andrewlau2080/IO_BOARD/.vendor/AT32F45x_Firmware_Library_V2.0.1/utilities/at32f457_emac_iap_demo/source_code/app_led3_toggle/readme.txt

/**
  **************************************************************************
  * @file     readme.txt
  * @brief    readme
  **************************************************************************
  */

  this demo is based on the at-start board, in this demo, shows the app code
  operating flow for at32f4xx series. led3 on the at-start board is twinkling
  when app code is running. for more detailed information, please refer to 
  the application note document AN0086.
