andrewlau2080/IO_BOARD/.vendor/AT32F45x_Firmware_Library_V2.0.1/utilities/at32f457_emac_iap_demo/source_code/bootloader/readme.txt

/**
  **************************************************************************
  * @file     readme.txt
  * @brief    readme
  **************************************************************************
  */

  this demo is based on the at-start board, in this demo, shows the bootloader
  operating flow for at32f4xx series. led2 on the at-start board is twinkling
  when iap bootloader is running. for more detailed information, please refer to
  the application note document AN0086.
