andrewlau2080/IO_BOARD/.vendor/AT32F45x_Firmware_Library_V2.0.1/project/at_start_f455/examples/adc/combine_ordinary_shift_tmr1trgout_dma2/readme.txt

/**
  **************************************************************************
  * @file     readme.txt
  * @brief    readme
  **************************************************************************
  */

  this demo is based on the at-start board, in this demo, shows how to use
  combine_mode(ordinary shift mode only).
  the trigger source is: tmr1trgout,,and use dma mode 2 transfer conversion data
  the convert data as follow:
  - adccom_ordinary_valuetab[n] ---> (adc2_channel_5<<16) | adc1_channel_2

  for more detailed information. please refer to the application note document AN0242.
