andrewlau2080/IO_BOARD/.vendor/AT32F45x_Firmware_Library_V2.0.1/project/at_start_f455/examples/adc/voltage_monitoring/readme.txt

/**
  **************************************************************************
  * @file     readme.txt
  * @brief    readme
  **************************************************************************
  */

  this demo is based on the at-start board, in this demo, shows how to
  monitoring adc channel's voltage.
  the trigger source is software
  the convert data as follow:
  - adc1_ordinary_valuetab[0] ---> adc1_channel_2
  - adc1_ordinary_valuetab[1] ---> adc1_channel_3
  - adc1_ordinary_valuetab[2] ---> adc1_channel_4
  the voltage monitoring channel is: adc1_channel_3

  for more detailed information. please refer to the application note document AN0242.
