andrewlau2080/IO_BOARD/.vendor/AT32F45x_Firmware_Library_V2.0.1/project/at_start_f455/examples/aes/cbc/readme.txt

/**
  **************************************************************************
  * @file     readme.txt 
  * @brief    readme
  **************************************************************************
  */

  this demo is based on the at-start board, in this demo, shows how to use 
  aes with cbc chaining mode. please refer to the application note document
  an0249.
