andrewlau2080/IO_BOARD/.vendor/AT32F45x_Firmware_Library_V2.0.1/project/at_start_f455/examples/can/loopback_mode/readme.txt

/**
  **************************************************************************
  * @file     readme.txt
  * @brief    readme
  **************************************************************************
  */

  this demo is based on the at-start board  and at32-comm-ev, in this demo, 
  shows how to use the can loopback mode. every 1s transmit one message 
  and the led4 blink, if the message can be received, led2 blink.
  set-up
  - can_tx(pd1)
  - can_rx(pd0)
  - can_stb(pb7)

  for more detailed information. please refer to the application note document AN0232.
