andrewlau2080/IO_BOARD/.vendor/AT32F45x_Firmware_Library_V2.0.1/project/at_start_f455/examples/can/transceiver_standby_mode/readme.txt

/**
  **************************************************************************
  * @file     readme.txt
  * @brief    readme
  **************************************************************************
  */

  this demo is based on the at-start board and at32-comm-ev, in this demo, 
  shows how to use the canfd transceiver standby mode. 
  the led4 on when mcu is in run mode and the canfd transceiver isn't in standby mode.
  the led4 off when mcu enter sleep mode and the canfd transceiver enter standby mode.
  it is wake up the canfd transceiver and mcu when received message, and ehco.
  set-up
  - can_tx(pd1)
  - can_rx(pd0)
  - can_stb(pb7)

  for more detailed information. please refer to the application note document AN0232.
