andrewlau2080/IO_BOARD/.vendor/AT32F45x_Firmware_Library_V2.0.1/project/at_start_f455/examples/dma/dmamux_genertor_exint/readme.txt

/**
  **************************************************************************
  * @file     readme.txt
  * @brief    readme
  **************************************************************************
  */

  this demo is based on the at-start board,  in this demo,  provides a  description
  of how to use a dmamux genertor channel send dma request to transfer a halfword 
  data buffer memory to another halfword data buffer in embedded sram.  dma1 channel4
  is configured to transfer the contents of a 16-halfword data buffer stored in 
  embedded sram memory.pa0 is input trigger signal for dmamux genertor channel1,
  genertor channel1 will send four dma request when the rising edge of pa0.when
  all data transfered, the three leds will turn on.
