andrewlau2080/IO_BOARD/.vendor/AT32F45x_Firmware_Library_V2.0.1/project/at_start_f455/examples/dma/dmamux_synchronization_exint/readme.txt

/**
  **************************************************************************
  * @file     readme.txt
  * @brief    readme
  **************************************************************************
  */

  this demo is based on the at-start board,in this demo, uses the tmr1 in dma synchronized 
  mode to send the contents of a 16-halfword data buffer stored in embedded sram memory.
  the dmamux synchronization block is configured to synchronize the dma transfer with the 
  tmr1 overflow dma request.each rising edge of pa0 the synchronization signal will authorize
  4 tmr1 requests to be transmitted src_buffer to dst_buffer using the dma.when all data 
  transfered, the three leds will turn on.
