andrewlau2080/IO_BOARD/.vendor/AT32F45x_Firmware_Library_V2.0.1/project/at_start_f455/examples/ertc/tamper/readme.txt

/**
  **************************************************************************
  * @file     readme.txt
  * @brief    readme
  **************************************************************************
  */

  this demo is based on the at-start board, in this demo, shows how to use the 
  tamper detection, the rising edge of the pc13 pin triggers an tamper event.
  for more detailed information. please refer to the application note document AN0047.
  
  attention: system need to pre configrue when pc13 need to be used!  the 
  pre-configuration code is in SystemInit() function.
