andrewlau2080/IO_BOARD/.vendor/AT32F45x_Firmware_Library_V2.0.1/project/at_start_f455/examples/exint/exint_software_trigger/readme.txt

/**
  **************************************************************************
  * @file     readme.txt
  * @brief    readme
  **************************************************************************
  */

  this demo is based on the at-start board, in this demo, shows how to use
  software trigger exint.
  software trigger will be generate in tmr1 overflow interrupt.
  led2 toggle means tmr1 overflow interrupt respond.
  led3 and led4 toggle means exint line 4  interrupt respond.
  for more detailed information. please refer to the application note document AN0104.
