andrewlau2080/IO_BOARD/.vendor/AT32F45x_Firmware_Library_V2.0.1/project/at_start_f455/examples/flash/otp_write_and_lock/readme.txt

/**
  **************************************************************************
  * @file     readme.txt
  * @brief    readme
  **************************************************************************
  */

  this demo is based on the at-start board, in this demo, test buffer will
  be wiriten to otp area and lock, then read from same address, then
  compare them. if the test is passed, the three leds will turn on.
  note: this demo can only be run once!
