andrewlau2080/IO_BOARD/.vendor/AT32F45x_Firmware_Library_V2.0.1/project/at_start_f455/examples/gpio/io_toggle/readme.txt

/**
  **************************************************************************
  * @file     readme.txt 
  * @brief    readme
  **************************************************************************
  */

  this demo is based on the at-start board, this demo toggle pa.01 forever,
  to describes how to use scr and clr register for max io toggling.
