andrewlau2080/IO_BOARD/.vendor/AT32F45x_Firmware_Library_V2.0.1/project/at_start_f455/examples/i2c/eeprom/readme.txt

/**
  **************************************************************************
  * @file     eeprom/readme.txt 
  * @brief    readme
  **************************************************************************
  */

  this demo is based on the at-start board and AT32-Comm-EV, in this demo, use hardware i2c2 
  write or read data based on the eeprom device. if the communication is
  successful, led3 will turn on, if the communication fails, led2 will keep flashing.
  
  attention:
    1. i2c bus must pull-up
    2. press the slave button first, then press the master button to start communication.

  pin used:
    1. scl --- pb10
    2. sda --- pb11

  for more detailed information. please refer to the application note document AN0091.
