andrewlau2080/IO_BOARD/.vendor/AT32F45x_Firmware_Library_V2.0.1/project/at_start_f455/examples/i2sf/halfduplex_dma_msb_justified/readme.txt

/**
  **************************************************************************
  * @file     readme.txt
  * @brief    readme
  **************************************************************************
  */

  this demo is based on the at-start board, in this demo, shows how to constitute
  a halfduplex i2s module by i2sf module.
  the pins distribution as follow:
  - halfduplex i2s
  - i2sf5 master          spi i2s slaver
  - pb6(ws)      <--->     pb12(ws)
  - pb7(ck)      <--->     pb13(ck) 
  - pb9(sd)      <--->     pb15(sd)
  - pc8(mck) 

  for more detailed information. please refer to the application note document AN0102.
