andrewlau2080/IO_BOARD/.vendor/AT32F45x_Firmware_Library_V2.0.1/project/at_start_f455/examples/pwc/power_optimization_level_set/readme.txt

/**
  **************************************************************************
  * @file     readme.txt
  * @brief    readme
  **************************************************************************
  */

  this demo is based on the at-start board, in this demo, shows how to set the ldo
  output voltage when deepsleep mode.
  
  the rising edge on pa0 will wake up deepsleep mode

  for more detailed information. please refer to the application note document AN0244.
