andrewlau2080/IO_BOARD/.vendor/AT32F45x_Firmware_Library_V2.0.1/project/at_start_f455/examples/pwc/sleep_usart1/readme.txt

/**
  **************************************************************************
  * @file     readme.txt
  * @brief    readme
  **************************************************************************
  */

  this demo is based on the at-start board, in this demo, shows how to exit
  sleep mode by interrupt of usart1 receive data buffer full.

  for more detailed information. please refer to the application note document AN0244.
