andrewlau2080/IO_BOARD/.vendor/AT32F45x_Firmware_Library_V2.0.1/project/at_start_f455/examples/qspi/xip_port_read_write_sram/readme.txt

/**
  **************************************************************************
  * @file     readme.txt 
  * @brief    readme
  **************************************************************************
  */

  this demo is based on the at-start board, in this demo, systick used for 
  delay function. qspi xip port operate write/read sram, if qspi test pass,
  led3 fresh, else led2 fresh.
  the qspi sram is ly68l6400. 
  - qspi io0   --->   pf8
  - qspi io1   --->   pf9
  - qspi io2   --->   pf7
  - qspi io3   --->   pf6
  - qspi sck   --->   pf10
  - qspi cs    --->   pg6

  for more detailed information. please refer to the application note document AN0088.
