andrewlau2080/IO_BOARD/.vendor/AT32F45x_Firmware_Library_V2.0.1/project/at_start_f455/examples/spi/halfduplex_dma/readme.txt

/**
  **************************************************************************
  * @file     readme.txt
  * @brief    readme
  **************************************************************************
  */

  this demo is based on the at-start board, in this demo, shows how to use
  dma transfer data in halfduplex mode. 
  the pins connection as follow:
  - spi2                      spi1
    pb12(cs)        <--->     pa4(cs)
    pb13(sck)       <--->     pa5(sck)
    pb14(miso)      <--->     pa7(mosi)

  for more detailed information. please refer to the application note document AN0102.
