andrewlau2080/IO_BOARD/IO_BOARD/docs/io_scan_mapping.md

# IO Scan Mapping And Position Codes

This document defines the shared firmware point model for both IO board hardware
variants. Firmware remains common; connector differences are selected by scan
profile and board wiring.

## Logical Points

| Item | Range | Position code | Notes |
|---|---:|---|---|
| Output source points | `OUT001` ... `OUT128` | `0x0001` ... `0x0080` | Driven one point at a time during scan |
| Input sense points | `IN001` ... `IN128` | `0x0101` ... `0x0180` | Read one point at a time during scan |

Position code format:

| Bits | Meaning |
|---|---|
| `bit 8` | `0` = OUT, `1` = IN |
| `bits 7:0` | 1-based point number, `1` ... `128`; `0` is invalid |

Examples:

| Logical point | Position code |
|---|---:|
| `OUT001` | `0x0001` |
| `OUT064` | `0x0040` |
| `OUT065` | `0x0041` |
| `OUT096` | `0x0060` |
| `OUT128` | `0x0080` |
| `IN001` | `0x0101` |
| `IN064` | `0x0140` |
| `IN065` | `0x0141` |
| `IN096` | `0x0160` |
| `IN128` | `0x0180` |

## Firmware Scan Profiles

| Profile ID | Firmware name | Valid OUT points | Valid IN points | Hardware variant |
|---:|---|---:|---:|---|
| `0` | `old_db50_96x96` | `OUT001` ... `OUT096` | `IN001` ... `IN096` | Legacy-compatible DB50 |
| `1` | `db78_64x4_128x128` | `OUT001` ... `OUT128` | `IN001` ... `IN128` | DB78 separated IN/OUT |
| `2` | `first_gen_1th_96x96` | `OUT001` ... `OUT096` | `IN001` ... `IN096` | `1thsch.pdf` first-gen local CD4051 board |

For `old_db50_96x96`, points `OUT097` ... `OUT128` and `IN097` ... `IN128`
are reserved and must be treated as invalid by the firmware protocol.

## Mux Bank Mapping

| Logical range | Firmware mux bank | Mux index |
|---|---|---:|
| `OUT001` ... `OUT064` | `IO_MUX_OUT_A` | `0` ... `63` |
| `OUT065` ... `OUT128` | `IO_MUX_OUT_B` | `0` ... `63` |
| `IN001` ... `IN064` | `IO_MUX_IN_A` | `0` ... `63` |
| `IN065` ... `IN128` | `IO_MUX_IN_B` | `0` ... `63` |

During a pair read, firmware selects one OUT mux channel and one IN mux channel,
waits for the settle delay, then calls `io_scan_measure_selected_pair()`.
That function is a weak stub in common builds. Product-specific measurement
code can replace it with a strong implementation.

## First-Gen `1thsch.pdf` Mapping

The first-gen local board is not Raspberry Pi based and does not use 74LS164 in
this schematic. It uses direct AT32 GPIO control of CD4051 address and enable
signals:

| Circuit half | Logical range | OUT excitation | IN sense | Firmware mux bank |
|---|---|---|---|---|
| A half | `OUT/IN001` ... `OUT/IN048` | `DAC_OUT1` / `PA4` | `ADC1_IN0` / `PA0` | `IO_MUX_OUT_A`, `IO_MUX_IN_A` |
| B half | `OUT/IN049` ... `OUT/IN096` | `DAC_OUT2` / `PA5` | `ADC2_IN2` / `PA2` | `IO_MUX_OUT_B`, `IO_MUX_IN_B` |

The first-gen schematic is specified so each CD4051 uses the natural channel
order:

```text
CD4051 channel 0 -> DACA/DACB IN0 or OUT0
CD4051 channel 1 -> DACA/DACB IN1 or OUT1
...
CD4051 channel 7 -> DACA/DACB IN7 or OUT7
```

The firmware therefore uses natural zero-based mux indexes for
`first_gen_1th_96x96`. The A/B split is still 48+48 points, but there is no
per-8-channel remap table.

The MCU2 GPIO control nets in `1thsch.pdf` page 4 are:

| Net group | MCU pins |
|---|---|
| `IN_AMUX_A0/B1/C2` | `PC0` / `PC1` / `PC2` |
| `IN_AMUX_EN0..EN7` | `PE0`, `PE1`, `PE2`, `PE3`, `PE4`, `PE5`, `PE6`, `PE7` |
| `IN_BMUX_A0/B1/C2` | `PB0` / `PB1` / `PB2` |
| `IN_BMUX_EN0..EN7` | `PE8`, `PE9`, `PE10`, `PE11`, `PE12`, `PE13`, `PE14`, `PE15` |
| `OUT_AMUX_A0/B1/C2` | `PC10` / `PC11` / `PC12` |
| `OUT_AMUX_EN0..EN7` | `PD0`, `PD1`, `PD2`, `PD3`, `PD4`, `PD5`, `PD6`, `PD7` |
| `OUT_BMUX_A0/B1/C2` | `PB10` / `PB11` / `PB12` |
| `OUT_BMUX_EN0..EN7` | `PD8`, `PD9`, `PD10`, `PD11`, `PD12`, `PD13`, `PD14`, `PD15` |

Use the latest `SCH_FIXTURE_2026-07-07.pdf`
mapping for `OUT_BMUX_EN0..EN7`: `PD8..PD15`. Do not use the older
`PD9..PD15, PC6` record for this board revision.

## Legacy DB50 Connector Mapping

Each physical DB50 connector has two corresponding 25-pin rows:

| Connector | Upper row pins 1-24 | Lower row pins 1-24 | Row pin 25 |
|---|---|---|---|
| `JOLD1` | `OUT001` ... `OUT024` | `IN001` ... `IN024` | NC |
| `JOLD2` | `OUT025` ... `OUT048` | `IN025` ... `IN048` | NC |
| `JOLD3` | `OUT049` ... `OUT072` | `IN049` ... `IN072` | NC |
| `JOLD4` | `OUT073` ... `OUT096` | `IN073` ... `IN096` | NC |

Pin formula for DB50 row pins 1-24:

| Formula | Meaning |
|---|---|
| `point = (connector_index - 1) * 24 + row_pin` | `connector_index` is `1` ... `4`; `row_pin` is `1` ... `24` |
| upper row position | `OUT%03u`, code `0x0000 | point` |
| lower row position | `IN%03u`, code `0x0100 | point` |

## DB78 64x4 Connector Mapping

| Connector | Used pins | Logical points |
|---|---:|---|
| `JOUT1` | 1-64 | `OUT001` ... `OUT064` |
| `JOUT2` | 1-64 | `OUT065` ... `OUT128` |
| `JIN1` | 1-64 | `IN001` ... `IN064` |
| `JIN2` | 1-64 | `IN065` ... `IN128` |

Pin formula for DB78 used pins 1-64:

| Connector | Formula |
|---|---|
| `JOUT1` | `OUT point = pin` |
| `JOUT2` | `OUT point = 64 + pin` |
| `JIN1` | `IN point = pin` |
| `JIN2` | `IN point = 64 + pin` |
