andrewlau2080/IO_BOARD/IO_BOARD/docs/production_line_terminal_model.md

# Production Line Terminal And Print Model

This document models the next two development blocks before the old first-gen
tester communication protocol is fully decoded.

## Current First-Gen Scan Dependency

| Item | Current status |
|---|---|
| Local scan mode | `FIRST_GEN_4051_LOCAL` implemented |
| Standard definition | AT32 self-learns a known-good 96 x 96 matrix and saves it in Flash |
| Display behavior | Left three digits show current OUT; right three digits show the current problem IN |
| Print gating rule | Print response must only be enabled after the learned-matrix scan reaches PASS |
| Block condition | If the display is stopped on a problem OUT/IN point, the tester must not send a print-ready response |

## 1. Production Line Communication Placeholder

The production line has up to 10 tester stations. Each tester normally runs its
own local IO scan. The line is a rotating loop. After an operator finishes a
board, the fixture moves to a terminal/print position. When the current tester
is detected at that position, it sends a print request to the terminal unit.

Current implementation rule:

- The printer-side polling/trigger packet has been decoded from
  `TestV1.0/analysis_outputs/useful_printer_trigger_tx_envelope.csv`.
- `src/line_comm_bridge.c` now contains this 71-segment packet as
  `LINE_COMM_CODE_PRINT_REQUEST`.
- Verified on 2026-06-03: oscilloscope testing confirmed the printer-side
  polling transmitter outputs the intended packet envelope. The previous
  continuous-carrier symptom was fixed by using DWT-based microsecond timing
  for MARK/SPACE generation and by forcing the inter-packet SPACE low.
- The tester-side response packet is generated at build time from
  `TestV1.0/analysis_outputs/useful_tester_response_tx_envelope.csv` and is
  exposed as `LINE_COMM_CODE_TESTER_RESPONSE`.
- Current firmware model waits for the printer polling packet prefix on `PB7`.
  When the first 12 segments match `LINE_COMM_CODE_PRINT_REQUEST`, it starts
  the tester response at about 24.786 ms from the detected polling packet start.
  It then transmits `LINE_COMM_CODE_TESTER_RESPONSE` once from `PB6` and
  returns to waiting for the next printer polling packet.
- Other old-link response/ack code slots remain empty until they are learned.
- Keep local tester logic independent from the terminal protocol so scanning
  and UI work can continue before the old protocol is decoded.

Firmware placeholder files:

| File | Role |
|---|---|
| `inc/line_comm_bridge.h` | Production-line communication data types and API |
| `src/line_comm_bridge.c` | Empty learned-code slots for print request/ack/busy/done |

Current reserved old-link code slots:

| Code ID | Purpose | Current status |
|---|---|---|
| `LINE_COMM_CODE_PRINT_REQUEST` | Printer polling/trigger packet for tester side | Filled, 71 MARK/SPACE segments |
| `LINE_COMM_CODE_TESTER_RESPONSE` | Tester response packet after printer trigger | Filled, 3321 MARK/SPACE segments generated from CSV |
| `LINE_COMM_CODE_PRINT_ACK` | Terminal accepts request | Empty timing table |
| `LINE_COMM_CODE_PRINT_BUSY` | Terminal is busy | Empty timing table |
| `LINE_COMM_CODE_PRINT_DONE` | Print job completed | Empty timing table |

Current printer polling transmitter settings:

| Item | Value |
|---|---:|
| Source analysis file | `TestV1.0/analysis_outputs/useful_printer_trigger_tx_envelope.csv` |
| Segment count | 71 |
| Packet duration | about 36.695 ms |
| Repeat period | about 203.147 ms |
| Inter-packet space | about 166.452 ms |
| Carrier half period | 12 us |
| Estimated carrier | about 41.7 kHz |
| Firmware output pin | `PB6` / `IR_TX` |
| Envelope debug pin | 07-07 schematic has no final PH3 debug pin assignment; use only if a new test point is explicitly added |
| Bench verification | Confirmed normal on 2026-06-03 with the old `PA7=IR_TX` bench wiring; current 2026-07-07 schematic uses `PB6=IR_TX` |

Current closed-loop tester response settings:

| Item | Value |
|---|---:|
| Source analysis file | `TestV1.0/analysis_outputs/useful_tester_response_tx_envelope.csv` |
| Printer polling prefix required | First 12 segments of `LINE_COMM_CODE_PRINT_REQUEST` |
| Response trigger delay | about 24.786 ms from polling packet start |
| Segment count | 3321 |
| Packet duration | about 2.151 s |
| Carrier half period | 13 us |
| Estimated carrier | about 38.5 kHz |
| Firmware output pin | `PB6` / `IR_TX` |
| Envelope debug pin | 07-07 schematic has no final PH3 debug pin assignment; use only if a new test point is explicitly added |
| Loop behavior | Receive prefix, transmit once, guard 100 ms, wait again |

When the learned IR frame is available, fill the placeholder like this:

```c
static const uint16_t print_request_code_us[] = {
  9000, 4500, 560, 560, /* ... learned timings ... */
};

const line_comm_ir_code_t g_line_comm_ir_codes[LINE_COMM_CODE_COUNT] = {
  {0U, sizeof(print_request_code_us) / sizeof(print_request_code_us[0]), print_request_code_us},
  /* ... */
};
```

## 2. Terminal Printer Architecture

The terminal should not try to drive every printer directly from AT32 firmware.
Use a Raspberry Pi or Linux terminal as the print server:

```text
Tester AT32 boards
  -> old learned line protocol / future UART-RS485-CAN
  -> Terminal controller
  -> CUPS / IPP / printer driver layer
  -> USB / Ethernet / Wi-Fi printer
```

Recommended approach:

| Layer | Responsibility |
|---|---|
| Tester AT32 | Scan result, station ID, product ID, print request trigger |
| Terminal app | Dialog/input UI, label template, job queue, print history |
| CUPS/Linux print system | Printer discovery, driverless IPP, vendor driver support |
| Printer | Actual output device |

This is the only practical way to support a wide printer range. Direct MCU
printer support should be limited to known label-printer languages such as
ESC/POS, TSPL, ZPL, or CPCL after the exact printer family is selected.

## 3. Print Job Data Model

Firmware placeholder files:

| File | Role |
|---|---|
| `inc/print_job_model.h` | Common label fields and sizes |
| `src/print_job_model.c` | ASCII label formatting helper |

Initial fields:

| Field | Example | Notes |
|---|---|---|
| `title` | `HARNESS TEST` | Label header |
| `item` | `MODEL-A` | Product/model name |
| `content` | `LINE 01 STATION 03` | Body/content |
| `code` | `A1B1-000001` | Human-readable code or barcode text |
| `quantity` | `1` | Quantity/count |
| `pass` | `PASS` | Test result |

For the MCU-side model, keep the first stage ASCII-only because it is simple,
stable, and compact. The terminal UI can use UTF-8 and real fonts when printing
PDF or raster output through CUPS.

## 4. UI Model

The first visual model is:

| File | Role |
|---|---|
| `terminal/print_terminal_mockup.html` | Browser-based terminal dialog and label preview |

The mockup has:

- Station selection for 10 tester stations.
- Title, item/model, content, code, quantity, result, and copies fields.
- Label preview similar to a product label.
- Print queue preview.

This is not the final terminal program. It fixes the field layout and workflow
before choosing the final UI technology.

## 5. Future Runtime Flow

```text
1. Tester learns a known-good harness matrix and stores it in Flash.
2. Operator runs normal test; tester scans row by row.
3. If a problem is found, tester display stays on current OUT/problem IN and print is blocked.
4. After all rows pass, tester enters print-ready state.
5. Fixture reaches print terminal sensor position.
6. Tester receives the learned printer polling prefix.
7. Tester sends the learned tester response code.
8. Terminal receives request and loads the current label template.
9. Operator can edit title/item/content/code through terminal key input.
10. Terminal prints through CUPS.
11. Terminal sends PRINT_DONE or PRINT_BUSY/ERROR to tester when that return code is decoded.
```

## 6. Firmware Integration Status

| Step | Firmware block | Status |
|---:|---|---|
| 1 | First-gen scanner | Full learned-matrix PASS sets `g_first_gen_print_ready` |
| 2 | IR receiver | Printer polling prefix is captured on `PB7` while print-ready is armed |
| 3 | IR transmitter | `LINE_COMM_CODE_TESTER_RESPONSE` is transmitted on `PB6` after the learned delay |
| 4 | State control | NG/unlearned states block response; current implementation clears print-ready after one response |
| 5 | Debug counters | Poll match, reject, response sent, blocked, ready, and waiting states are exposed as watch variables |
| 6 | Bench test | Next required step: verify timing with oscilloscope and confirm terminal/printer receives the response |

## 6A. Line Communication Transport Layer

Current firmware now separates line communication from the scan and print
business logic through `line_comm_transport`.

| Role | Current backend | Firmware behavior |
|---|---|---|
| Scanner / tester | IR transmit | After PASS, sends `LINE_COMM_CODE_PRINT_REQUEST` once as a print trigger |
| Print terminal | IR receive | Polls for the `LINE_COMM_CODE_PRINT_REQUEST` prefix and prints the current LCDM job when it matches |
| Future wireless | Placeholder | Add a wireless UART/Sub-GHz/LoRa backend behind the same transport API |
| Future wired | Placeholder | Add RS485 backend behind the same transport API |

The present IR trigger is a fixed learned waveform. It only means "print now";
it does not carry variable fields such as station, product, result, or serial
number. Those fields are still edited on LCDM or held in the terminal state.
When the wireless UART/RS485 backend is added, `line_comm_print_request_t` can
be serialized to carry station/result/test count without changing the scan or
print modules.

Detailed transport planning is tracked in `docs/line_comm_transport_plan.md`.

## 7. Open Decisions

| Decision | Current placeholder |
|---|---|
| Old first-gen protocol waveform | Polling and tester response are available; ACK/BUSY/DONE still require learned timing data |
| Print terminal hardware | Raspberry Pi/Linux terminal recommended |
| Exact printer class | CUPS first; direct ESC/POS/TSPL/ZPL only after printer is fixed |
| Label size | Mockup default; final size to be updated after printer/label media selection |
| Key input method | Independent module later |
