andrewlau2080/IO_BOARD/IO_BOARD/docs/wifi_mas_network_architecture.pptx

WiFi / MAS 组网架构说明

用于设计评审、演示和后续跟踪

每条拉本地闭环生产，MAS 负责上级管理和统计

先固定组网与互联框架
每条拉配置微型/工业 AP
WiFi 模块型号后续再选

车间十几条拉

每条拉约 10 台测试机

每条拉 1 台 AP + 打印主机

MAS 断线仍可本线打印

IO BOARD WiFi / MAS

## Slide 2

MAS 在系统中的角色

MAS 负责上级管理和统计，不是本线打印的前置条件

为什么需要 MAS

• 统一监控所有测试机和打印机
• 集中保存测试、打印、报警记录
• 支持电脑、手机、手持机查看
• 为后续数据分析提供完整资料

不能直接互连

• 多台测试机抢同一台打印机
• 跨线统计和追溯困难
• 换机、换打印机管理复杂
• APP 无法稳定同时监控多条线

MAS 的定位

• 监控中心
• 统计中心
• 资料版本中心
• 历史追溯中心

IO BOARD WiFi / MAS

## Slide 3

车间网络拓扑

每条拉有本地 AP 和打印主机，MAS 断线不影响本线打印

MAS / Monitor / Statistics Server

Factory Ethernet / VLAN / Uplink

Line 01 微型/工业 AP

ST01 ... ST10 WiFi Station
AT32 Print Host
Printer

Line 02 微型/工业 AP

ST01 ... ST10 WiFi Station
AT32 Print Host
Printer

Line NN 微型/工业 AP

ST01 ... ST10 WiFi Station
AT32 Print Host
Printer

正式方案：每条拉 1 个独立微型/工业 AP；AP 只提供网络，生产逻辑由本线 AT32 打印主机完成。

IO BOARD WiFi / MAS

## Slide 4

系统分层

上层业务协议不绑定 WiFi 模块，模块以后可替换

设备层
测试机 + WiFi

线体层
AP + 打印主机

车间层
VLAN / Uplink

MAS 层
监控/统计/DB

客户端
APP/电脑

测试机

• 本地扫描
• PASS/NG
• 故障点
• 上传事件

AT32 打印主机

• 本线主控
• 打印队列
• 本地缓存
• 继续打印

网络

• VLAN 隔离
• MAS 同步
• NTP
• 远程维护

MAS

• 全车间监控
• 历史记录
• 统计报表
• 资料管理

客户端

• 查看
• 报警
• 统计
• 追溯

IO BOARD WiFi / MAS

## Slide 5

正常测试与打印流程

打印关键路径在本线闭环内完成，MAS 只接收同步和做统计

测试机 -> 本线主机
heartbeat

本地扫描
PASS/NG

结果到打印主机
缓存/可同步 MAS

PB8 触发
打印请求

打印主机
排队打印

打印状态
DONE/ERROR

测试机

• 不直接控制打印机
• 发给本线打印主机

打印主机

• 本线队列
• 驱动打印机
• 缓存结果

MAS

• 接收同步
• 统计报表
• 刷新电脑/APP

IO BOARD WiFi / MAS

## Slide 6

MAS 断线时仍可生产打印

MAS 不是打印前置条件；本线打印主机是 AT32 打印主机

测试机 ST01-ST10

本线 AP

打印主机
本地队列/缓存

打印机

MAS 离线
不影响打印

MAS 断线

• 本线 AP 仍工作
• 打印主机继续接收请求

缓存位置

• 主要存在 AT32 打印主机
• 测试机只做短缓存

恢复后

• 打印主机按 event_id 补传
• MAS 去重并生成统计

IO BOARD WiFi / MAS

## Slide 7

对码与换机流程

打印主机本地完成换机；MAS 在线即同步，离线后补传

K1+K4
进入对码

PAIR_REQ
UID/短码

LCDM 选择
绑定/替换

PAIR_ASSIGN
Line/Station/Profile

PAIR_ACK
保存成功

换机原则

• 工位不变
• 新 UID 替换旧 UID
• 旧设备 inactive

资料恢复

• 产品资料
• 学习线序
• 打印规则
• 无需重新学习

记录连续

• 本线先保存
• binding_event 后同步

IO BOARD WiFi / MAS

## Slide 8

CSV / Profile 下发

测试规划先到本线 AT32 打印主机，再由打印主机分发给各测试机

AT32 打印主机
校验/保存/生成 CRC

PC 上位机
CSV 编辑/导入

本线 AP
只提供网络

ST01-ST10
profile_push

MAS 在线
接收 profile_sync

CSV 内容

• OUT/IN 对应关系
• 开路/短路/GND/NC
• 必测标志和版本

主机校验

• 范围检查
• 重复/冲突检查
• profile_rev + crc32

断网处理

• 使用已保存 profile
• 继续生产打印
• 恢复后补传 MAS

IO BOARD WiFi / MAS

## Slide 9

MQTT / API 数据通道

本线消息先到打印主机；打印主机再同步 MAS

telemetry

event

state

cmd

ack

Topic: factory/{factory}/workshop/{workshop}/line/{line}/device/{uid}/{suffix}

设备 -> 打印主机

• heartbeat
• test_result
• print_request
• alarm

打印主机 <-> MAS

• 缓存同步
• profile_sync
• summary
• history

API / Dashboard

• 历史查询
• 统计报表
• 手机 APP
• 电脑监控

IO BOARD WiFi / MAS

## Slide 10

测试机状态机

网络只是上传、同步和打印请求通道，本地测试必须独立运行

BOOT

WIFI_CONNECT

REGISTER

SYNC_CONFIG

READY

TESTING

LEARNING

PASS_READY

PRINT_REQUESTED

PRINT_DONE

PAIRING

OFFLINE_CACHE

ERROR_LOCK

原则：本地测试不依赖 MAS；测试机连不上打印主机时短缓存，恢复后先补给打印主机。

IO BOARD WiFi / MAS

## Slide 11

打印主机状态机

每条线保留一台打印主机，负责本线绑定、队列、打印和缓存

BOOT

REGISTERING

LOAD_CONFIG

LINE_READY

PRINTING

本线主机

• 保存 ST01-ST10 绑定
• 保存当前产品资料
• 保存标签模板

打印队列

• 接收 print_request
• 生成标签
• 回传 DONE/ERROR

离线能力

• MAS 离线仍可打印
• 本地缓存后补传

IO BOARD WiFi / MAS

## Slide 12

数据记录与统计

测试记录、打印记录、报警记录统一入库，后续数据分析从数据库生成

主表

• devices
• line_bindings
• products
• profiles
• test_results
• print_jobs
• device_events
• alarms

统计输出

• 每条线产量
• 工位 PASS/NG 率
• 常见故障点 OUT/IN
• 打印失败率
• 设备在线率
• 单件 serial 追溯

客户端显示

• 车间总览
• 线体状态
• 单机状态
• 报警确认
• 趋势报表
• 换机辅助

IO BOARD WiFi / MAS

## Slide 13

断网缓存与可靠性

MAS 异常不影响本线打印；缓存主要放在 AT32 打印主机

断网场景

• 测试机到打印主机断开
• 打印主机到 MAS 断开
• MAS 服务器离线
• 重复上报
• 时间未同步

处理策略

• 本地继续测试
• 本线继续打印
• 打印主机为主缓存
• event_id 去重
• 恢复后补传

建议容量

• 测试机 200-1000 条短缓存
• 打印主机 5000-50000 条
• 打印机本体不做业务缓存
• 优先用 eMMC/SD/外部 Flash/FRAM

IO BOARD WiFi / MAS

## Slide 14

WiFi 模块边界

第一版按 ESP32-C3-WROOM-02U/02 设计，AT32 保持业务主控

业务层
scan/print/pair

mas_protocol
JSON/ACK

net_service
UART 通道

ESP32-C3-WROOM
WiFi 协处理器

第一版优先

• 打印主机: WROOM-02U
• 测试机: 02U 或 02
• AT32 仍做业务主控

PCB 风险

• 19-25 内部 GND
• 必须按规格书回流焊
• 天线区域严格禁布

维修友好

• 可做 WiFi 子板
• 主板只留 J_WIFI
• 后续换型不大改板

IO BOARD WiFi / MAS

## Slide 15

WiFi PCB 连接

参考 docs/esp32-c3-wroom-02_datasheet_cn.pdf 和 wifi_module_pcb_connection_plan.md

AT32 PC3候选
WIFI_TX

ESP32 Pin11
RXD

EN不占AT32
上拉+RESET_TP

BOOT不占AT32
上拉+BOOT_TP

AT32 PB9候选
WIFI_RX

ESP32 Pin12
TXD

3V3_WIFI
>=500mA 峰值

GND 焊盘
含内部 19-25

原理图

• PC3->RXD, PB9<-TXD
• PA1/PA3/PD8 禁用
• EN/BOOT 只留测试点

电源

• 模块旁 10uF + 0.1uF
• 可加 22uF/47uF
• WiFi 分支预留磁珠/0R

布局

• 02U 外接天线
• 02 板载天线禁布
• 优先参考刘氏PDF规格书

IO BOARD WiFi / MAS

## Slide 16

下一步实施计划

先做本线 AP + 打印主机闭环，再接 MAS 同步和模块验证

阶段 1: 架构与原型

• 设备身份和绑定表
• MQTT topic / JSON 消息
• CSV/Profile 上传流程
• WiFi PCB 连接规格

阶段 2: 固件接入

• net_service 抽象
• event_queue 断网缓存
• print_request WiFi 后端
• pair_req / pair_assign

阶段 3: 模块验证

• WROOM-02U 直贴
• WiFi 子板
• 天线和距离测试
• 可靠性和干扰测试

IO BOARD WiFi / MAS
