andrewlau2080/IO_BOARD/IO_BOARD/docs/hardware_redesign_change_list_2026-07-02.docx

# IO BOARD 硬件更改清单 2026-07-02

用途：给重新设计原理图和 PCB layout 使用。依据为当前调试后的固件状态、SCH_FIXTURE_2026-06-30.pdf、红外打印 LOGIC 测试结果，以及当前产品规划。

说明：扫描/LEDM 测试机与打印接收/LCDM 主机可以共用固件源码，但硬件产品角色应独立，避免共享引脚冲突。

# 总体原则

序号 | 项目 | 结论 | 原因/说明 | 优先级
1 | 模块独立 | 扫描/LEDM 测试机与打印接收/LCDM 主机不要在同一硬件上同时使用共享接口 | 固件可统一，但硬件 BOM/连接必须按产品角色选择，否则 PB6/PB7、PA9/PA10 等资源会冲突 | 必须
2 | 电平 | 所有 MCU IO 外部信号必须限制在 0-3.3V | AT32F455 GPIO 不允许直接承受 5V 输入；4051 建议 3.3V 供电 | 必须
3 | 测试点 | IR_TX、IR_RX、LEDM_CLK/TX、LEDM_DIO/RX、SWDIO、SWCLK、NRST 必须加测试点 | 本轮调试证明没有测试点会严重拖慢定位 | 必须

# 公共硬件必须修改

序号 | 模块 | 当前/风险 | 建议修改 | PCB Layout 注意事项 | 优先级
1 | SWD 调试口 | 必须确认没有把 PA13 占作 DEBUG_TTL_TX 或其它功能 | J_SWD 固定为：VREF/3.3V、GND、PA13/SWDIO、PA14/SWCLK、NRST | SWD 走线短、旁边放 GND；NRST 上拉 10k，可加 100nF 到 GND | 必须
2 | NRST | 调试和量产下载需要稳定复位 | 新增或确认 NRST 到 SWD 口和复位按键 | NRST 远离强干扰，保留测试点 | 必须
3 | BOOT0 | 防止上电进错模式 | BOOT0 默认 10k 下拉到 GND，可加跳帽到 3.3V | 靠近 MCU，避免悬空 | 建议
4 | 3.3V 电源 | TM1637、4051、IR 接收头均依赖 3.3V | 每个模块接口附近加 100nF；IR 接收头旁加 100nF + 4.7uF | 电源线宽足够，IR LED 驱动电流不要从 MCU IO 直接供 | 必须

# 扫描 IO 与 4051

序号 | 信号/模块 | MCU 引脚 | 建议修改 | 原因/说明 | 优先级
1 | OUT_A 地址 | PC10/PC11/PC12 | 保留 | 当前固件 io_board.c 使用这 3 根控制 OUT_A 4051 地址 | 必须
2 | OUT_A EN | PD0-PD7 | 保留，低有效 | 4051 inhibit/enable 默认禁用，高电平禁用，选中时拉低 | 必须
3 | OUT_B 地址 | PB10/PB11/PB12 | 若 B 区暂时不用，可保留但允许 DNP | 当前程序可屏蔽 B 区，硬件建议预留方便后续扩展 | 建议
4 | OUT_B EN | PD9-PD15、PC6 | 按新版图纸/固件保留，不要接成 PD8-PD15 | 之前已核对过 OUT_B 第 8 路是 PC6 | 必须
5 | IN_A 地址 | PC0/PC1/PC2 | 保留 | 当前固件使用 | 必须
6 | IN_A EN | PE0-PE7 | 保留，低有效 | 当前固件使用 | 必须
7 | IN_B 地址 | PB0/PB1/PB2 | 若 B 区暂时不用，可保留但允许 DNP | 后续扩展用 | 建议
8 | IN_B EN | PE8-PE15 | 若 B 区暂时不用，可保留但允许 DNP | 后续扩展用 | 建议
9 | 扫描输出激励 | PA4/PA5 | 保留测试点；确认通过前端进入 4051/线束 | 当前程序使用 PA4/PA5 作输出激励，前端需匹配 3.3V IO | 必须
10 | 扫描输入检测 | PA0/PA2 | 保留测试点；当前暂按普通数字输入验证 | ADC 方案此前不稳定，硬件需预留可选 RC/保护/分压，避免直接 5V | 必须
11 | 4051 供电 | 74HC4051 VCC | 统一 3.3V 供电 | MCU 3.3V 控制 HC4051 在 3.3V 供电下电平匹配 | 必须
12 | 外部输入保护 | IN/OUT 到 4051/MCU | 加限流/钳位/分压或明确只允许 3.3V | 任何外部 5V 都不能直接进入 3.3V 4051/MCU | 必须

# LEDM / TM1637 显示与按键

序号 | 信号 | MCU 引脚 | 建议连接 | 原因/说明 | 优先级
1 | LEDM_CLK 或 LEDM_TX | PA9 | 接 TM1637 CLK；若使用串口 LEDM，则接模块 RX | 当前 PCB 没引出 PA6/PA7，最终采用 PA9/PA10；注意名称按模块类型定义 | 必须
2 | LEDM_DIO 或 LEDM_RX | PA10 | 接 TM1637 DIO；若使用串口 LEDM，则接模块 TX | 当前固件 TM1637 使用 PA9/PA10 作为 GPIO，不是 USART | 必须
3 | LEDM 电源 | 3.3V/GND | J_LEDM 至少 4 pin：3.3V、GND、PA9、PA10 | 选 3.3V 可用的 TM1637/LEDM 模块 | 必须
4 | 上拉 | PA9/PA10 | 若 TM1637，建议 4.7k-10k 上拉到 3.3V，或确认模块自带 | TM1637 CLK/DIO 开漏方式更稳 | 建议
5 | 按键 | TM1637 键盘 | K1-K4 使用 TM1637 键值，不建议另接 PC4-PC9 作为主按键 | 当前程序主要按 TM1637 键值定义：K1/K2/K3/K4 | 必须
6 | USART1 冲突 | PA9/PA10 | 使用 LEDM 时，不要同时接 RS485/RPI USART1 | PA9/PA10 已被 LEDM 占用 | 必须

# 红外打印通讯

序号 | 信号/模块 | 当前临时脚 | 建议最终硬件 | 原因/说明 | 优先级
1 | IR_TX | PB7 | 保留 PB7 作为 IR_TX，但必须用三极管/MOSFET 驱动 IR LED，不要 MCU 直接带 LED | PB7 已验证可输出；正式建议用硬件 PWM 载波 + 包络开关 | 必须
2 | IR_RX | PB6 | 接 38kHz 解调红外接收头 OUT，优先 3.3V 接收头 | PB6 当前用于接收返回/轮询信号；输入需上拉到 3.3V | 必须
3 | IR 接口 | J_IR | 建议 4-6 pin：3.3V、GND、IR_TX_LED+、IR_TX_DRV、IR_RX_OUT、可选 5V_LED | 方便独立调试和更换发射/接收组件 | 必须
4 | IR_TX 驱动极性 | PB7 高电平 = 发光 | 硬件按高电平打开驱动设计；若硬件反相，固件必须同步改极性 | 避免 MARK/SPACE 反相导致接收端不能解码 | 必须
5 | IR LED 电流 | 外接驱动 | 低边 N-MOS 或 NPN，串联限流电阻；按距离选择 20-100mA 脉冲电流 | MCU IO 不能直接输出大电流 | 必须
6 | IR 接收头供电 | 3.3V | 接收头旁 100nF + 4.7uF；OUT 到 PB6 可加 100R 串联 | 降低误码和供电噪声 | 建议
7 | 载波生成 | PB7/TMR4_CH2 或其它确认可 PWM 的脚 | 最终 PCB 要确认 IR_TX 引脚支持定时器 PWM；PB7 已实测能出约 38k | 正式代码应避免软件翻转载波的时序误差 | 必须
8 | 与 LCDM 冲突 | PB6/PB7 | 扫描/LEDM 测试机可用 PB6/PB7 做 IR；打印/LCDM 主机若用 PB6/PB7 做 LCDM 控制，则不能同时接 IR | 两种产品独立，BOM 或连接器要分开 | 必须

# 打印接收 / LCDM 主机硬件

序号 | 模块 | MCU 引脚/接口 | 建议修改 | 原因/说明 | 优先级
1 | LCDM SPI/控制 | PB3/SCK、PB5/MOSI、PB4/RESET、PB6/CMD、PB7/CS、PB8/BL | 打印主机保留 LCDM 接口；不要和测试机 IR PB6/PB7 同时使用 | LCDM 主机是另一类产品，可编译同固件但硬件角色不同 | 必须
2 | 打印机 RS485 | UART + RS485 收发器 | 增加 A/B、GND、屏蔽/机壳地可选；120R 终端电阻用拨码/跳帽 | 兼容 Zebra/其它打印机串口调试 | 必须
3 | RS485 方向控制 | 预留 DE/RE GPIO | 即使当前未定，也建议预留 0R/跳线或 MCU 控制脚 | 后续不同收发器/协议可能需要方向控制 | 建议
4 | 打印机参数调试 | LCDM | 硬件保留 LCDM 触摸串口/屏接口，软件可设置波特率、协议、标签内容 | 后续兼容不同机型 | 建议
5 | 无线模块 | ESP8266/ESP32 或 Sub-GHz UART | 预留 4-6 pin UART 模块口：3.3V、GND、TX、RX、EN/RST | 后续 10 台以上测试机联网/MES 兼容 | 建议

# PCB Layout 注意事项

序号 | 项目 | 要求 | 优先级
1 | IR_TX/PB7 | 从 MCU 到驱动管栅极/基极走线短；驱动管靠近 IR LED 接口；电流回路不要穿过 MCU 模拟输入区域 | 必须
2 | IR_RX/PB6 | 接收头远离 IR 发射大电流回路；OUT 线短，旁边走 GND；供电去耦贴近接收头 | 必须
3 | PA0/PA2 输入 | 远离 IR LED、RS485、LCD 背光大电流；保留滤波/保护位置 | 必须
4 | 4051 模拟路径 | IN/OUT 线束路径保持清晰，避免和高速/大电流线平行长距离耦合 | 必须
5 | SWD | 接口靠边，线短；PA13/PA14 不要串太大电阻，建议 22R-100R 以内或 0R | 必须
6 | 接口丝印 | 所有外接连接器标清方向和电平：3.3V、GND、TX/RX 或 CLK/DIO | 必须

# 当前固件对应关系

功能 | 当前固件引脚 | 备注
LEDM/TM1637 | PA9=CLK、PA10=DIO | 使用 GPIO 时序和 TM1637 键值
IR 打印测试 | PB7=IR_TX、PB6=IR_RX | 当前调试脚；正式建议硬件 PWM 载波
扫描输出 | PA4/PA5 | 数字输出激励
扫描输入 | PA0/PA2 | 当前按数字输入验证，ADC 暂不作为唯一依据
DEBUG_OUT | PH3 | 调试测试点
SWD | PA13/PA14/NRST | 必须保留，不得挪用
