andrewlau2080/IO_BOARD/IO_BOARD/docs/project_tracking_report_2026-05-28.docx

# IO BOARD 项目模型与变更状态跟踪表

项目 | 内容 | 项目 | 内容
整理日期 | 2026-05-28 | 项目目录 | /Users/andrewlau/qtprj/ARTERY
主工程 | IO_BOARD | 目标 MCU | AT32F455VET7 / LQFP100
当前主程序 | TM1637 六位七段数码管应用模拟版 | 当前重点 | 先建模型，加速扫描、显示、旧机通讯、打印终端后续整合

# 1. 模型总览对比表

序号 | 模块/模型 | 状态 | 已完成内容 | 关键文件 | 风险/未定项 | 下一步
1 | 开发环境与调试链路 | 可用 | Mac/Ubuntu CMake 构建；Ubuntu pyOCD 烧录；VS Code/OpenOCD 调试路径已记录。 | AGENTS.md IO_BOARD/README.md | 烧录前需确认 ICE USB 已接入 Ubuntu VM。 | 继续保持 Mac 与 Ubuntu 同步。
2 | 硬件分型 | 已建档 | 旧 DB50 与 DB78 64x4 两个硬件分型已拆目录；程序仍共用根工程。 | IO_BOARD/hardware/old_db50/ IO_BOARD/hardware/db78_64x4/ | PCB 和 BOM 仍需按最终方案细化。 | 继续补原理图、BOM、布局规则。
3 | IO 扫描模型 | 框架完成 | OUT/IN 位置码；profile；mux bank；扫描矩阵；单点/全点扫描 API。 | inc/io_scan.h src/io_scan.c docs/io_scan_mapping.md | 真实检测读取函数尚未实现。 | 实现 io_scan_measure_selected_pair() 并接入硬件检测。
4 | 树莓派/终端通讯协议 | 框架完成 | 二进制帧、CRC16、扫描命令、LED 七段命令、打印终端命令预留。 | inc/rpi_protocol.h src/rpi_protocol.c docs/rpi_protocol.md | 物理层 UART/RS485/CAN 尚未定稿。 | 实现命令分发器和真实串口收发。
5 | TM1637 显示与按键 | 已烧录测试 | J8 上 PA9=CLK、PA10=DIO；六位显示；四键读取。 | inc/tm1637_display.h src/tm1637_display.c docs/led7seg_module_selection.md | 最终面板按键顺序、亮度、电源电压还需实物确认。 | 按最终面板丝印调整键值映射和显示内容。
6 | 单 MCU 应用显示模拟 | 可运行 | 自检：A01b01 到 A92b92 后 StPASS；自动测试：A01b01 到 A92b92 后 AUPASS；重启/复位键有效。 | src/main.c | 当前只是显示模拟，没有真实 IO 判断。 | 接入扫描结果，错误时停留并显示 NG/SC/OP。
7 | 红外学习/回放工具 | 工具性质 | PA6 接收、PA7 发射；记录 timing 表；生成 HTML/SVG 波形。 | inc/ir_remote.h src/ir_remote.c debug/ir_render.py | 不是最终主程序；后续主要用于学习旧机码。 | 抓旧一代机与打印终端通讯码。
8 | 旧一代机/终端通讯占位 | 空槽已建 | 预留 PRINT_REQUEST、ACK、BUSY、DONE 四组 learned timing 码位。 | inc/line_comm_bridge.h src/line_comm_bridge.c | 旧机协议还未解码，码表为空。 | IR 学习后把 timing 数组直接填入空槽。
9 | 打印任务数据模型 | 模型完成 | 定义 title、item、content、code、quantity、copies、pass 等字段；支持 ASCII 标签格式化。 | inc/print_job_model.h src/print_job_model.c | 中文/字体/条码最终由终端侧处理。 | 对接终端 UI 和打印队列。
10 | 打印终端 UI 模型 | HTML 原型完成 | 10 台测试机选择；抬头、款项、内容、代码、数量、PASS/NG、份数；标签预览和队列。 | terminal/print_terminal_mockup.html docs/production_line_terminal_model.md | 打印机型号、标签纸尺寸、输入键盘方式未定。 | 按实际打印机和标签尺寸修改原型。

# 2. 当前固件运行行为表

项目 | 当前定义 | 显示例子 | 说明
显示硬件 | 六位 TM1637，地址 0xC0 到 0xC5 | A01b01 | 左三位为 A 端，右三位为 B 端。
接线 | J8 USART1 引脚当 GPIO 使用 | PA9=CLK，PA10=DIO | TM1637 不是 UART，只借用 J8 两根线。
按键 1 | 自检 | A01b01 ... A92b92 ... StPASS | 当前不检测 IO，只模拟显示流程。
按键 2 | 自动测试 | A01b01 ... A92b92 ... AUPASS | 当前不检测 IO，只模拟显示流程。
按键 3 | 重新开始 | 重跑上一次模式 | 上一次是自检就重跑自检，上一次是自动测试就重跑自动测试。
按键 4 | 复位重来 | 000000 | 停止当前流程并清屏到零。

# 3. 硬件方案对比表

方案 | 连接器 | 有效点数 | 显示/上位机 | 当前文档 | 当前状态
旧 DB50 单 MCU 版 | 4 个 DB50；每个上/下对应 24 组；第 25 组 NC | 96 OUT + 96 IN | 本地 TM1637/LED 七段显示；后续可加蜂鸣器/按键 | hardware/old_db50/README.md hardware/old_db50/BOM.md | 规格/BOM 基线已建
DB78 64x4 版 | 2 个 OUT DB78 + 2 个 IN DB78；每个用 64 PIN | 128 OUT + 128 IN | 树莓派/LCDM/上位系统 | hardware/db78_64x4/README.md hardware/db78_64x4/BOM.md | 规格/BOM 基线已建

# 4. 通讯与打印终端对比表

通道/对象 | 用途 | 当前实现 | 未完成点 | 建议路线
旧一代机协议 | 测试机到打印终端的旧通讯 | 已建 line_comm_bridge 空槽 | 未抓到真实码表 | 用 IR 学习程序抓码后填入 timing 数组。
树莓派/终端协议 | 新系统扫描、状态、打印请求 | 已定义二进制帧和命令号 | 未实现物理收发和命令分发 | 样机优先 UART；长线/多机再考虑 RS485/CAN。
打印机适配 | 支持市面打印机 | 终端模型已建 | 不应由 AT32 直接适配所有打印机 | 树莓派/Linux + CUPS/IPP/厂家驱动。
标签输入 UI | 抬头、款项、内容、代码、数量、份数 | HTML mockup 已建 | 按键输入程序独立开发 | 先定字段和标签版面，再接真实输入和打印。

# 5. 构建/同步/烧录状态表

环境 | 命令/路径 | 最近状态 | 备注
macOS | cd IO_BOARD && cmake --build build | 通过 | 使用本机 xPack ARM GCC。
Ubuntu VM | /home/andrew/ARTERY/IO_BOARD | 通过 | 已同步源码、文档、终端 mockup。
烧录 | Ubuntu pyOCD + AT-Link/ICE | 最近已烧录 TM1637 应用模拟版 | 本次文档重排未重新烧录。

# 6. 待办优先级表

优先级 | 任务 | 依赖 | 完成标准 | 负责人/位置
高 | 接入真实 IO 检测 | 检测电路/阈值确认 | 自检/自动测试能在错误点停留并显示故障类型。 | io_scan_measure_selected_pair()
高 | 旧机通讯码学习 | 拿到旧测试机/打印端实物 | PRINT_REQUEST/ACK/BUSY/DONE 四组码表填入并可发射/接收。 | line_comm_bridge.c
中 | 打印终端 UI 定稿 | 打印机、标签纸、输入方式 | 标签字段和版面确认，可进入实际终端程序。 | terminal/print_terminal_mockup.html
中 | 树莓派/终端程序选型 | 终端硬件确定 | 确定 Web/Qt/Python 等技术路线。 | 终端应用目录后续新增
中 | 硬件原理图/PCB | 旧 DB50 或 DB78 方案优先级 | 完成原理图、BOM、PCB 初版。 | IO_BOARD/hardware/
低 | 文档持续维护 | 每次阶段变更 | 本 Word 表格版本保持更新。 | project_tracking_report_*.docx
