andrewlau2080/IO_BOARD/IO_BOARD/docs/SCH_FIXTURE_2026-06-30_IO核对与修改建议.docx

# SCH_FIXTURE_2026-06-30 IO脚位核对与修改建议

## 1. 基本信息

项目 | 内容
依据图纸 | IO_BOARD/docs/SCH_FIXTURE_2026-06-30.pdf，第3页 MCU2 为主
目标MCU | AT32F455VET7，LQFP100
核对目的 | 明确扫描4051、SWD烧录、LCDM/LEDM显示、USART、CAN、调试和按键脚位，给出画图修改建议
结论摘要 | 4051扫描脚基本可保留；必须优先修正/确认 SWDIO/SWCLK、PA9/PA10显示冲突、LCDM SPI脚代码缺口、PA6/PA7 IR未在图纸确认。

## 2. 总体结论和优先级

模块 | 图纸现状 | 问题 | 建议
4051扫描脚 | IN/OUT A/B 地址线和使能线 | 和当前修正后的 io_board.c 一致 | 保留
OUT_BMUX_EN | PD9..PD15, PC6 | 新版图纸明确不是 PD8..PD15 | 保留当前修正版
SWD烧录 | 图纸J4标 SWCLK/SWDIO，但MCU侧疑似 PA14/PA15；PA13被 DEBUG_TTL_TX 占用 | 标准SWD应使用 PA13=SWDIO、PA14=SWCLK | 必须改/必须确认
PA9/PA10 | 图纸为 USART_TX/USART_RX | 旧TM1637代码使用 PA9/PA10 做 CLK/DIO，会冲突 | 必须改
LCDM接口 | PB3/PB4/PB5/PB6/PB7/PB8 | 图纸已有 LCDM/LCM 接口，代码只初始化部分控制脚 | 建议按LCDM实现
LEDM/TM1637 | 图纸未见独立 LEDM/TM1637 CLK/DIO | 若要两组LED模块，需新增接口或占用空余GPIO | 必须决定
PA6/PA7 | 图纸无 IR_RX/IR_TX 网名 | 旧IR打印代码使用 PA6/PA7，不可直接上板 | 必须确认

## 3. CD4051扫描IO核对表

图纸网络 | MCU脚 | 当前固件位置 | 结论
IN_AMUX_A0 | PC0 | io_board.c in_a_addr[0] | 一致
IN_AMUX_B1 | PC1 | io_board.c in_a_addr[1] | 一致
IN_AMUX_C2 | PC2 | io_board.c in_a_addr[2] | 一致
IN_AMUX_EN0..EN7 | PE0, PE1, PE2, PE3, PE4, PE5, PE6, PE7 | io_board.c in_a_en[] | 一致
IN_BMUX_A0 | PB0 | io_board.c in_b_addr[0] | 一致
IN_BMUX_B1 | PB1 | io_board.c in_b_addr[1] | 一致
IN_BMUX_C2 | PB2 | io_board.c in_b_addr[2] | 一致
IN_BMUX_EN0..EN7 | PE8, PE9, PE10, PE11, PE12, PE13, PE14, PE15 | io_board.c in_b_en[] | 一致
OUT_AMUX_A0 | PC10 | io_board.c out_a_addr[0] | 一致
OUT_AMUX_B1 | PC11 | io_board.c out_a_addr[1] | 一致
OUT_AMUX_C2 | PC12 | io_board.c out_a_addr[2] | 一致
OUT_AMUX_EN0..EN7 | PD0, PD1, PD2, PD3, PD4, PD5, PD6, PD7 | io_board.c out_a_en[] | 一致
OUT_BMUX_A0 | PB10 | io_board.c out_b_addr[0] | 一致
OUT_BMUX_B1 | PB11 | io_board.c out_b_addr[1] | 一致
OUT_BMUX_C2 | PB12 | io_board.c out_b_addr[2] | 一致
OUT_BMUX_EN0..EN7 | PD9, PD10, PD11, PD12, PD13, PD14, PD15, PC6 | io_board.c out_b_en[] 已按此修正 | 一致
PD8 | 图纸无 OUT_BMUX_EN 网名 | 不要接 OUT_BMUX_EN0 | 保留不用

## 4. DAC/ADC检测脚核对表

图纸网络 | MCU脚 | 用途 | 建议
ADC1_IN0 | PA0 | A半输入检测 | 当前 ADC1 channel 0 一致
ADC2_IN2 | PA2 | B半输入检测 | 当前 ADC2 channel 2 一致
DAC_OUT1 | PA4 | A半输出激励 | 当前 DAC1 一致
DAC_OUT2 | PA5 | B半输出激励 | 当前 DAC2 一致
PA1 | PA1 | 图纸无功能网名 | 建议保留为空余/测试点
PA3 | PA3 | 图纸无功能网名 | 建议保留为空余/测试点

## 5. 按键IO核对表

图纸网络 | MCU脚 | 用途 | 结论
KEY_ESC | PC4 | 取消/返回 | 当前 IO_BTN_CANCEL 一致
KEY_OK | PC5 | 确认/学习 | 当前 IO_BTN_ENTER 一致
KEY_RIGHT | PC7 | 右 | 一致
KEY_LEFT | PC8 | 左 | 一致
KEY_DOWN | PC9 | 下 | 一致
KEY_UP | PA8 | 上 | 一致；如不用RS485方向脚可保留

## 6. LCDM/LEDM显示相关核对和建议

图纸网络/脚 | MCU脚 | 用途 | 建议
LCM_SPI_SCK | PB3 | LCDM SPI时钟 | 当前代码未完整实现；建议保留给LCDM
LCM_RESET | PB4 | LCDM复位 | 当前 lcm_outputs 注释/顺序需重核
LCM_SPI_MOSI | PB5 | LCDM SPI数据输出 | 当前代码未完整实现；建议保留给LCDM
LCM_CMD | PB6 | LCDM命令/数据选择 | 当前 lcm_outputs 注释可能不匹配新版图纸，建议修代码
LCM_CS | PB7 | LCDM片选 | 当前代码把 PB7 当 LCM_CS，一致
LCM_BL_LED | PB8 | LCDM背光 | 当前代码把 PB8 当背光，一致
PA9/PA10 | PA9/PA10 | 新版图纸为 USART_TX/RX | 不要再用作TM1637 CLK/DIO，必须改

## 7. LEDM两个TX/RX/DIO脚的修改建议

方案 | 说明 | 推荐脚/接口 | 建议
方案A 推荐 | 使用图纸已有LCDM，不再加TM1637/LEDM | PB3/PB4/PB5/PB6/PB7/PB8 | 修改固件实现LCDM驱动；PA9/PA10保留USART
方案B | 若坚持两组LED数码管模块 | 新增 J_LEDM：VCC/GND/CLK/DIO_ERR/DIO_CUR | 需重新分配空余GPIO，不建议占PA9/PA10
方案B推荐脚 | LEDM_CLK/DIO1/DIO2 | 可考虑 PA1/PA3/PD8，前提是这些脚不接其他硬件 | 画图前请再确认启动/模拟/调试限制
方案C 不推荐 | PA9=CLK, PA10=DIO | 与USART_TX/RX冲突 | 不要采用

## 8. SWD烧录/调试接口必须修改建议

信号 | 推荐连接 | 说明 | 结论
SWDIO | 建议接 PA13 | 标准SWD数据脚；用于烧录/调试 | 必须改/确认
SWCLK | 建议接 PA14 | 标准SWD时钟脚；用于烧录/调试 | 必须改/确认
GND | J_SWD GND | 调试器地 | 必须保留
3.3V/Vref | J_SWD 3.3V | 调试器参考电压，不一定给板供电 | 必须保留
NRST | 建议加到SWD接口第5脚或测试点 | 便于自动复位烧录 | 强烈建议
PA13当前图纸用途 | DEBUG_TTL_TX | 会占用SWDIO | 必须从PA13移走
PA14/PA15当前图纸附近 | J4标SWCLK/SWDIO疑似接PA14/PA15区域 | PA15不是标准SWDIO | 必须核对原理图连线

## 9. USART/CAN/DEBUG/IR核对表

图纸网络 | MCU脚/接口 | 说明 | 建议
USART_TX | PA9 | J7 USART pin 3 | 当前 rpi_rs485 USART1 TX 一致；保留
USART_RX | PA10 | J7 USART pin 2 | 当前 rpi_rs485 USART1 RX 一致；保留
CAN_TX | PA12 | J6 CAN pin 2 | 当前未实现CAN；可保留
CAN_RX | PA11 | J6 CAN pin 3 | 当前未实现CAN；可保留
DEBUG_TTL_TX | 当前 PA13 | 与SWDIO冲突 | 必须改到其他空脚或删除
DEBUG_TTL_RX | 图纸标注PH.2 ???附近 | 连接不明确 | 必须确认或改成明确MCU脚
IR_RX/IR_TX | 旧代码 PA6/PA7 | 新版图纸未标IR网 | 若需要打印红外，必须新增明确接口

## 10. 给画图人员的修改清单

序号 | 修改项 | 建议修改内容 | 优先级
1 | SWD接口 | J4改为：3.3V/Vref、SWDIO=PA13、SWCLK=PA14、GND，建议加NRST | 必须改
2 | DEBUG_TTL_TX | 不要占用PA13；移到空余脚或删除 | 必须改
3 | PA9/PA10 | 只作为USART_TX/RX；删除TM1637/LEDM复用说明 | 必须改
4 | 显示接口 | 优先使用LCDM：PB3 SCK、PB5 MOSI、PB4 RESET、PB6 CMD、PB7 CS、PB8 BL | 建议改
5 | LEDM/TM1637 | 若要两组LED模块，新增独立J_LEDM，不占USART；建议CLK/DIO_ERR/DIO_CUR三线 | 待决定
6 | IR打印 | 如果保留红外打印，新增J_IR：IR_RX、IR_TX、3.3V、GND，并指定MCU脚 | 待决定
7 | 固件 | 按最终图纸更新 io_board.c、LCDM驱动、禁用或迁移tm1637_display.c和ir_remote.c | 后续执行

## 11. 备注

说明1：本文件以 SCH_FIXTURE_2026-06-30.pdf 第3页 MCU2 为准。

说明2：AT32F455 的SWD建议按 ARM Cortex-M 常规调试脚 PA13=SWDIO、PA14=SWCLK 处理；不要把 PA13 长期用作普通DEBUG_TX。

说明3：TM1637 的 DIO 不是 UART RX/TX。若使用LEDM/TM1637，请用独立GPIO命名为 CLK/DIO，不建议叫TX/RX，避免和USART混淆。

说明4：4051扫描脚当前已基本确认，不建议再改，除非PCB布线有新增约束。

## 12. 补充：LEDM两个TX/RX脚最终建议

信号名 | 推荐MCU脚 | 方向 | 连接到模块 | 结论
LEDM_TX | PA6 | MCU发送到LEDM | 接 LEDM 模块 RX | 推荐采用
LEDM_RX | PA7 | MCU接收LEDM返回 | 接 LEDM 模块 TX | 推荐采用
接口电源 | 3.3V 或按模块规格 | LEDM供电 | 优先使用3.3V模块；若模块只支持5V，TX/RX需确认电平兼容 | 注意
接口地 | GND | 公共地 | 必须与MCU共地 | 推荐采用
固件实现 | PA6/PA7 GPIO | 软件UART或普通GPIO协议 | PA6/PA7不是当前USART1；不要写成硬件USART1 | 注意
不采用 | PA9/PA10 | 当前为USART_TX/RX | 保留给主通信/RS485，不再给LEDM | 不要采用

LEDM画图建议：新增 J_LEDM_4P，针脚顺序建议 1=3.3V, 2=GND, 3=LEDM_TX(PA6, 接模块RX), 4=LEDM_RX(PA7, 接模块TX)。如果模块只需要单向显示，可保留 LEDM_RX(PA7) 作为预留/调试。

如果坚持 LEDM 使用硬件USART外设，则不建议在当前图纸上硬改，因为空闲的硬件USART成对脚很少，常见USART脚已经被ADC、4051地址/使能、主USART或按键占用，会牵动扫描电路。

## 13. 修订：根据PCB约束，LEDM改用PA9/PA10

信号/项目 | MCU脚 | 方向/现状 | 连接/影响 | 结论
LEDM_TX | PA9 | MCU发送到LEDM | 接 LEDM 模块 RX | 最终采用
LEDM_RX | PA10 | LEDM返回到MCU | 接 LEDM 模块 TX | 最终采用
冲突对象 | USART1 / J7 USART / RS485主通信 | PA9/PA10原图纸标USART_TX/RX | 若给LEDM使用，就不能再接树莓派/PC主串口通信 | 不能同时使用
若LEDM是TM1637 | PA9=CLK, PA10=DIO | 不是TX/RX串口 | 固件按GPIO时序驱动，不启用USART1 | 注意
若LEDM是串口屏/串口LED | PA9=USART1_TX, PA10=USART1_RX | 可使用硬件USART1 | 模块侧交叉接：PA9->RX，PA10<-TX | 最终采用

本节覆盖前面 PA6/PA7 的建议：由于当前PCB没有引出 PA6/PA7，LEDM最终建议改接 PA9/PA10。代价是 PA9/PA10 不再作为主USART/RS485通信口使用；如果后续还需要树莓派/PC通信，必须另选通信接口或改板。
