andrewlau2080/IO_BOARD/IO_BOARD/docs/界面说明_20260721204009.pdf

一、开机上电
STANDARD CABLE
WIRE TESTER（从右到左流动效果）

此处为色阶流动效果

K1 | K2 | K3 | K4
SELF/LEARN | AUTO | RESET | OK/SAVE

二、自动学习
1、长按K1进入学习模式
STANDARD CABLE
LEARNING(从右到左流动效果）

001 - 001（每0.5秒<时间可调>跳一个线序进行检测）

K1 | K2 | K3 | K4
SELF/LEARN | AUTO | RESET | OK/SAVE

2、学到第N条线
STANDARD CABLE
LEARNING(从右到左流动效果）

NNN - NNN

K1 | K2 | K3 | K4
SELF/LEARN | AUTO | RESET | OK/SAVE
中间包括一连多点
如001-001，001-002......

3、最后学习完
STANDARD CABLE
LEARNING OUTCOME(一直灭亮循环直到按K4确认）
TOTAL - 008 PAIRS | TOTAL - 16 POINTS
K1 | K2 | K3 | K4
SELF/LEARN | AUTO | RESET | OK/SAVE

4、按K4确认
STANDARD CABLE
CONFIRMED(灭亮循环三次）
TOTAL - 008 PAIRS | TOTAL - 16 POINTS
K1 | K2 | K3 | K4
SELF/LEARN | AUTO | RESET | OK/SAVE

四、复位

按K3进行复位

STANDARD CABLE

RESET

此处为色阶流动效果

K1 | K2 | K3 | K4
SELF/LEARN | AUTO | RESET | OK/SAVE

五、自动测试
1、按K2进入自动测试模式
STANDARD CABLE
AUTO TESTING

001 - 001（每0.1秒<时间可调>跳一个线序进行检测）

K1 | K2 | K3 | K4
SELF/LEARN | AUTO | RESET | OK/SAVE 一直测试到N条完成为止

2、测试通过时结果显示
STANDARD CABLE
RESULT | DETAILES
PASS | TOTAL - 008 PAIRS/16 POINTS
K1 | K2 | K3 | K4
SELF/LEARN | AUTO | RESET | OK/SAVE

3、测试不通过时
STANDARD CABLE
RESULT | DETAILES
NG | 001-001(每0.5秒闪一次）
K1 | K2 | K3 | K4
SELF/LEARN | AUTO | RESET | OK/SAVE

4、在PASS情况下接收到打印信号时
STANDARD CABLE
WAITING FOR PRINTING

# START PRINTING

K1 | K2 | K3 | K4
SELF/LEARN | AUTO | RESET | OK/SAVE

5、在执行打印时
STANDARD CABLE
WAITING FOR PRINTING

# COMPLETE

K1 | K2 | K3 | K4
SELF/LEARN | AUTO | RESET | OK/SAVE

三、自动检测
单按K1出现以下对照表，实际内部会自动检测每对应的IO口是否正常，无短路或连接，空即为可以

第一页，每一个25对的只用24对，二组为48对
STANDARD CABLE
IN001 | IN002 | IN003 | IN004 | IN005 | IN006 | IN007 | IN008 | IN009 | IN010 | IN011 | IN012
OUT001 | OUT002 | OUT003 | OUT004 | OUT005 | OUT006 | OUT007 | OUT008 | OUT009 | OUT010 | OUT011 | OUT012
IN013 | IN014 | IN015 | IN016 | IN017 | IN018 | IN019 | IN020 | IN021 | IN022 | IN023 | IN024
OUT013 | OUT014 | OUT015 | OUT016 | OUT017 | OUT018 | OUT019 | OUT020 | OUT021 | OUT022 | OUT023 | OUT024
IN025 | IN026 | IN027 | IN028 | IN029 | IN030 | IN031 | IN032 | IN033 | IN034 | IN035 | IN036
OUT025 | OUT026 | OUT027 | OUT028 | OUT029 | OUT030 | OUT031 | OUT032 | OUT033 | OUT034 | OUT035 | OUT036
IN037 | IN038 | IN039 | IN040 | IN041 | IN042 | IN043 | IN044 | IN045 | IN046 | IN047
OUT037 | OUT038 | OUT039 | OUT040 | OUT041 | OUT042 | OUT043 | OUT044 | OUT045 | OUT046 | OUT047

第二页，每一个25对的只用24对，二组为48对
STANDARD CABLE
IN048 | IN049 | IN050 | IN051 | IN052 | IN053 | IN054 | IN055 | IN056 | IN057 | IN058 | IN059
OUT048 | OUT049 | OUT050 | OUT051 | OUT052 | OUT053 | OUT054 | OUT055 | OUT056 | OUT057 | OUT058 | OUT059
IN060 | IN061 | IN062 | IN063 | IN064 | IN065 | IN066 | IN067 | IN068 | IN069 | IN070 | IN071
OUT060 | OUT061 | OUT062 | OUT063 | OUT064 | OUT065 | OUT066 | OUT067 | OUT068 | OUT069 | OUT070 | OUT071
IN072 | IN073 | IN074 | IN075 | IN076 | IN077 | IN078 | IN079 | IN080 | IN081 | IN082 | IN083
OUT072 | OUT073 | OUT074 | OUT075 | OUT076 | OUT077 | OUT078 | OUT079 | OUT080 | OUT081 | OUT082 | OUT083
IN084 | IN085 | IN086 | IN087 | IN088 | IN089 | IN090 | IN091 | IN092 | IN093 | IN094
OUT084 | OUT085 | OUT086 | OUT087 | OUT088 | OUT089 | OUT090 | OUT091 | OUT092 | OUT093 | OUT094
