andrewlau2080/IO_BOARD/IO_BOARD/docs/不良显示逻辑.docx

不良显示逻辑，举例以5组线

1、PASS（全部合符学习结果）

a测试结果：

I001 - O001；

I002 - O002；

I003 - O003；

I004 - O004；

I005 - O011，O012；

状态栏RESULT P01/01 I-005 O-006

b显示

左边PASS 右边最上TOATAL,中间 006 PAIRS,下面011 POINTS

2、NG（第二组开路）

a测试结果：

I001 - O001；

I002 - O002(第二组开路，此组闪）；

I003 - O003；

I004 - O004；

I005 - O011，O012；

状态栏RESULT P01/01 I-004 O-005

b显示

结果栏上面 I002（闪）

结果栏下面 O002（闪）

3、NG（跨线短路）

a测试结果：

I001 - O001；

I002 - O002，O003(第二组与第三组的O003短路，此组闪）；

I003 - (第三组开路，此组闪）；

I004 - O004；

I005 - O011，O012；

状态栏RESULT P01/01 I-004 O-006

注：I有逻辑连线的还是4个，O有逻辑连通的还是6个；

b显示

结果栏上面 I002（闪）

结果栏下面 O002（闪）

注：因为002排在前面，如果排除了002，而003还有问题，那就要在这个NG界面闪003组了；

4、NG（双组短路）

a测试结果：

I001 - O001；

I002，I003 - O002，O003(第二组与第三组全部短路，此组闪）；

I003 - （不闪，因为全移到002行了）；

I004 - O004；

I005 - O011，O012；

状态栏RESULT P01/01 I-005 O-006

注：I有逻辑连线的还是4个，O有逻辑连通的还是6个；

b显示

结果栏上面 I002，I003（闪）

结果栏下面 O002，O003（闪）

注：因为002排在前面，如果排除了002，而003还有问题，那就要在这个NG界面闪003组了，NG栏如果排不下了，满了，就隐藏，直到排除个别外后，继续往前显示；

其它类同，结果栏始终闪有问题的，如果同几组或端相连就显示在最靠的I端行，多组有问题就多组闪；NG栏终显示最前面的线序，能容多少组就显示多少组，直到满行为止，清除继续更新；
