andrewlau2080/IO_BOARD/IO_BOARD/docs/backup/README.md

# Backup Notes

This directory stores reference patches from bring-up work.

- `lcdm_driver_working_reference_2026-07-12.clean.patch`
  - Backup of the near-working TJC LCDM driver investigation.
  - Includes the broader LCDM experiment context for future reference.
  - Do not apply it wholesale to tester logic; recover only the needed LCDM driver parts.
