andrewlau2080/IO_BOARD/(list of files, cad)

Other CAD files:
tm1637/测试程序/main.obj
tm1637/TM1637.DWG
tm1637/测试程序/STC15W_EEPROM.obj
tm1637/测试程序/tm1637.obj
