andrewlau2080/IO_BOARD/.vendor/AT32F45x_Firmware_Library_V2.0.1/project/at_start_f455/examples/usart/printf/readme.txt

/**
  **************************************************************************
  * @file     readme.txt 
  * @brief    readme
  **************************************************************************
  */

  this demo is based on the at-start board, in this demo, shows how to retarget
  the c library printf function to the usart. this implementation output the printf
  message on the hyperterminal using usart1. using pa9 to transmit data(printf).

  for more detailed information. please refer to the application note document AN0099.
