andrewlau2080/IO_BOARD/IO_BOARD/docs/first_gen_wire_tester_user_manual_2026-07-04.pptx

一代线束测试机使用说明书

当前固件：FIRST_GEN_4051_LOCAL
显示模块：6位 LEDM / TM1637
日期：2026-07-04

IO BOARD / First Gen Wire Tester

## Slide 2

设备功能

• 根据已学习的标准线束资料，实时扫描当前线束连接状态。
• 判断断线、短路、多接、错接等不良。
• 当前扫描范围：48 组 OUT，48 组 IN。
• 合格显示 PASS；不良显示 NG 并轮显不良线号。

## Slide 3

按键定义

K1：短按自检；长按约 3 秒进入学习。
K2：自动测试 / 进入实时扫描。
K3：复位 / 重来。
K4：学习确认保存。
PC7：PASS 状态下按下超过 20ms 触发打印，低电平有效。

## Slide 4

开机与待机显示

• 开机后显示 WIRE TESTER 滚动字样。
• 按任意 LEDM 按键后停止滚动。
• AUTO-T：已有学习资料，可进入自动测试。
• LEArn：没有有效学习资料，需要先学习标准线束。

## Slide 5

学习流程

1. 接入确认合格的标准线束。
2. 长按 K1 约 3 秒，设备开始学习扫描。
3. 学习完成后，004004 与 tot-08 两屏交替显示。
4. 确认无误后按 K4 保存。
5. 保存成功后，tot-xx 快闪两次，然后显示 SAUEd。

## Slide 6

学习结果与 TOT 算法

004004：有效 OUT 数 / 有效 IN 数。
tot-08：总点数。
TOT = 有效 OUT 数 + 有效 IN 数。
例：OUT1-IN1、OUT1-IN2、OUT3-IN3、OUT4-IN4。
有效 OUT = 3，有效 IN = 4，所以显示 003004 / tot-07。
一拖多时，输出端头只算 1 个 OUT，分线端每个 IN 单独计数。

## Slide 7

实时扫描显示

扫描过程中不显示通道号，以保证扫描速度。
扫描动画为两个横线一组跳动：
设备会持续实时扫描，不需要等待固定延时。

## Slide 8

PASS 与 NG

PASS：完整一轮扫描全部正常。
PASS 状态下设备仍继续扫描。
NG：检测到断线、短路、多接、错接等不良。
NG 会与不良线号轮流显示，例如 NG / 001002。
修复线束后，下一整轮全部正常会恢复 PASS。

## Slide 9

打印操作

打印只允许在 PASS 状态下触发。
显示 PASS 后，按下 PC7 超过 20ms。
设备发送红外打印信号。
打印完成后显示 Printd。
当前为 NG 时，按 PC7 不会打印。

## Slide 10

按键释放保护与注意事项

• K1 长按学习后，必须等待按键释放并稳定，避免误触发自检。
• K4 保存、K3 取消、K2 自动测试后，也会等待所有按键释放稳定约 200ms。
• 第一次使用或更换线束规格后，必须先学习标准线束。
• 学习时必须接入确认合格的样品线束。
• PC7 为低电平有效，按键接地触发。

## Slide 11

常见显示速查

WIRE TESTER：开机滚动提示
AUTO-T：自动测试待机
LEArn：需要学习
PASS：测试合格
NG：测试不良
001002：OUT001 / IN002 对应不良点
SAUEd：学习保存成功
Printd：已完成打印
Erxxxx：错误代码
