andrewlau2080/IO_BOARD/.vendor/AT32F45x_Firmware_Library_V2.0.1/project/at_start_f455/examples/ertc/lick_calibration/readme.txt

/**
  **************************************************************************
  * @file     readme.txt
  * @brief    readme
  **************************************************************************
  */

  this demo is based on the at-start board, in this demo, shows how to use
  timer to calibrate the lick clock. use usart1 to view calibrate information.
  for more detailed information. please refer to the application note document AN0047.
