andrewlau2080/IO_BOARD/IO_BOARD/docs/high_end_tester_lcdm_ui_coordinates.md

# 高档测试机 LCDM 元素坐标表

本文件定义高档测试机 LCDM 页面上“画在哪里、点哪里”。元素 ID 必须与
`high_end_tester_lcdm_ui_elements.md` 保持一致。

## 屏幕坐标约定

| 项目 | 值 |
|---|---:|
| 屏幕方向 | 横屏 |
| 屏幕宽度 | `480` |
| 屏幕高度 | `272` |
| X 有效范围 | `0..479` |
| Y 有效范围 | `0..271` |
| 坐标原点 | 左上角 |
| 单位 | 像素 |

## 显示坐标总表

| 元素 ID | X | Y | W | H | 前景色 | 背景色 | 对齐 | 说明 |
|---|---:|---:|---:|---:|---|---|---:|---|
| `screen_bg` | 0 | 0 | 480 | 272 | - | `WHITE` | - | 全屏背景，先画它覆盖旧内容 |
| `title_bar` | 0 | 0 | 480 | 32 | - | `NAVY` | - | 顶部标题栏 |
| `title_text` | 8 | 3 | 220 | 26 | `WHITE` | `NAVY` | 0 | 左侧标题 `STANDARD CABLE` |
| `role_text` | 312 | 3 | 160 | 26 | `WHITE` | `NAVY` | 2 | 右侧标题 `WIRE TESTER` |
| `status_panel` | 16 | 42 | 448 | 66 | - | `ROW_BG` | - | 主状态背景 |
| `state_text` | 24 | 48 | 160 | 52 | 状态色 | `ROW_BG` | 0 | `READY/SELF/AUTO/LEARNING/RESULT` |
| `main_text` | 184 | 48 | 272 | 52 | 状态色 | `ROW_BG` | 0 | 主提示，固定左对齐 |
| `ledm_panel` | 16 | 122 | 214 | 34 | - | `WHITE` | - | LEDM 兼容显示背景 |
| `result_text` | 24 | 126 | 432 | 26 | `BLUE` | `WHITE` | 0 | 当前 pair / 单组结果，固定从左到右显示 |
| `pass_result` | 16 | 122 | 149 | 34 | `WHITE` | `GREEN/DARK_GREEN` 闪烁 | 1 | PASS 专用结果区，占结果行 1/3 |
| `print_state` | 165 | 122 | 299 | 34 | `NAVY/WHITE` | `PALE_CYAN/ORANGE/PALE_BLUE` | 1 | 打印状态区，占结果行 2/3，显示 `WAITING FOR PRINTING/START PRINTING/COMPLETE` |
| `detail_panel` | 250 | 122 | 214 | 34 | - | `WHITE` | - | 点位/结果详情背景 |
| `sub_panel` | 16 | 174 | 448 | 28 | - | `WHITE` | - | 辅助提示背景 |
| `sub_text` | 24 | 177 | 432 | 22 | `GRAY` | `WHITE` | 1 | 操作提示 / 页码 / 总数 |
| `touch_debug_text` | 24 | 177 | 432 | 22 | `BLUE` | `WHITE` | 1 | 调试时覆盖 `sub_text` |
| `key_band` | 0 | 214 | 480 | 58 | - | 分色 | - | 四键显示与触摸区域 |

对齐值沿用 TJC `xstr` 的 `sta` 参数语义：`0` 左对齐，`1` 居中，`2` 右对齐。

## K1-K4 显示坐标

| 元素 ID | 按键 | X | Y | W | H | 上排文字坐标 | 下排文字坐标 | 普通背景 | 按下背景 |
|---|---|---:|---:|---:|---:|---|---|---|---|
| `key_k1` | K1 | 0 | 214 | 120 | 58 | `block 46,227,27,14` | `compact 1,252,118,13` | `BLUE` | `NAVY` |
| `key_k2` | K2 | 120 | 214 | 120 | 58 | `block 166,227,27,14` | `compact 121,252,118,13` | `RED` | `DARK_RED` |
| `key_k3` | K3 | 240 | 214 | 120 | 58 | `block 286,227,27,14` | `compact 241,252,118,13` | `MAGENTA` | `PURPLE` |
| `key_k4` | K4 | 360 | 214 | 120 | 58 | `block 406,227,27,14` | `compact 361,252,118,13` | `ORANGE` | `DARK_ORANGE` |

K1-K4 主字使用 `fill` 绘制方块字，说明文字同步缩放。按钮说明文字使用紧凑块字。其它区域保持普通 `xstr` 显示。按下/松开只刷新按钮局部，不重绘整页。

PASS 后结果行切换为双区显示：左侧 1/3 为 `PASS`，绿底白字，约 0.5 秒闪烁一次底色；右侧 2/3 为打印状态并带底色、居中放大。初始为 `WAITING FOR PRINTING`，触发后切 `START PRINTING`，完成后切 `COMPLETE`。

## K1-K4 触摸命中坐标

触摸命中区必须与显示按键区完全一致。不能把 `112..271` 全部当作按键区。

| 按键 | X 范围 | Y 范围 | 命中后内部键值 |
|---|---|---|---|
| K1 | `0..119` | `214..271` | `FIRST_GEN_KEY_SET` |
| K2 | `120..239` | `214..271` | `FIRST_GEN_KEY_CLEAR` |
| K3 | `240..359` | `214..271` | `FIRST_GEN_KEY_PLUS` |
| K4 | `360..479` | `214..271` | `FIRST_GEN_KEY_MINUS` |

## 非按键区域

| 区域 | X 范围 | Y 范围 | 处理 |
|---|---|---|---|
| 标题、状态和内容区 | `0..479` | `0..213` | 不触发动作，只可记录调试坐标 |
| 屏外异常坐标 | 其它 | 其它 | 丢弃或显示调试信息 |

## 坐标方向兼容

主规则只认横屏原始坐标。旧的坐标交换兜底已移除，避免非按键区误触发 K1-K4。

| 顺序 | 输入 | 判断 | 处理 |
|---:|---|---|---|
| 1 | `(x,y)` | 可直接命中 K1-K4 | 使用原坐标 |
| 2 | 其它 | 无法命中 | 显示调试信息，不执行业务动作 |

## 颜色表

| 名称 | RGB565 值 | 用途 |
|---|---:|---|
| `BLACK` | `0` | 备用文字 |
| `BLUE` | `31` | 主状态、按下背景、调试文字 |
| `RED` | `63488` | NG/错误 |
| `GREEN` | `2016` | PASS |
| `DARK_GREEN` | `992` | PASS 闪烁暗底色 |
| `DARK_RED` | `32768` | K2 按下背景 |
| `MAGENTA` | `63519` | K3 普通背景 |
| `PURPLE` | `30735` | K3 按下背景 |
| `ORANGE` | `64512` | K4 普通背景 |
| `DARK_ORANGE` | `49664` | K4 按下背景 |
| `WHITE` | `65535` | 页面背景、白字 |
| `GRAY` | `33808` | 辅助文字 |
| `DARK_GRAY` | `16904` | 普通按键背景 |
| `NAVY` | `16` | 标题栏背景 |
| `ROW_BG` | `61374` | 主状态背景 |
| `PALE_CYAN` | `49151` | `PRINT READY` 背景 |
| `PALE_BLUE` | `50719` | `PRINTED` 背景 |
