andrewlau2080/IO_BOARD/IO_BOARD/docs/high_end_tester_lcdm_display_elements.docx

高档测试机 LCDM 显示元素表

本 Word 文件把 LCDM 显示图直接放在前面，后面再列出固定元素、会变化元素、K1-K4 按键元素和状态显示内容。此文件只判断显示内容，不包含第二份坐标表和第三份通讯逻辑表。

1. LCDM 主界面显示图

屏幕规格：480 x 272 横屏。下图为待机 READY 状态的完整界面。

WIRE TESTER LCDM | | | TESTER
READY | AUTO TEST
K1 SELF/LEARN | K2 AUTO | K3 RESET | K4 OK/SAVE
AUTO | | PROFILE DB50

K1 SELF/LEARN K2 AUTO K3 RESET K4 OK

2. 会变化状态显示图

READY - 待机

WIRE TESTER LCDM | | | TESTER
READY | AUTO TEST
K1 SELF/LEARN | K2 AUTO | K3 RESET | K4 OK/SAVE
AUTO | | PROFILE DB50

K1 SELF/LEARN K2 AUTO K3 RESET K4 OK

SELF - 自检

WIRE TESTER LCDM | | | TESTER
SELF | SELF TEST
K1 SELF/LEARN | K2 AUTO | K3 RESET | K4 OK/SAVE
A01b01 | | OUT001 IN001

CHECKING... K3 RESET

AUTO - 自动测试

WIRE TESTER LCDM | | | TESTER
AUTO | AUTO TEST
K1 SELF/LEARN | K2 AUTO | K3 RESET | K4 OK/SAVE
A32b32 | | OK 032/092

RUNNING K3 RESET

LEARN - 学习

WIRE TESTER LCDM | | | TESTER
LEARN | LEARN MODE
K1 SELF/LEARN | K2 AUTO | K3 RESET | K4 OK/SAVE
LEArn | | OUT048 IN048

HOLD K1 3S K4 SAVE

PASS - 通过

WIRE TESTER LCDM | | | TESTER
PASS | PASS
K1 SELF/LEARN | K2 AUTO | K3 RESET | K4 OK/SAVE
PASS | | TOTAL 092 OK

PRINT READY REMOVE HARNESS

NG - 不良

WIRE TESTER LCDM | | | TESTER
NG | NG
K1 SELF/LEARN | K2 AUTO | K3 RESET | K4 OK/SAVE
001002 | | OUT001 IN002

SHORT CIRCUIT K3 RESET

3. 固定显示元素

元素 ID | 元素名称 | 类型 | 固定显示内容
screen_bg | 全屏背景 | 色块 | 白色背景，覆盖原内容
title_bar | 标题栏背景 | 色块 | 深蓝色横条
title_text | 标题文字 | 文本 | WIRE TESTER LCDM
role_text | 角色文字 | 文本 | TESTER
status_panel | 主状态背景 | 色块 | 浅色状态区
key_band | 按键带背景 | 色块 | K1-K4 四段按键背景
ledm_panel | LEDM 兼容显示背景 | 色块 | 白色区域
detail_panel | 详情背景 | 色块 | 白色区域
sub_panel | 辅助提示背景 | 色块 | 白色区域

4. 会变化的显示元素

元素 ID | 元素名称 | 可能显示内容 | 变化来源
state_text | 状态文字 | READY / SELF / AUTO / LEARN / PASS / NG | 固件状态机
main_text | 主显示文字 | AUTO TEST / SELF TEST / LEARN MODE / PASS / NG | 固件状态机
ledm_text | LEDM 兼容显示 | AUTO / A01b01 / PASS / 001002 / LEArn | LEDM 显示模型
detail_text | 详情文字 | PROFILE DB50 / OUT001 IN002 / OK 092/092 | 测试流程
sub_text | 辅助提示文字 | K1 SELF/LEARN K2 AUTO K3 RESET K4 OK | 当前状态提示
touch_debug_text | 触摸调试文字 | T 060,140 -> K1 DOWN | 触摸解析结果，调试阶段可覆盖 sub_text

5. K1-K4 按键显示元素

元素 ID | 按键 | 显示文字 | 动作含义
key_k1 | K1 | K1 / SELF/LEARN | 短按自检；长按约 3 秒学习
key_k2 | K2 | K2 / AUTO | 自动测试
key_k3 | K3 | K3 / RESET | 复位到待机
key_k4 | K4 | K4 / OK/SAVE | 确认/保存；调试阶段可切 PASS

6. 状态内容总表

状态 | state_text | main_text | ledm_text
READY | READY | AUTO TEST | AUTO
SELF | SELF | SELF TEST | A01b01
AUTO | AUTO | AUTO TEST | A32b32
LEARN | LEARN | LEARN MODE | LEArn
PASS | PASS | PASS | PASS
NG | NG | NG | 001002

状态 | detail_text | sub_text | 颜色
READY | PROFILE DB50 | K1 SELF/LEARN K2 AUTO K3 RESET K4 OK | BLUE
SELF | OUT001 IN001 | CHECKING... K3 RESET | BLUE
AUTO | OK 032/092 | RUNNING K3 RESET | BLUE
LEARN | OUT048 IN048 | HOLD K1 3S K4 SAVE | BLUE
PASS | TOTAL 092 OK | PRINT READY REMOVE HARNESS | GREEN
NG | OUT001 IN002 | SHORT CIRCUIT K3 RESET | RED

7. 显示边界

项目 | 规则 | 备注
显示来源 | 所有可见内容都必须来自本文件元素表。 | 不依赖旧 HMI 控件。
动态变化 | 动态元素只由状态机、测试流程、LEDM 模型和触摸调试更新。 | 不能乱跳页。
原控件 | 高档测试机界面不显示屏内旧项目控件。 | 露出旧控件就是错误状态。
