andrewlau2080/IO_BOARD/IO_BOARD/docs/high_end_tester_lcdm_verified_2026-07-14.md

# 高档测试机 LCDM 当前确认版本记录

日期：2026-07-14

## 结论

当前固件版本已确认：

| 项目 | 状态 |
|---|---|
| LCDM 显示 | 正常 |
| LCDM 触摸 | 正常 |
| K1-K4 坐标映射 | 正常 |
| 按键动作链路 | 正常 |
| 原控件弹出问题 | 当前版本不再作为功能路径 |
| BEEP 判断 | 不作为触摸依据 |

## 固件规则

LCDM 按规格书通讯执行，不再使用 BEEP 声音作为输入判断。

| 项目 | 当前值 |
|---|---|
| 串口 | `USART1` |
| MCU TX | `PA9` |
| MCU RX | `PA10` |
| 波特率 | `230400` |
| 数据格式 | `8N1` |
| 命令结束符 | `FF FF FF` |
| 主要触摸回包 | `0x67 xH xL yH yL event FF FF FF` |

## 触摸坐标

当前正式按键区：

| 按键 | X 范围 | Y 范围 | 固件键值 |
|---|---|---|---|
| K1 | `0..119` | `214..271` | `FIRST_GEN_KEY_SET` |
| K2 | `120..239` | `214..271` | `FIRST_GEN_KEY_CLEAR` |
| K3 | `240..359` | `214..271` | `FIRST_GEN_KEY_PLUS` |
| K4 | `360..479` | `214..271` | `FIRST_GEN_KEY_MINUS` |

## 本次保留的实现重点

- LCDM 接收只按 `FF FF FF` 作为合法包结束。
- `lcdm_tjc.c` 使用 USART1 中断收包，并用 8 包 FIFO 防止连续触摸包被覆盖。
- 解析并记录 `0x67` 坐标触摸、`0x65` 组件触摸、`0x71` 数值返回。
- 正式 LCDM 后端启动时强制同步到 `230400`，再绘制界面并开启 `sendxy=1`。
- `first_gen_display.c` 负责把 LCDM 坐标包映射成 K1-K4，再交给 first-gen 测试状态机执行。
- 已加入 `g_first_gen_lcdm_*` 和 `g_lcdm_tjc_*` 调试变量，后续可直接读内存确认输入链路。

## 对应源码

| 功能 | 文件 |
|---|---|
| LCDM/TJC 串口与回包解析 | `IO_BOARD/src/lcdm_tjc.c`, `IO_BOARD/inc/lcdm_tjc.h` |
| 高档测试机 LCDM 显示和触摸映射 | `IO_BOARD/src/first_gen_display.c`, `IO_BOARD/inc/first_gen_display.h` |
| First-gen 测试业务状态机 | `IO_BOARD/src/first_gen_4051_scan.c` |
| 独立 LCDM 测试界面 | `IO_BOARD/src/lcdm_motor_ui.c` |

## 已验证构建

```sh
cd IO_BOARD
cmake --build build-lcdm-tester
```

已下载到板子并由现场确认：显示、触摸及对应动作均正常。

## 2026-07-15 补充记录

本次继续修复 LCDM 触摸入口：

- 保留 `0x67` 坐标触摸包作为正式功能入口。
- `0x65` 组件触摸包和 ASCII 触摸文本不再执行业务动作，只作为旧 HMI 干扰恢复路径处理。
- 已移除坐标交换兜底，避免非按键区被误判为 K1-K4。
- 已关闭屏端原控件触摸并在旧控件事件出现时恢复 MCU 绘制界面。

当前仍需继续处理：

- K1-K4 连续点按时仍存在闪屏问题，原因尚未完全确认。
- 下一步重点核查 LCDM 刷新节流、按键按下/释放状态保持、以及业务状态机重复显示更新。

## 2026-07-22 补充记录

本次按 `docs/界面说明260722.xlsx` 继续整理 LCDM 高档测试机界面：

- 自动学习流程改为 94 点扫描，1-48 使用 A 半区输入，49-94 使用 B 半区输入。
- 学习过程显示 `LEARNING` 和 `NNN - NNN`，步进时间为 0.1 秒。
- 学习完成页显示 `LEARNING OUTCOME`，结果区左右分栏，标题闪烁时不重画结果分隔线。
- K4 确认后停留在 `CONFIRMED` 页，下一次按 K1-K4 再执行对应功能。
- 单按 K1 的自检结果表按两页显示到 `IN/OUT094`，检测后逐格变色。
- K2 自动测试入口显示 `AUTO TESTING` 和当前线序，自动测试步进改为 50 ms。
- PASS 后不再无条件跳到打印界面；只有 PB8 磁感触发后才进入打印流程。
- PASS 结果页使用左侧大字 `PASS`，右侧三行显示 `TOTAL`、`NNN PAIRS`、`NNN POINTS`。
- 顶部标题保留稳定显示 `STANDARD CABLE`，不使用带空格的大字体写法，避免 LCDM 字符显示异常。

本次已编译并下载 `build-lcdm-tester` 到板子。现场后续重点继续核对：

- PASS 字体和标题栏视觉大小是否还需要微调。
- NG 与打印后续页面是否完全按 `界面说明260722.xlsx` 继续整理。
