andrewlau2080/IO_BOARD/TestV1.0/analysis_outputs/ir_protocol_analysis.md

# 电线测试机-标签打印机红外通讯波形分析
## 解析基准
- Saleae 文件采样率按 16 MHz 换算。
- 包络定义：`MARK` 为红外载波打开，`SPACE` 为红外载波关闭。MCU 发射时按 MARK/SPACE 表驱动 38-42 kHz 载波即可。
- 由于原始 `.logicdata` 为 Saleae 旧版私有格式，本文时序由保存的 Edge Finder 边沿索引还原，包络边界误差约小于 0.12 ms，满足毫秒级发包参考。

## 通道判定
有连接打印机文件中 Edge Finder 数据块顺序为：`打印接收RX`、`打印发射TX`、`测试发射TX`、`测试接收RX`。
无连接打印机文件中未出现 `测试发射TX` 数据块，仅有打印机周期发射/接收侧记录。

## 载波估计
- 打印机发射载波：半周期约 11.938 us，频率约 41.88 kHz。
- 测试机发射载波：半周期约 12.900 us，频率约 38.76 kHz。

## 工作步骤与关键时序
1. 打印机持续周期轮询：周期约 203.147 ms，每帧约 36.693 ms。
2. 测试机未遇到打印机/未满足打印条件时，测试机 TX 不发射；RX 仅等待红外输入。
3. 有连接时，测试机接收到打印机轮询帧；打印机 TX 到测试机 RX 延迟约 0.215 ms。
4. 在触发帧内，测试机约在轮询帧开始后 24.786 ms 开始发射响应。
5. 测试机响应 TX 持续约 2151.005 ms。
6. 打印机接收测试机响应后执行打印，并暂停自身轮询约 2.000 s。
7. 打印机恢复轮询/确认后，测试机应清除本次测试通过锁存，等待下一次测试。

补充判定：普通轮询帧、触发测试机响应的轮询帧、打印后恢复的第一帧三者包络一致，均为下文 `printer_poll_tx` 这组 71 段码。也就是说，目前波形里没有看到独立的不同 ACK 包；测试机可把“打印机在测试机响应后重新出现有效轮询帧”作为清除本次 `print_pending` 的确认条件。

## 打印机轮询发射包 `printer_poll_tx`
- 重复周期：约 203.147 ms。
- 单包长度：约 36.693 ms。
- 建议码元单位：约 0.417 ms。
- 完整包络如下，`units` 为 duration / 0.417 ms 四舍五入。

|#|类型|时长 ms|units|
|---:|---|---:|---:|
|1|MARK|0.860|2|
|2|SPACE|0.415|1|
|3|MARK|0.812|2|
|4|SPACE|0.417|1|
|5|MARK|0.418|1|
|6|SPACE|0.417|1|
|7|MARK|0.418|1|
|8|SPACE|0.417|1|
|9|MARK|0.418|1|
|10|SPACE|0.826|2|
|11|MARK|0.812|2|
|12|SPACE|0.417|1|
|13|MARK|0.418|1|
|14|SPACE|0.417|1|
|15|MARK|0.418|1|
|16|SPACE|0.417|1|
|17|MARK|1.182|3|
|18|SPACE|0.417|1|
|19|MARK|0.418|1|
|20|SPACE|0.417|1|
|21|MARK|0.418|1|
|22|SPACE|0.417|1|
|23|MARK|0.418|1|
|24|SPACE|0.417|1|
|25|MARK|0.812|2|
|26|SPACE|0.417|1|
|27|MARK|0.812|2|
|28|SPACE|0.417|1|
|29|MARK|0.418|1|
|30|SPACE|0.417|1|
|31|MARK|0.418|1|
|32|SPACE|0.417|1|
|33|MARK|0.418|1|
|34|SPACE|0.826|2|
|35|MARK|0.812|2|
|36|SPACE|0.417|1|
|37|MARK|0.418|1|
|38|SPACE|0.417|1|
|39|MARK|0.418|1|
|40|SPACE|0.417|1|
|41|MARK|1.182|3|
|42|SPACE|0.417|1|
|43|MARK|0.418|1|
|44|SPACE|0.417|1|
|45|MARK|0.418|1|
|46|SPACE|0.417|1|
|47|MARK|0.418|1|
|48|SPACE|0.417|1|
|49|MARK|0.812|2|
|50|SPACE|0.417|1|
|51|MARK|0.812|2|
|52|SPACE|0.417|1|
|53|MARK|0.418|1|
|54|SPACE|0.417|1|
|55|MARK|0.418|1|
|56|SPACE|0.417|1|
|57|MARK|0.418|1|
|58|SPACE|0.826|2|
|59|MARK|0.812|2|
|60|SPACE|0.417|1|
|61|MARK|0.418|1|
|62|SPACE|0.417|1|
|63|MARK|0.418|1|
|64|SPACE|0.417|1|
|65|MARK|1.182|3|
|66|SPACE|0.417|1|
|67|MARK|0.418|1|
|68|SPACE|0.417|1|
|69|MARK|0.418|1|
|70|SPACE|0.417|1|
|71|MARK|0.359|1|

## 测试机响应发射包 `tester_response_tx`
- 触发时刻：打印机触发轮询包开始后约 24.786 ms。
- 单包长度：约 2151.005 ms。
- 建议码元单位：约 0.413 ms。
- 包络段数：3321 段，完整表见 `tester_response_tx_envelope.csv`。
- 前 80 段用于人工核对：

|#|类型|相对起点 ms|时长 ms|units|
|---:|---|---:|---:|---:|
|1|MARK|0.000|1.998|5|
|2|SPACE|1.998|0.413|1|
|3|MARK|2.411|0.410|1|
|4|SPACE|2.821|0.385|1|
|5|MARK|3.206|0.387|1|
|6|SPACE|3.593|0.827|2|
|7|MARK|4.419|0.903|2|
|8|SPACE|5.323|0.414|1|
|9|MARK|5.737|0.775|2|
|10|SPACE|6.512|0.386|1|
|11|MARK|6.898|0.387|1|
|12|SPACE|7.285|0.414|1|
|13|MARK|7.699|0.516|1|
|14|SPACE|8.215|0.930|2|
|15|MARK|9.146|1.292|3|
|16|SPACE|10.438|0.412|1|
|17|MARK|10.849|0.388|1|
|18|SPACE|11.238|0.414|1|
|19|MARK|11.652|0.387|1|
|20|SPACE|12.039|0.412|1|
|21|MARK|12.451|0.538|1|
|22|SPACE|12.990|1.328|3|
|23|MARK|14.318|1.935|5|
|24|SPACE|16.252|0.413|1|
|25|MARK|16.666|0.389|1|
|26|SPACE|17.055|0.412|1|
|27|MARK|17.466|0.388|1|
|28|SPACE|17.854|0.827|2|
|29|MARK|18.681|0.903|2|
|30|SPACE|19.584|0.414|1|
|31|MARK|19.998|0.774|2|
|32|SPACE|20.773|0.412|1|
|33|MARK|21.185|0.388|1|
|34|SPACE|21.573|0.414|1|
|35|MARK|21.986|0.387|1|
|36|SPACE|22.373|0.929|2|
|37|MARK|23.302|1.422|3|
|38|SPACE|24.724|0.412|1|
|39|MARK|25.136|0.388|1|
|40|SPACE|25.525|0.414|1|
|41|MARK|25.938|0.388|1|
|42|SPACE|26.326|0.412|1|
|43|MARK|26.738|0.388|1|
|44|SPACE|27.127|1.343|3|
|45|MARK|28.470|2.063|5|
|46|SPACE|30.533|0.415|1|
|47|MARK|30.948|0.387|1|
|48|SPACE|31.335|0.412|1|
|49|MARK|31.747|0.388|1|
|50|SPACE|32.135|0.827|2|
|51|MARK|32.961|0.775|2|
|52|SPACE|33.736|0.412|1|
|53|MARK|34.148|0.905|2|
|54|SPACE|35.053|0.412|1|
|55|MARK|35.465|0.388|1|
|56|SPACE|35.853|0.414|1|
|57|MARK|36.267|0.388|1|
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
- 多工位场景建议给每台测试机加入防重发窗口：响应完成后等待打印机恢复轮询或超时，再决定清除/重发。

## 文件清单
- `printer_poll_tx_envelope.csv`：打印机发射轮询包完整 71 段，可用于模拟打印机或测试接收逻辑。
- `tester_response_tx_envelope.csv`：测试机响应发射包完整 3321 段，可直接转换为 MCU MARK/SPACE 查表。
- `printer_rx_seen_tester_response_envelope.csv`：打印机接收端看到的测试机响应前段，主要用于核对测试机响应是否能被打印机识别。
