andrewlau2080/IO_BOARD/TestV1.0/analysis_outputs/tester_response_tx_envelope.csv

index | type | start_ms | duration_ms | units
1 | MARK | 0.000000 | 1.997938 | 5
2 | SPACE | 1.997938 | 0.412750 | 1
3 | MARK | 2.410687 | 0.410250 | 1
4 | SPACE | 2.820937 | 0.384688 | 1
5 | MARK | 3.205625 | 0.387313 | 1
6 | SPACE | 3.592938 | 0.826500 | 2
7 | MARK | 4.419437 | 0.903250 | 2
8 | SPACE | 5.322687 | 0.414000 | 1
9 | MARK | 5.736687 | 0.774938 | 2
10 | SPACE | 6.511625 | 0.386375 | 1
11 | MARK | 6.898000 | 0.387125 | 1
12 | SPACE | 7.285125 | 0.414375 | 1
13 | MARK | 7.699500 | 0.515938 | 1
14 | SPACE | 8.215438 | 0.930250 | 2
15 | MARK | 9.145687 | 1.291937 | 3
16 | SPACE | 10.437625 | 0.411687 | 1
17 | MARK | 10.849312 | 0.388437 | 1
18 | SPACE | 11.237750 | 0.414062 | 1
19 | MARK | 11.651813 | 0.387062 | 1
20 | SPACE | 12.038875 | 0.412438 | 1
21 | MARK | 12.451313 | 0.538438 | 1
22 | SPACE | 12.989750 | 1.327875 | 3
23 | MARK | 14.317625 | 1.934625 | 5
24 | SPACE | 16.252250 | 0.413375 | 1
25 | MARK | 16.665625 | 0.388875 | 1
26 | SPACE | 17.054500 | 0.411750 | 1
27 | MARK | 17.466250 | 0.387875 | 1
28 | SPACE | 17.854125 | 0.826687 | 2
29 | MARK | 18.680813 | 0.903500 | 2
30 | SPACE | 19.584312 | 0.413938 | 1
31 | MARK | 19.998250 | 0.774500 | 2
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
