andrewlau2080/IO_BOARD/IO_BOARD/debug/ir_waveform_live.html

已接收到红外信号，信号处理中并已保存。
页面每秒自动刷新；当前只显示最新/选定的一组。Updated by GDB at 2026-05-22 14:07:05. Source: capture history latest.

## Decoded NEC-like Frame

part | value | check
Sync mark | 8961us | Expected about 9000us
Sync space | 4511us | Expected about 4500us
Address | 0x79 | First data byte
Address inverse/check | 0x0A | MISMATCH
Command | 0x20 | Second data byte
Command inverse/check | 0x50 | MISMATCH
Extended address view | 0x0A79 | Use this if address inverse is not expected

## Bit Timing

bit | group | bit_in_byte | value | mark_us | space_us | start_us
0 | ADDR | 0 | 1 | 592 | 1702 | 13472
1 | ADDR | 1 | 0 | 592 | 607 | 15766
2 | ADDR | 2 | 0 | 591 | 607 | 16965
3 | ADDR | 3 | 1 | 590 | 1704 | 18163
4 | ADDR | 4 | 1 | 590 | 1700 | 20457
5 | ADDR | 5 | 1 | 596 | 1697 | 22747
6 | ADDR | 6 | 1 | 590 | 1704 | 25040
7 | ADDR | 7 | 0 | 590 | 607 | 27334
8 | ~ADDR | 0 | 0 | 591 | 609 | 28531
9 | ~ADDR | 1 | 1 | 590 | 1703 | 29731
10 | ~ADDR | 2 | 0 | 592 | 607 | 32024
11 | ~ADDR | 3 | 1 | 591 | 1703 | 33223
12 | ~ADDR | 4 | 0 | 592 | 605 | 35517
13 | ~ADDR | 5 | 0 | 590 | 608 | 36714
14 | ~ADDR | 6 | 0 | 591 | 608 | 37912
15 | ~ADDR | 7 | 0 | 590 | 608 | 39111
16 | CMD | 0 | 0 | 591 | 607 | 40309
17 | CMD | 1 | 0 | 591 | 607 | 41507
18 | CMD | 2 | 0 | 591 | 608 | 42705
19 | CMD | 3 | 0 | 591 | 608 | 43904
20 | CMD | 4 | 0 | 590 | 608 | 45103
21 | CMD | 5 | 1 | 591 | 1703 | 46301
22 | CMD | 6 | 0 | 591 | 607 | 48595
23 | CMD | 7 | 0 | 592 | 608 | 49793
24 | ~CMD | 0 | 0 | 591 | 608 | 50993
25 | ~CMD | 1 | 0 | 590 | 607 | 52192
26 | ~CMD | 2 | 0 | 590 | 608 | 53389
27 | ~CMD | 3 | 0 | 590 | 606 | 54587
28 | ~CMD | 4 | 1 | 590 | 1704 | 55783
29 | ~CMD | 5 | 0 | 598 | 600 | 58077
30 | ~CMD | 6 | 1 | 590 | 1705 | 59275
31 | ~CMD | 7 | 0 | 589 | 606 | 61570

## 只显示一组已选数据

信号已接收，正在统计/解码并已保存当前选定组。Chosen stable NEC group from 2 matching frames: ADDR=0x79, ~ADDR=0x0A, CMD=0x20, ~CMD=0x50. Send the same key at least 1 more time(s) before writing it into firmware. 历史样本只在后台用于准确性判断，本页面只显示一组数据；选定数组写入 debug/ir_code_normalized.c。

## Raw Segments

idx | level | voltage | start_us | duration_us | decoded_label
0 | 0 | 0V | 0 | 8961 | SYNC mark
1 | 1 | 3.3V | 8961 | 4511 | SYNC space
2 | 0 | 0V | 13472 | 592 | ADDR b0=1 mark
3 | 1 | 3.3V | 14064 | 1702 | ADDR b0=1
4 | 0 | 0V | 15766 | 592 | ADDR b1=0 mark
5 | 1 | 3.3V | 16358 | 607 | ADDR b1=0
6 | 0 | 0V | 16965 | 591 | ADDR b2=0 mark
7 | 1 | 3.3V | 17556 | 607 | ADDR b2=0
8 | 0 | 0V | 18163 | 590 | ADDR b3=1 mark
9 | 1 | 3.3V | 18753 | 1704 | ADDR b3=1
10 | 0 | 0V | 20457 | 590 | ADDR b4=1 mark
11 | 1 | 3.3V | 21047 | 1700 | ADDR b4=1
12 | 0 | 0V | 22747 | 596 | ADDR b5=1 mark
13 | 1 | 3.3V | 23343 | 1697 | ADDR b5=1
14 | 0 | 0V | 25040 | 590 | ADDR b6=1 mark
15 | 1 | 3.3V | 25630 | 1704 | ADDR b6=1
16 | 0 | 0V | 27334 | 590 | ADDR b7=0 mark
17 | 1 | 3.3V | 27924 | 607 | ADDR b7=0
18 | 0 | 0V | 28531 | 591 | ~ADDR b0=0 mark
19 | 1 | 3.3V | 29122 | 609 | ~ADDR b0=0
20 | 0 | 0V | 29731 | 590 | ~ADDR b1=1 mark
21 | 1 | 3.3V | 30321 | 1703 | ~ADDR b1=1
22 | 0 | 0V | 32024 | 592 | ~ADDR b2=0 mark
23 | 1 | 3.3V | 32616 | 607 | ~ADDR b2=0
24 | 0 | 0V | 33223 | 591 | ~ADDR b3=1 mark
25 | 1 | 3.3V | 33814 | 1703 | ~ADDR b3=1
26 | 0 | 0V | 35517 | 592 | ~ADDR b4=0 mark
27 | 1 | 3.3V | 36109 | 605 | ~ADDR b4=0
28 | 0 | 0V | 36714 | 590 | ~ADDR b5=0 mark
29 | 1 | 3.3V | 37304 | 608 | ~ADDR b5=0
30 | 0 | 0V | 37912 | 591 | ~ADDR b6=0 mark
31 | 1 | 3.3V | 38503 | 608 | ~ADDR b6=0
32 | 0 | 0V | 39111 | 590 | ~ADDR b7=0 mark
33 | 1 | 3.3V | 39701 | 608 | ~ADDR b7=0
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
  560, 1690, 560, 1690, 560, 560, 560, 560, 560, 1690, 560, 560,
  560, 1690, 560, 560, 560, 560, 560, 560, 560, 560, 560, 560,
  560, 560, 560, 560, 560, 560, 560, 560, 560, 1690, 560, 560,
  560, 560, 560, 560, 560, 560, 560, 560, 560, 560, 560, 1690,
  560, 560, 560, 1690, 560, 560, 560
};
