andrewlau2080/IO_BOARD/IO_BOARD/1thsch.pdf

### GND

### GND

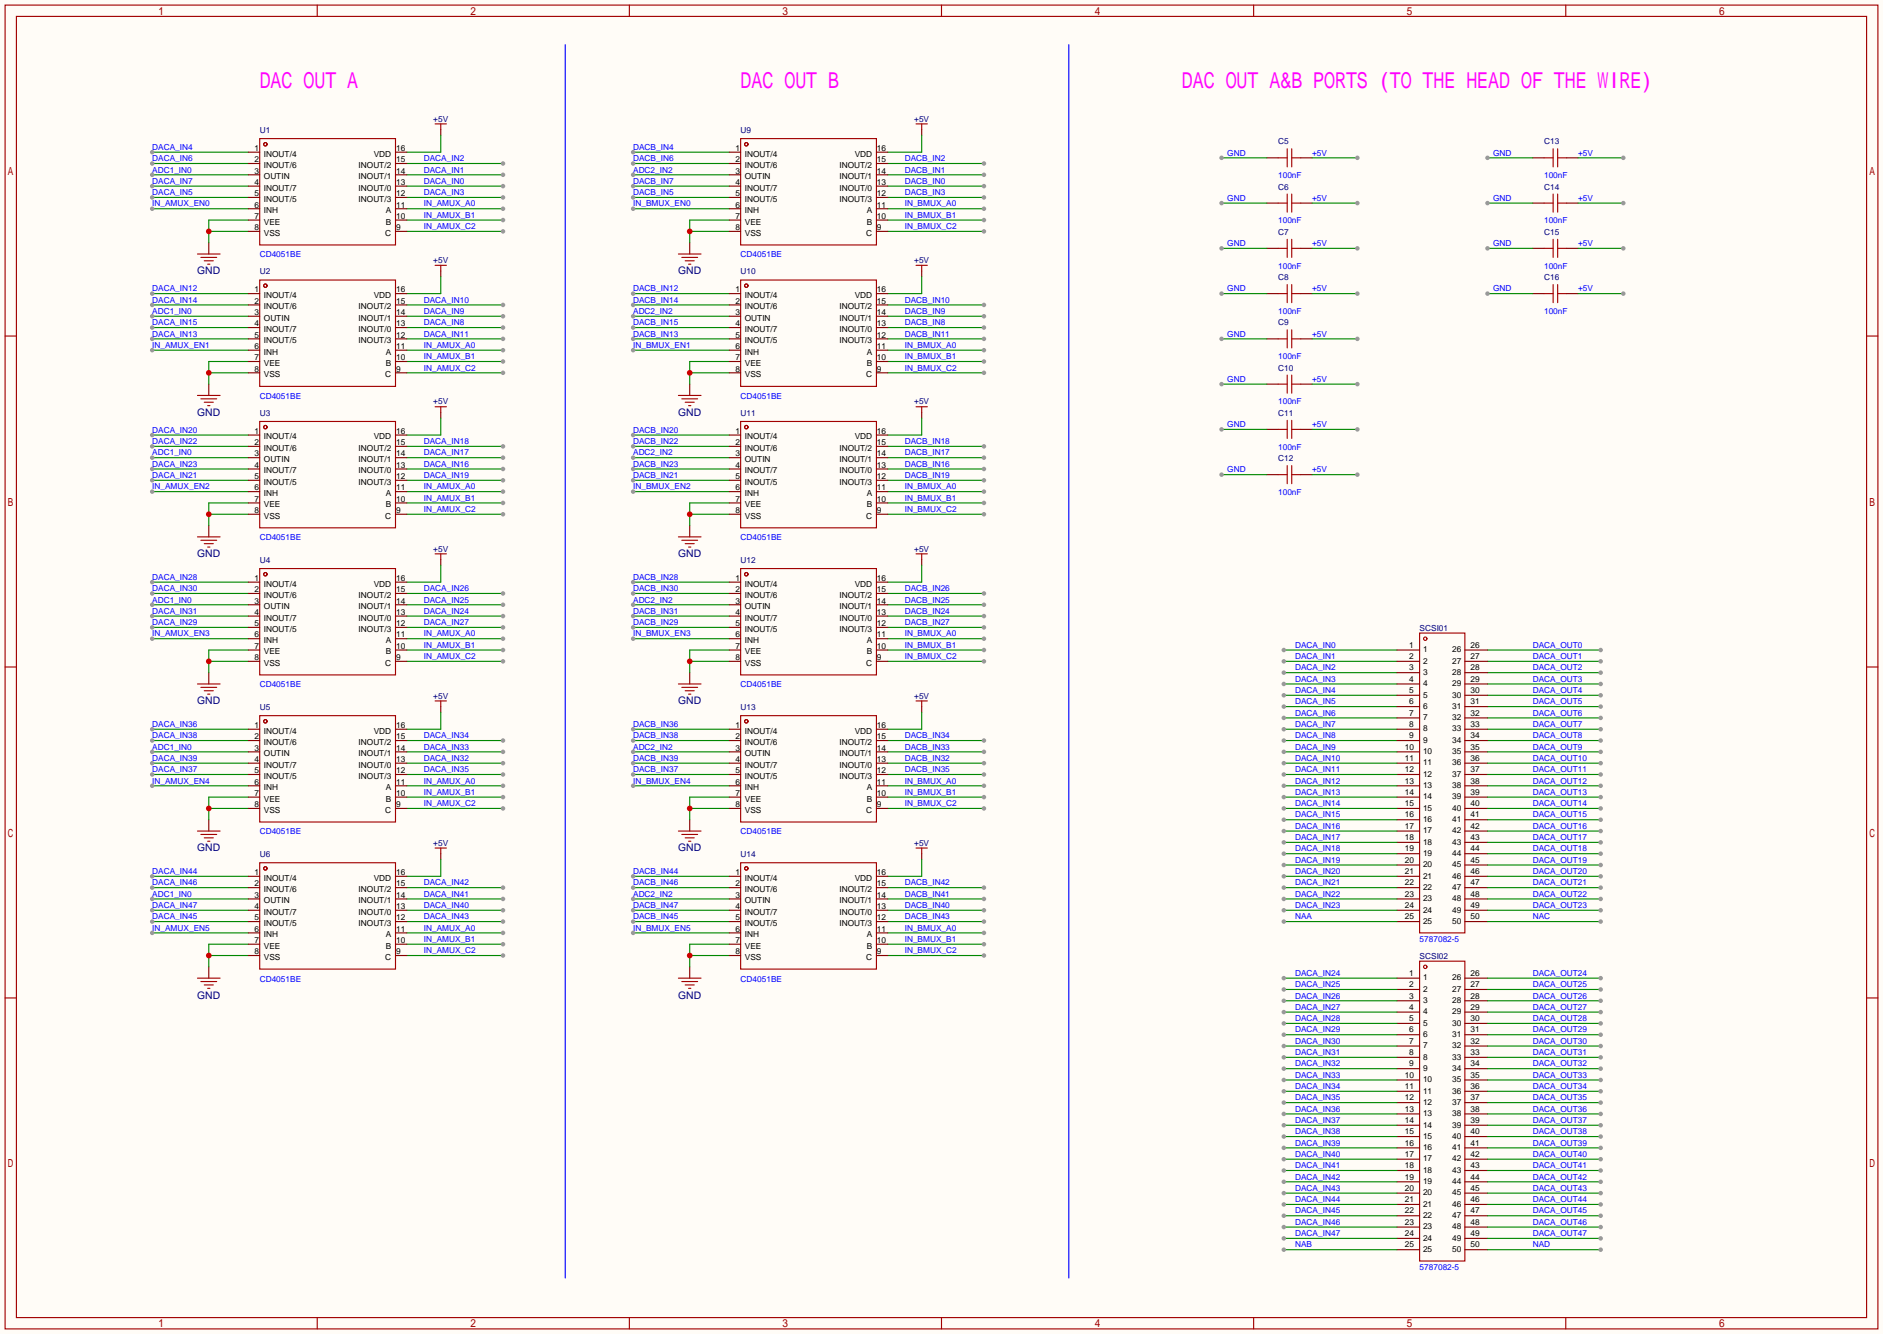
[picture p14: page 1]

DAC OUT A&B PORTS (TO THE HEAD OF THE WIRE)

11 INOUT/3 12 INOUT/0 13 INOUT/1 14 INOUT/2 15 VDD 16

### GND

### GND

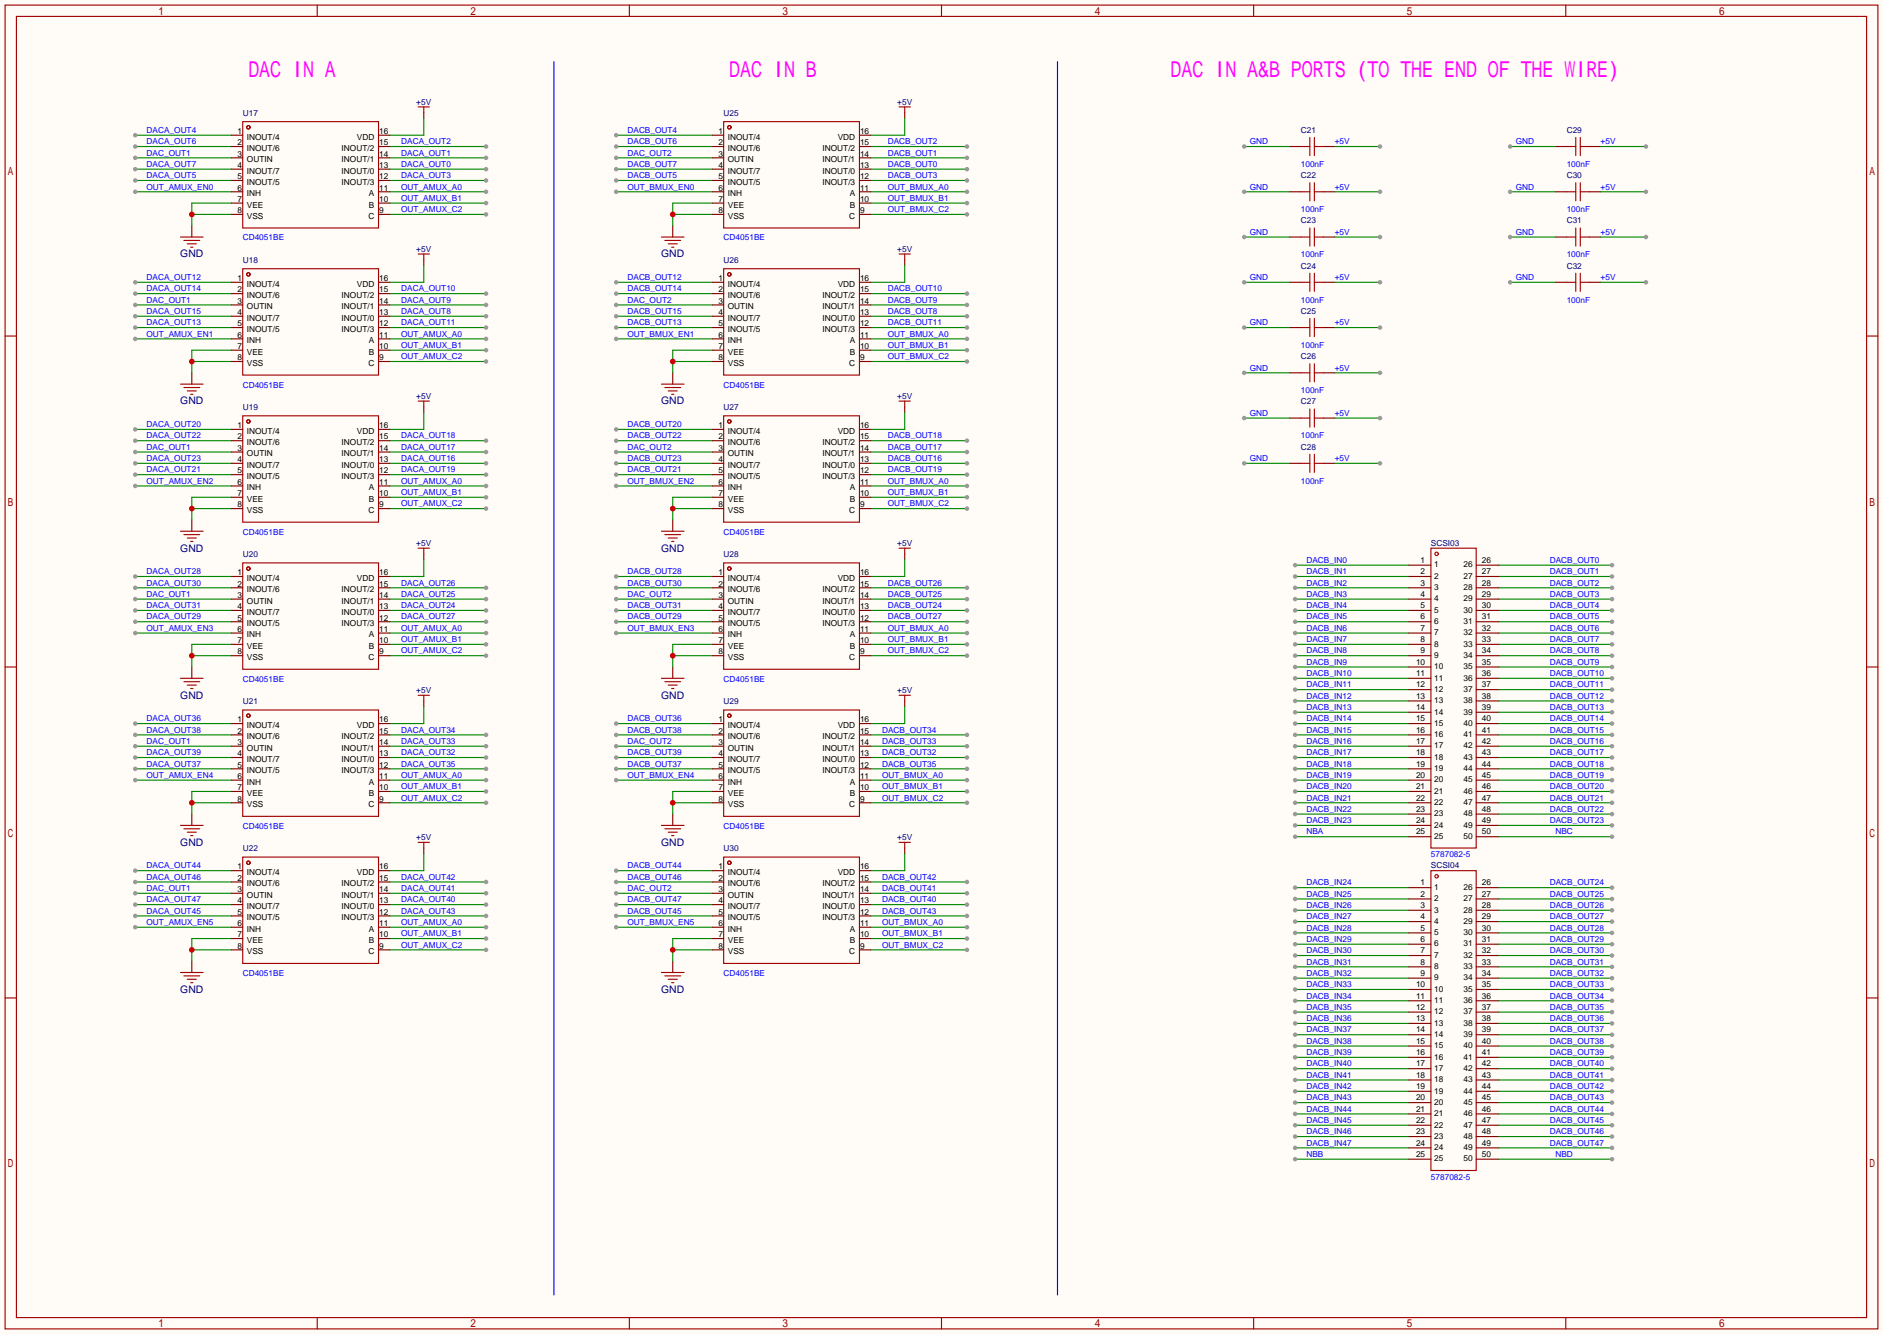
[picture p15: page 2]

DAC IN A&B PORTS (TO THE END OF THE WIRE)

11 INOUT/3 12 INOUT/0 13 INOUT/1 14 INOUT/2 15 VDD 16

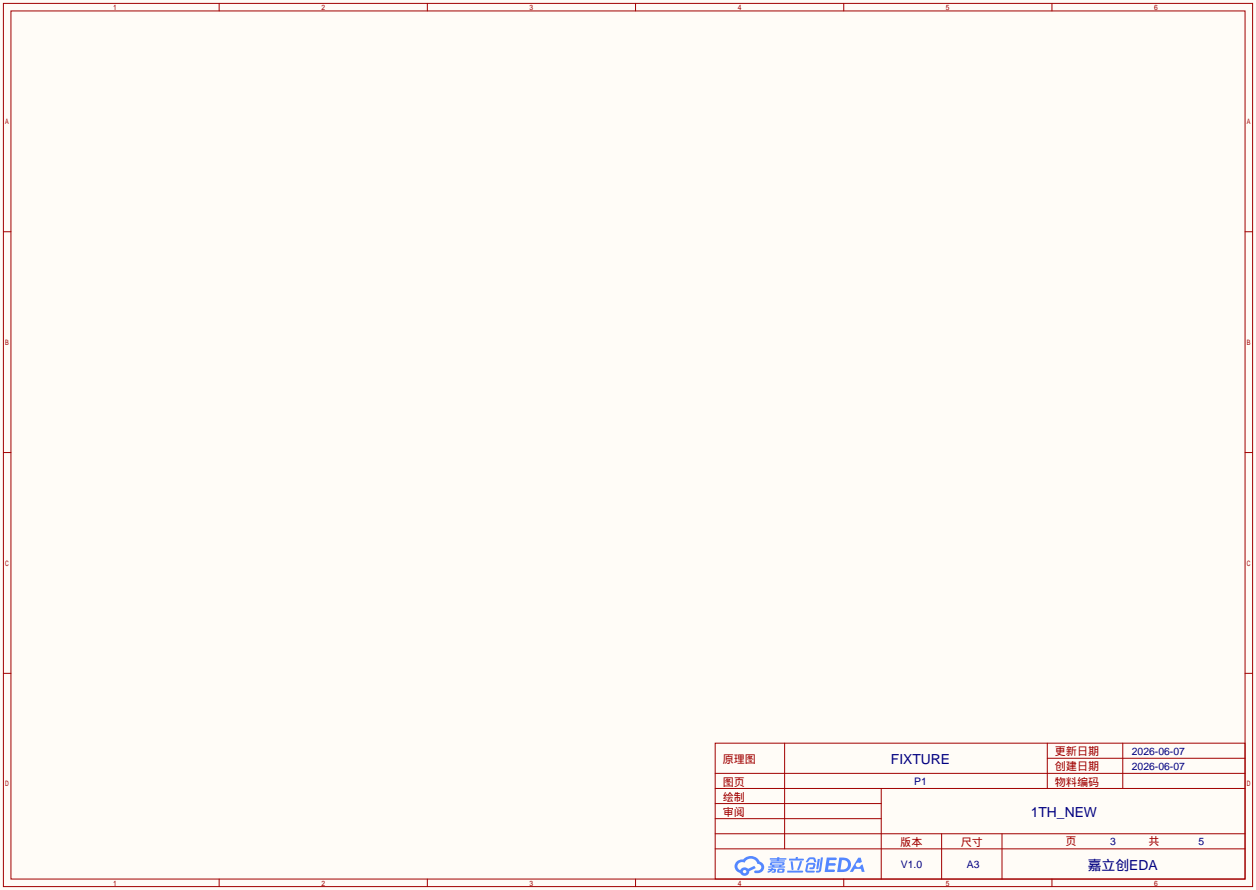
[picture p16: page 3]

### GND

### GND

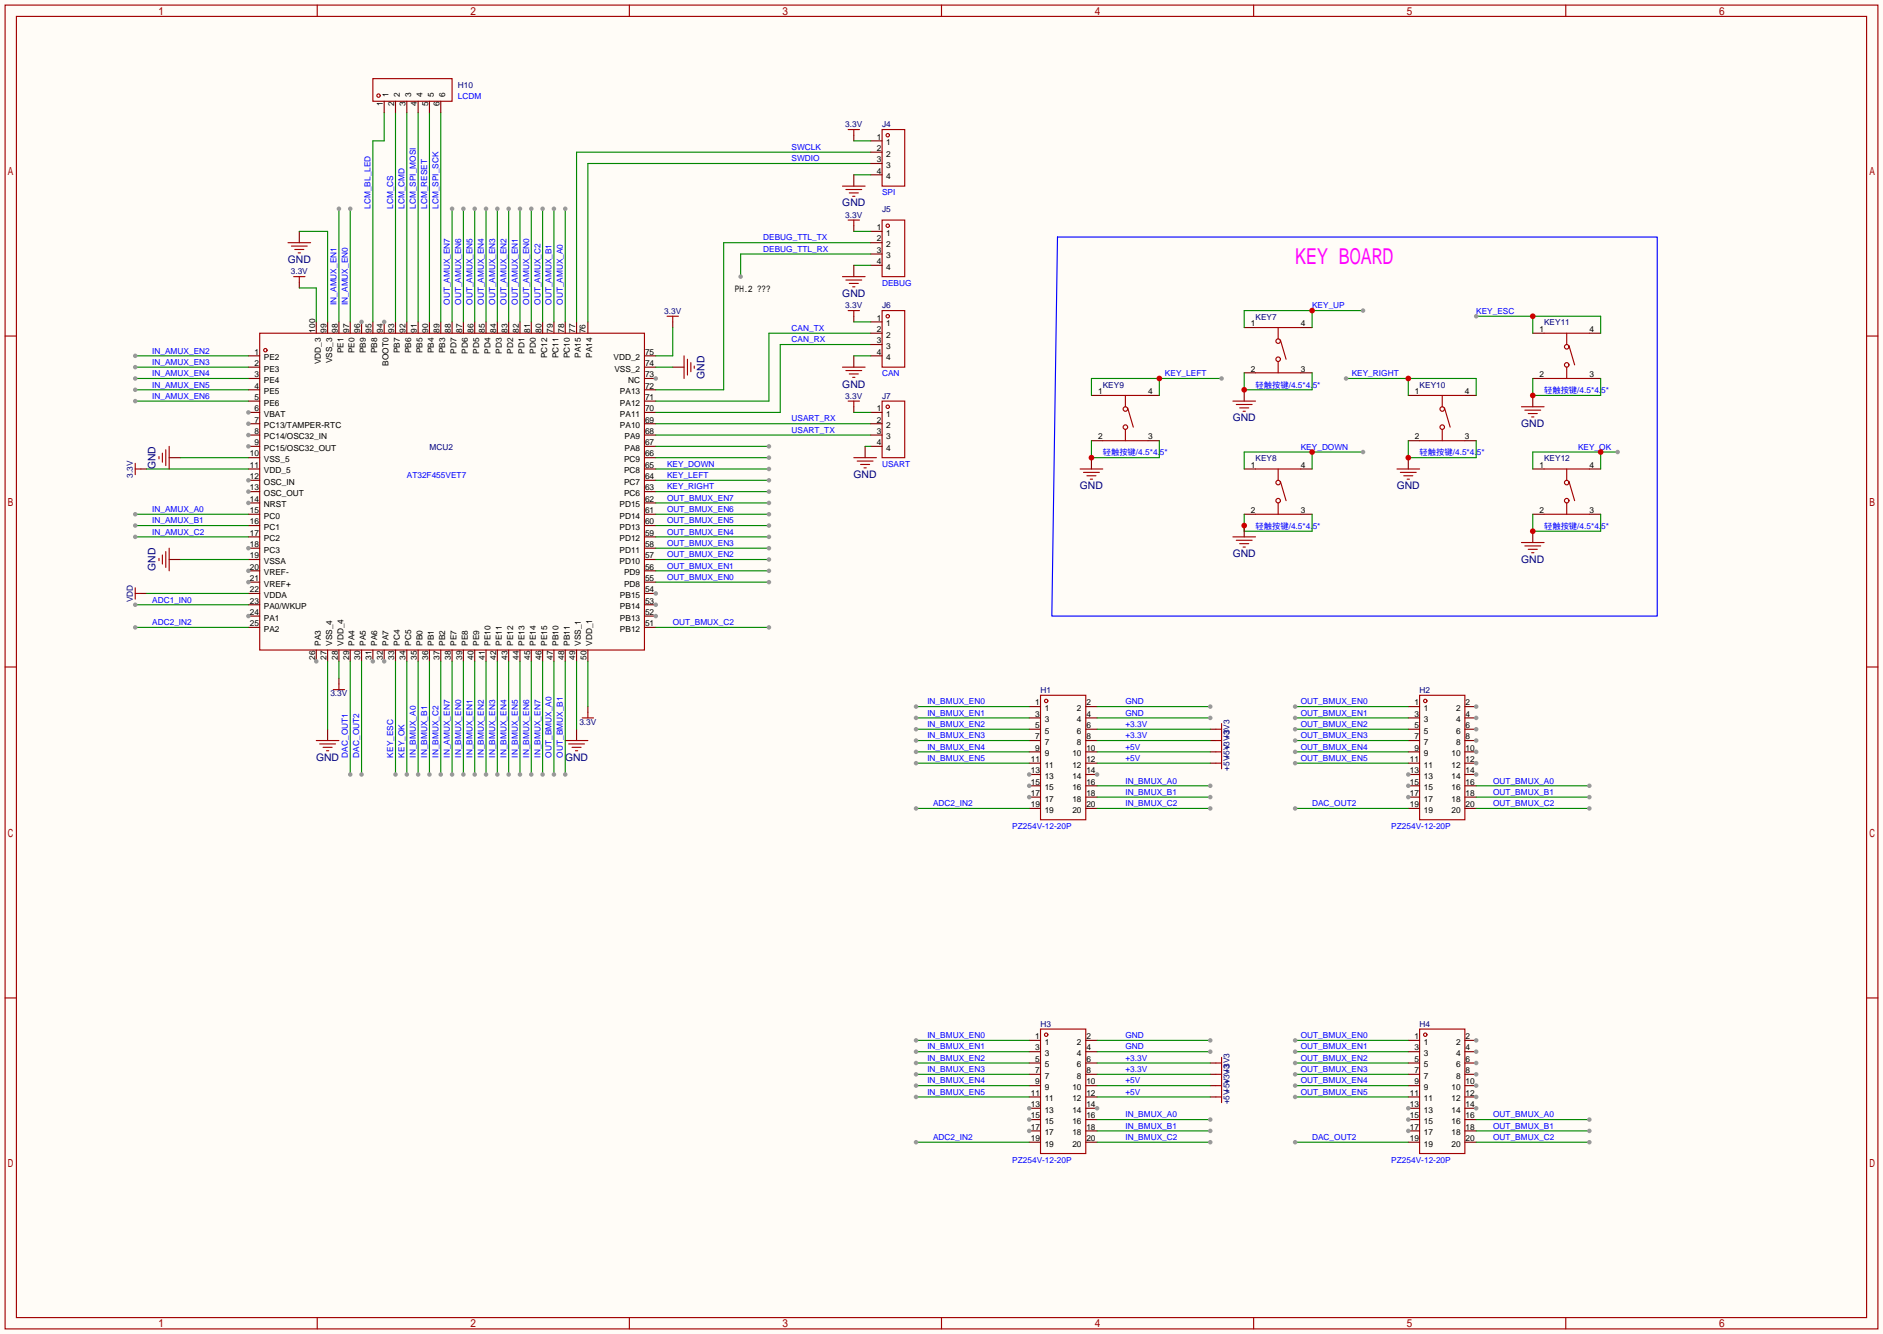
[picture p17: page 4]

### GND

### LED3 10K

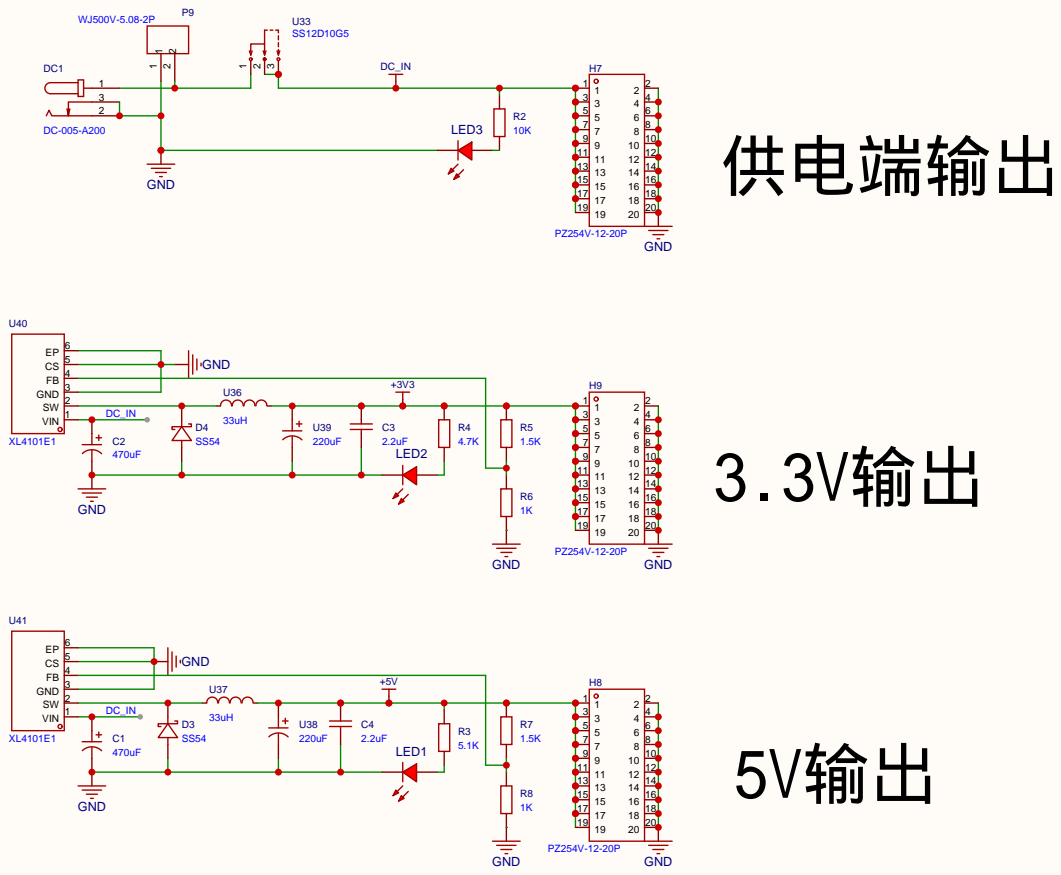
[picture p18: page 5]
