andrewlau2080/IO_BOARD/IO_BOARD/docs/SCH_FIXTURE_2026-07-07.pdf

### GND

### GND

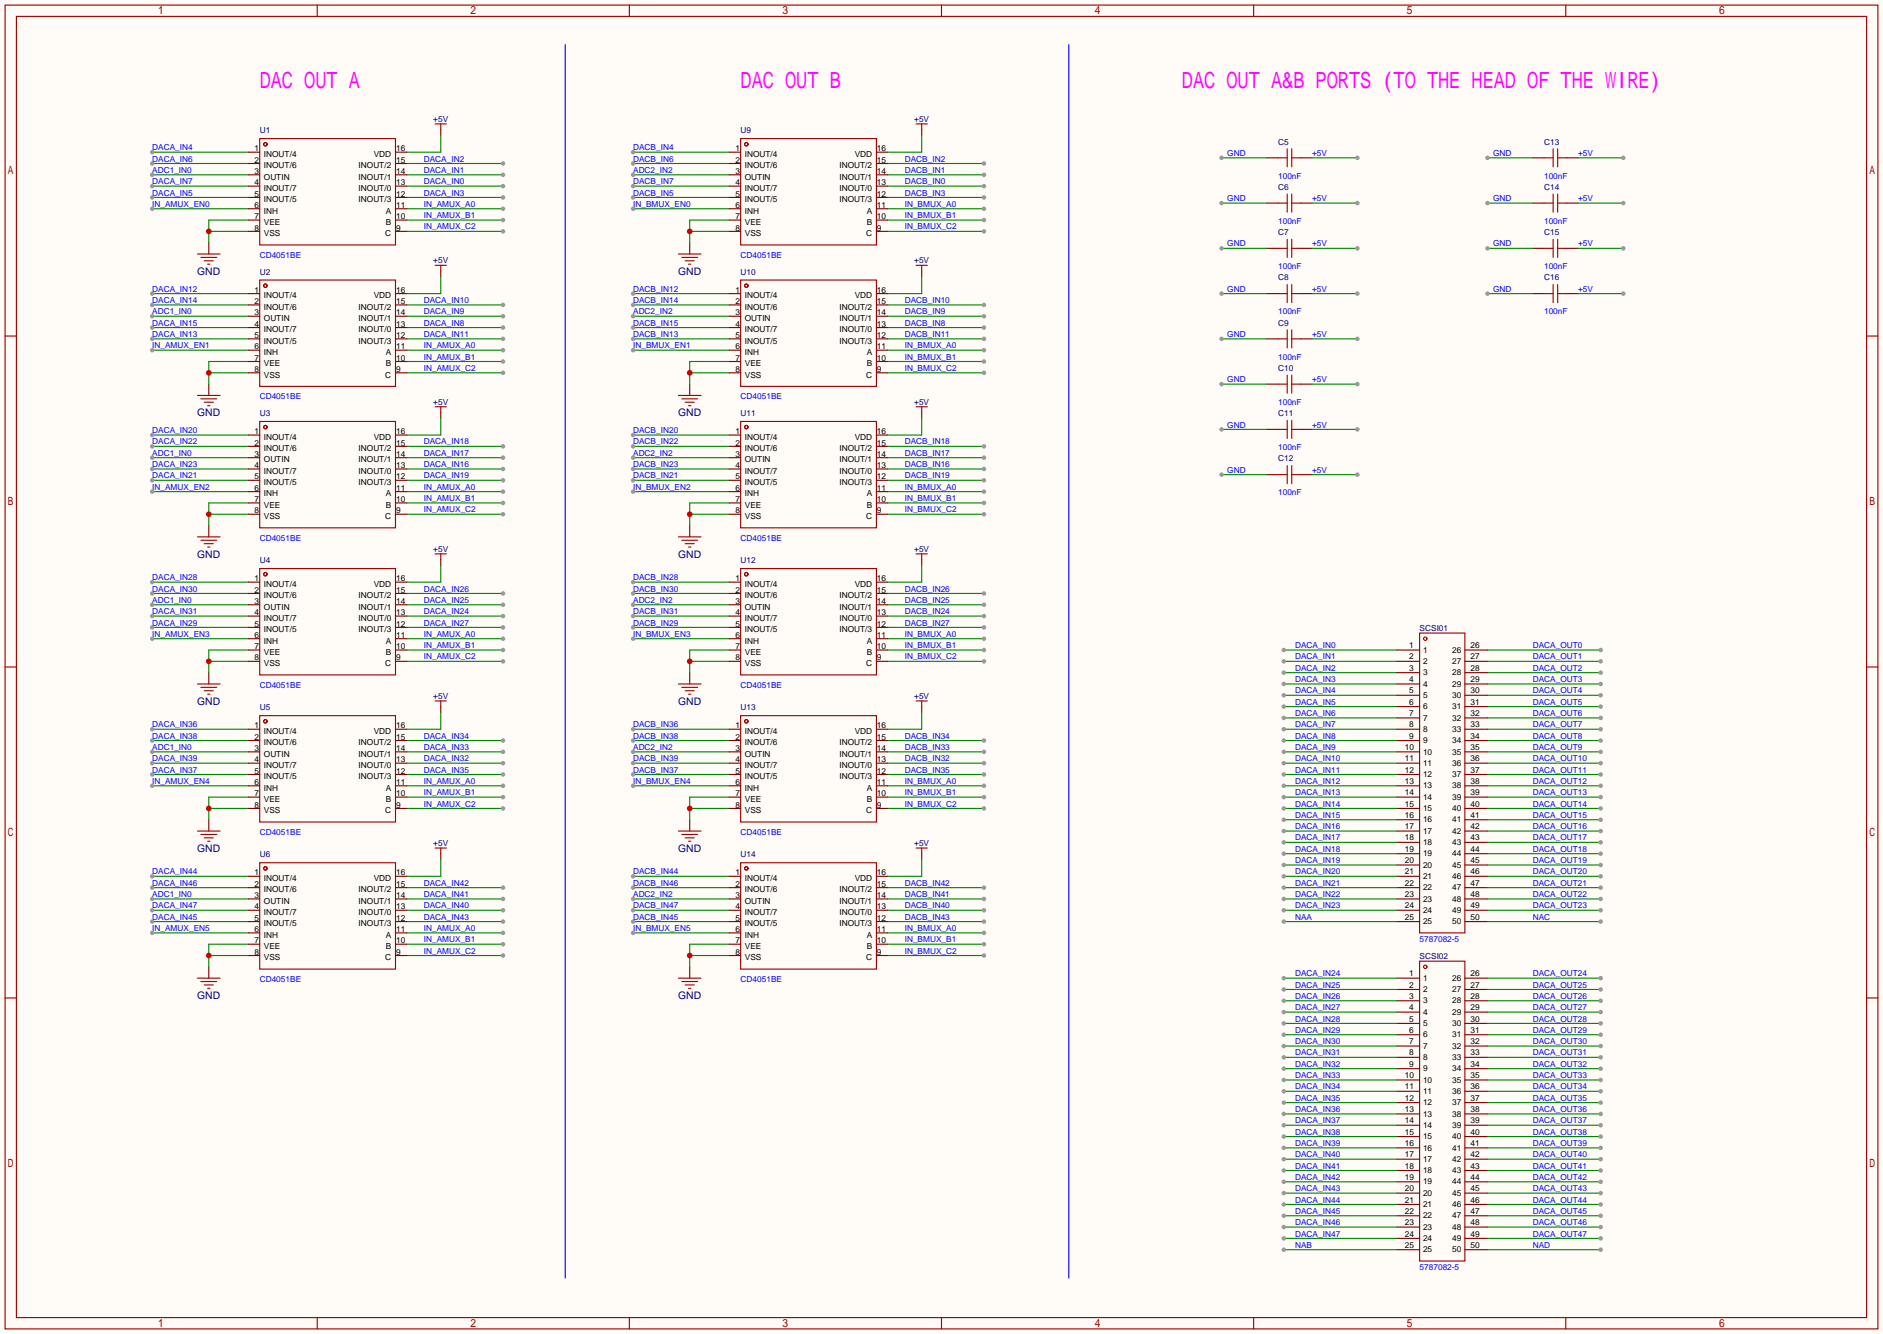
[picture p23: page 1]

DAC OUT A&B PORTS (TO THE HEAD OF THE WIRE)

11 INOUT/3 12 INOUT/0 13 INOUT/1 14 INOUT/2 15 VDD 16

### GND

### GND

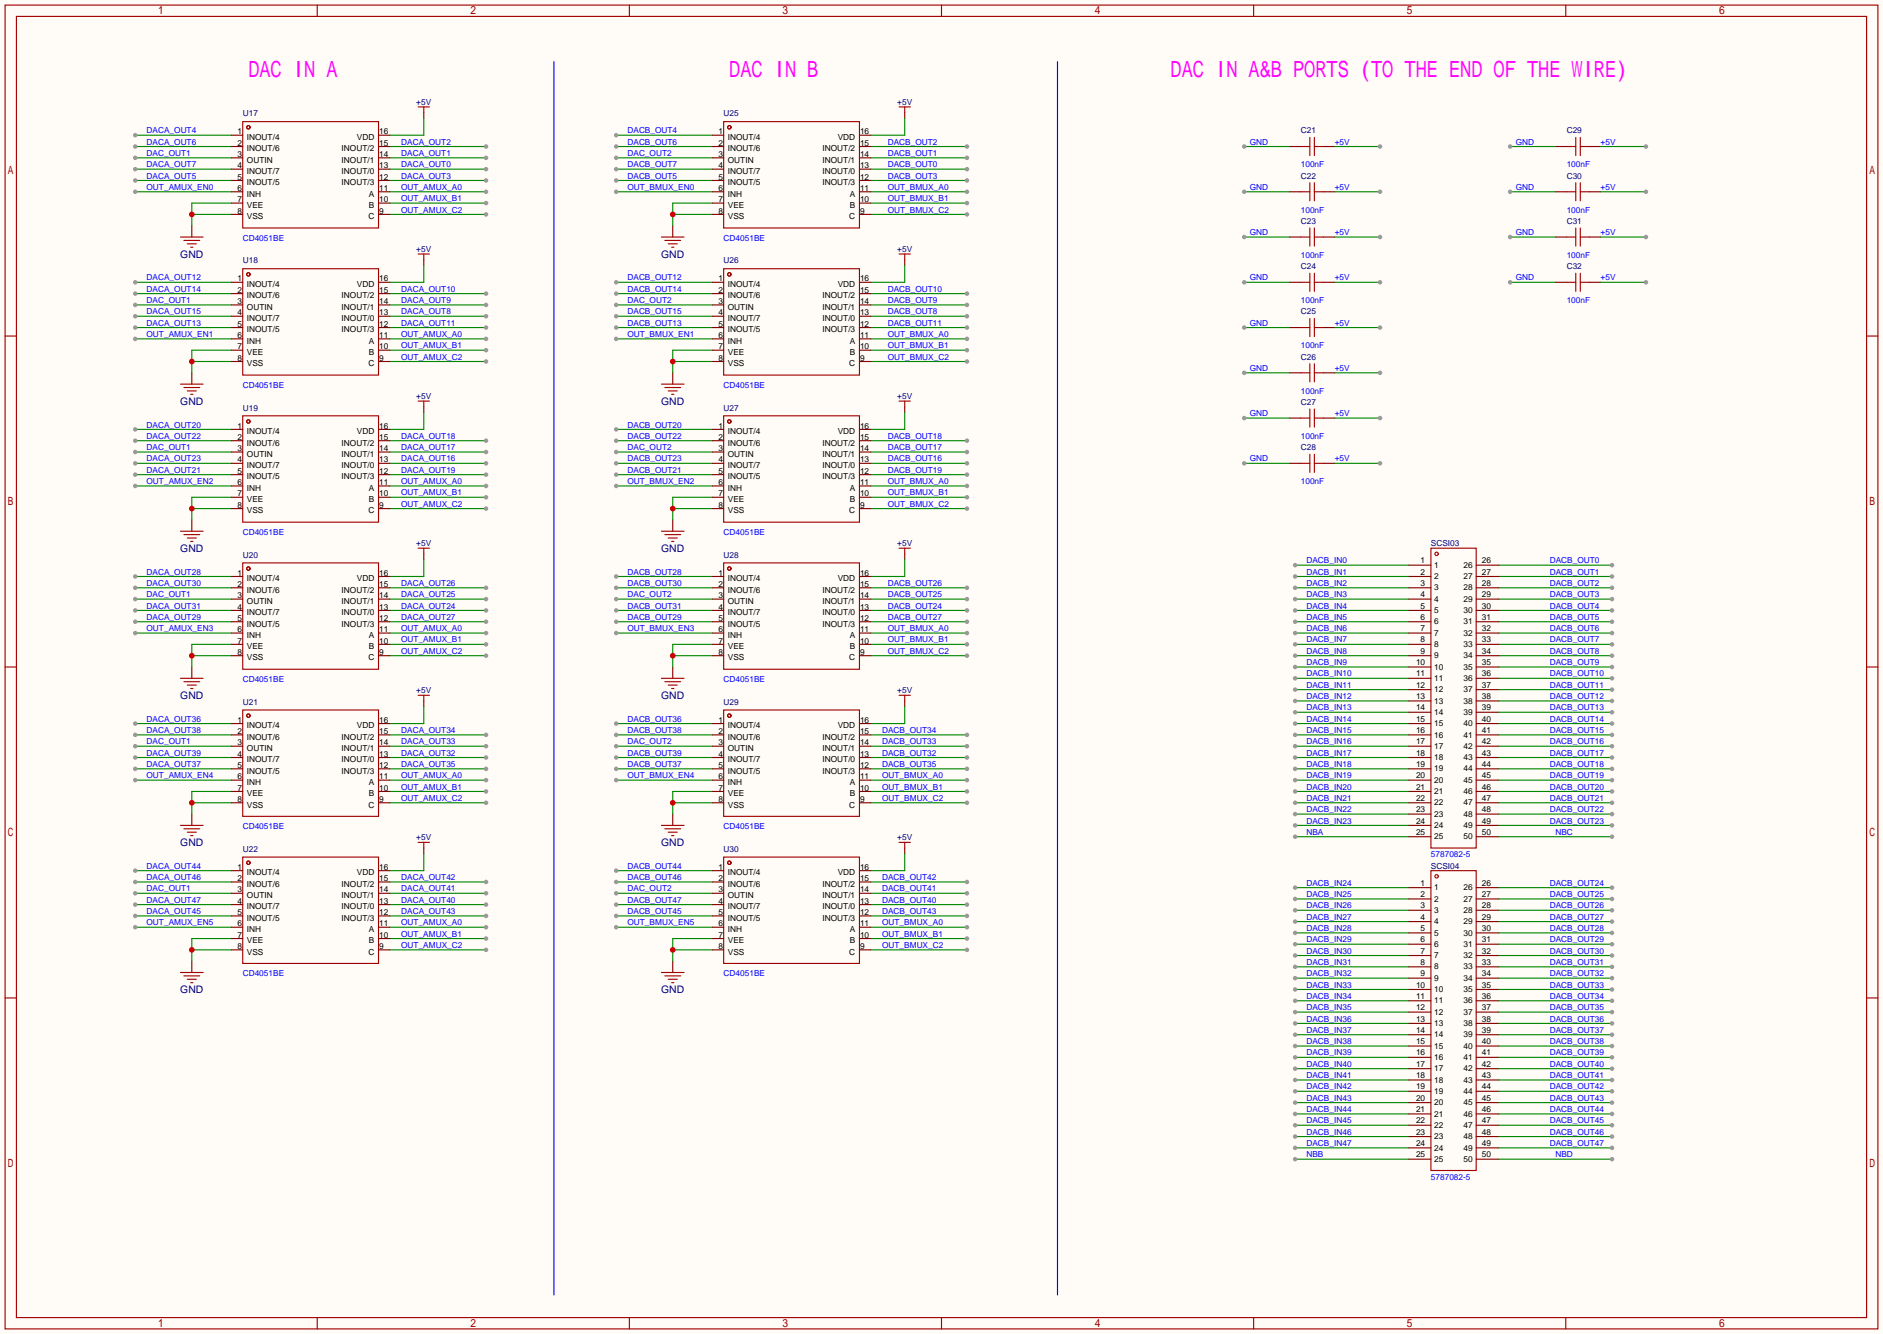
[picture p24: page 2]

DAC IN A&B PORTS (TO THE END OF THE WIRE)

11 INOUT/3 12 INOUT/0 13 INOUT/1 14 INOUT/2 15 VDD 16

### GND

### GND

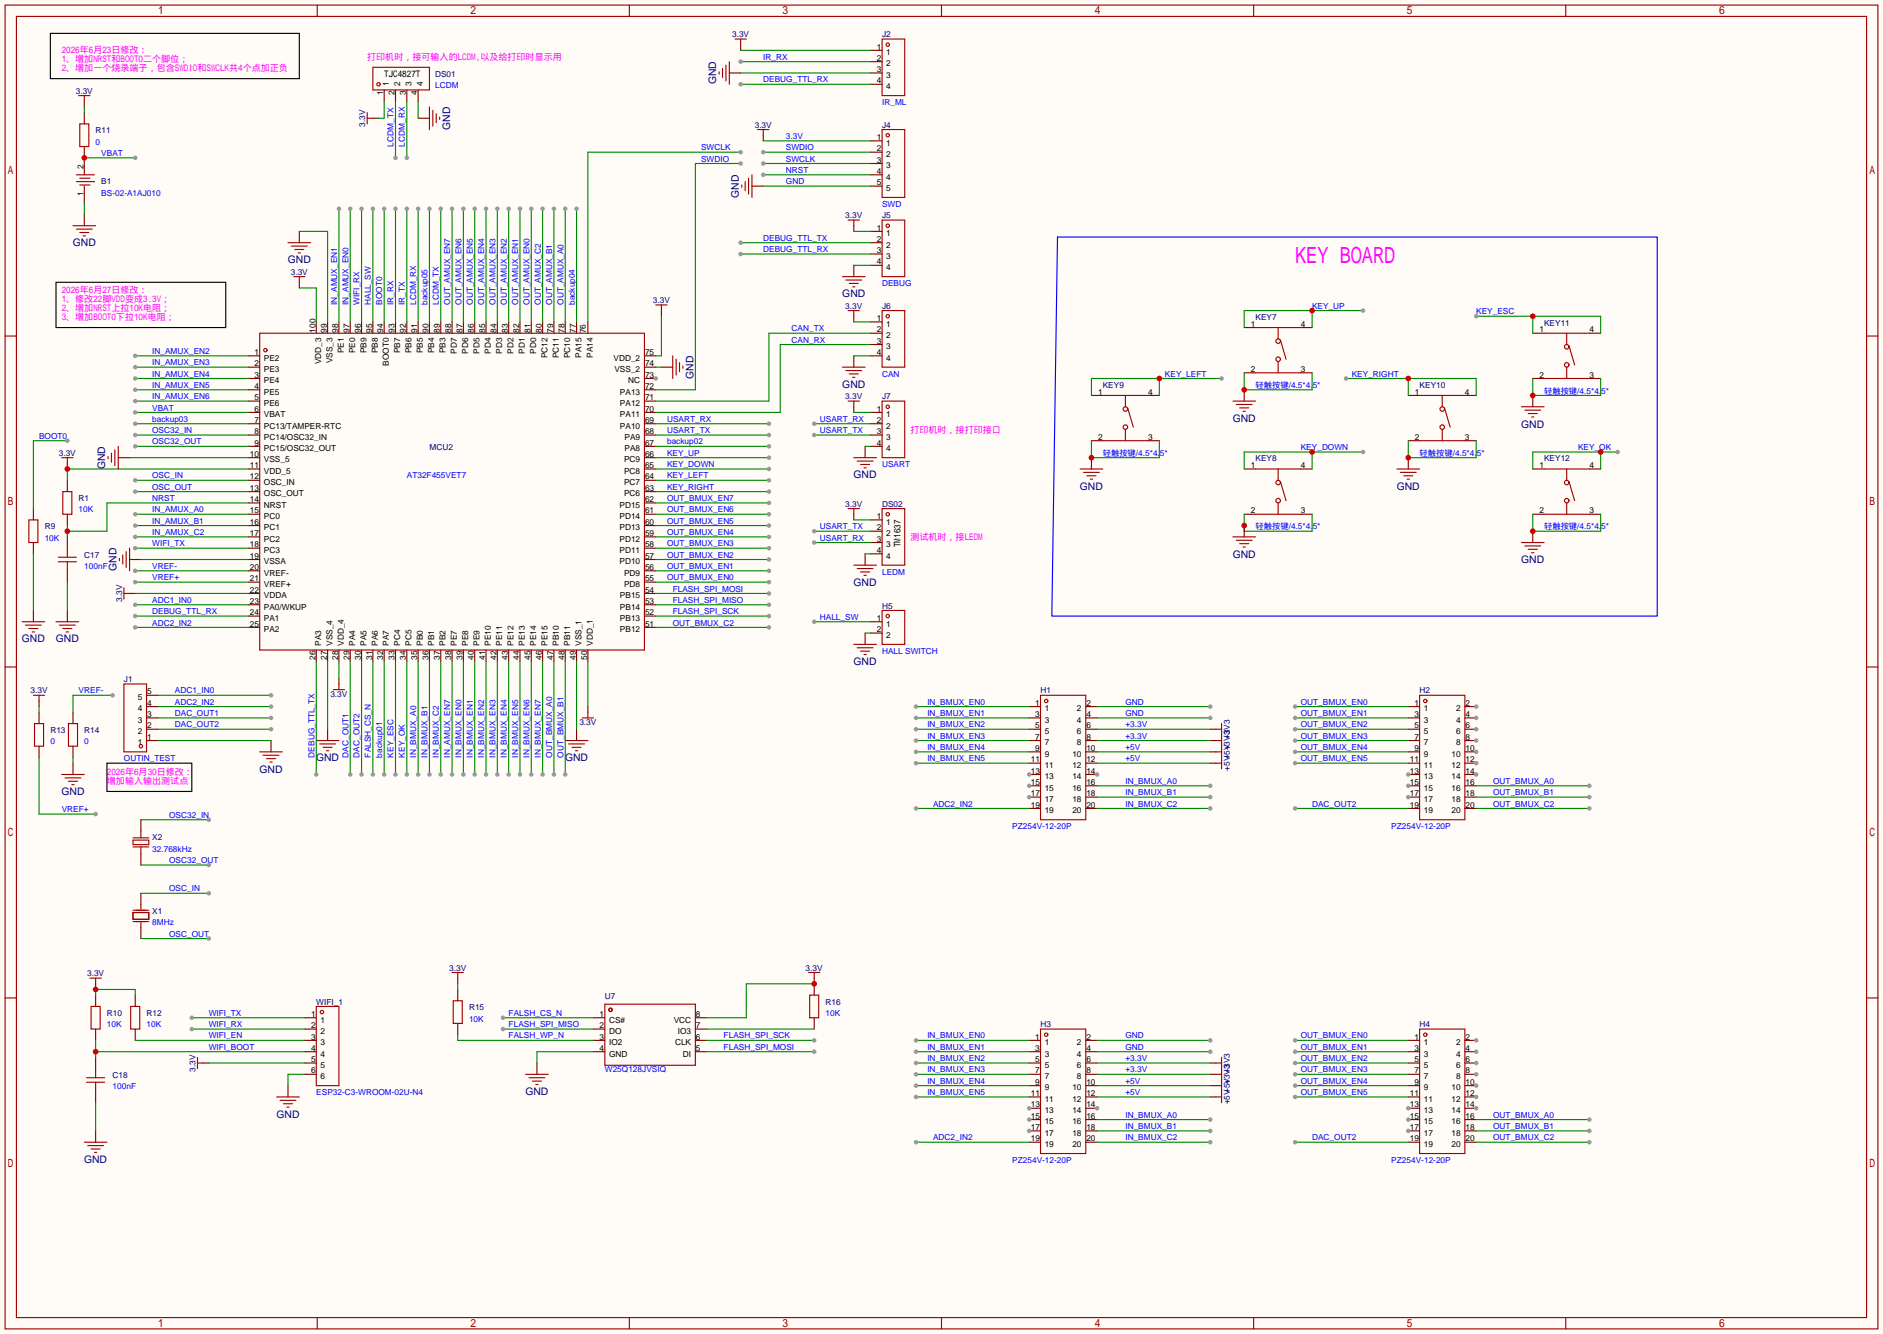
[picture p25: page 3]

### GND

### LED3 10K

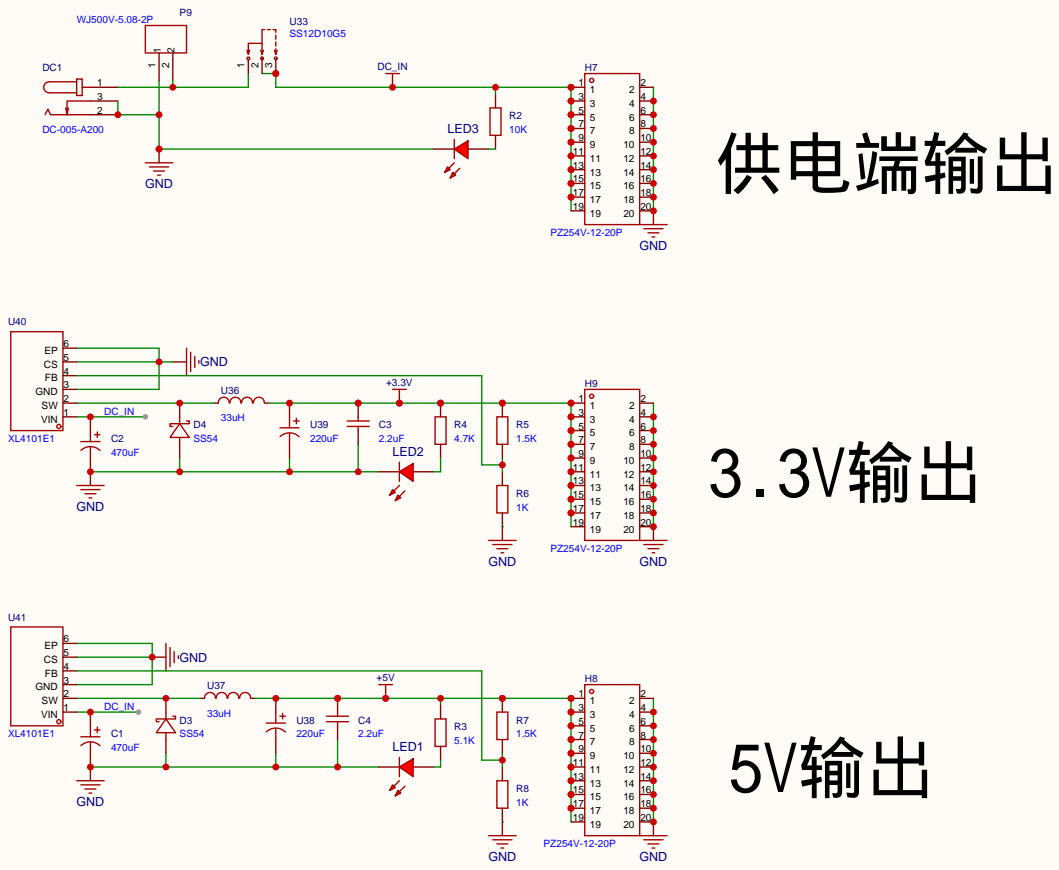
[picture p26: page 4]
