andrewlau2080/IO_BOARD/IO_BOARD/docs/SCH_FIXTURE_2026-07-05.pdf

### GND

### GND

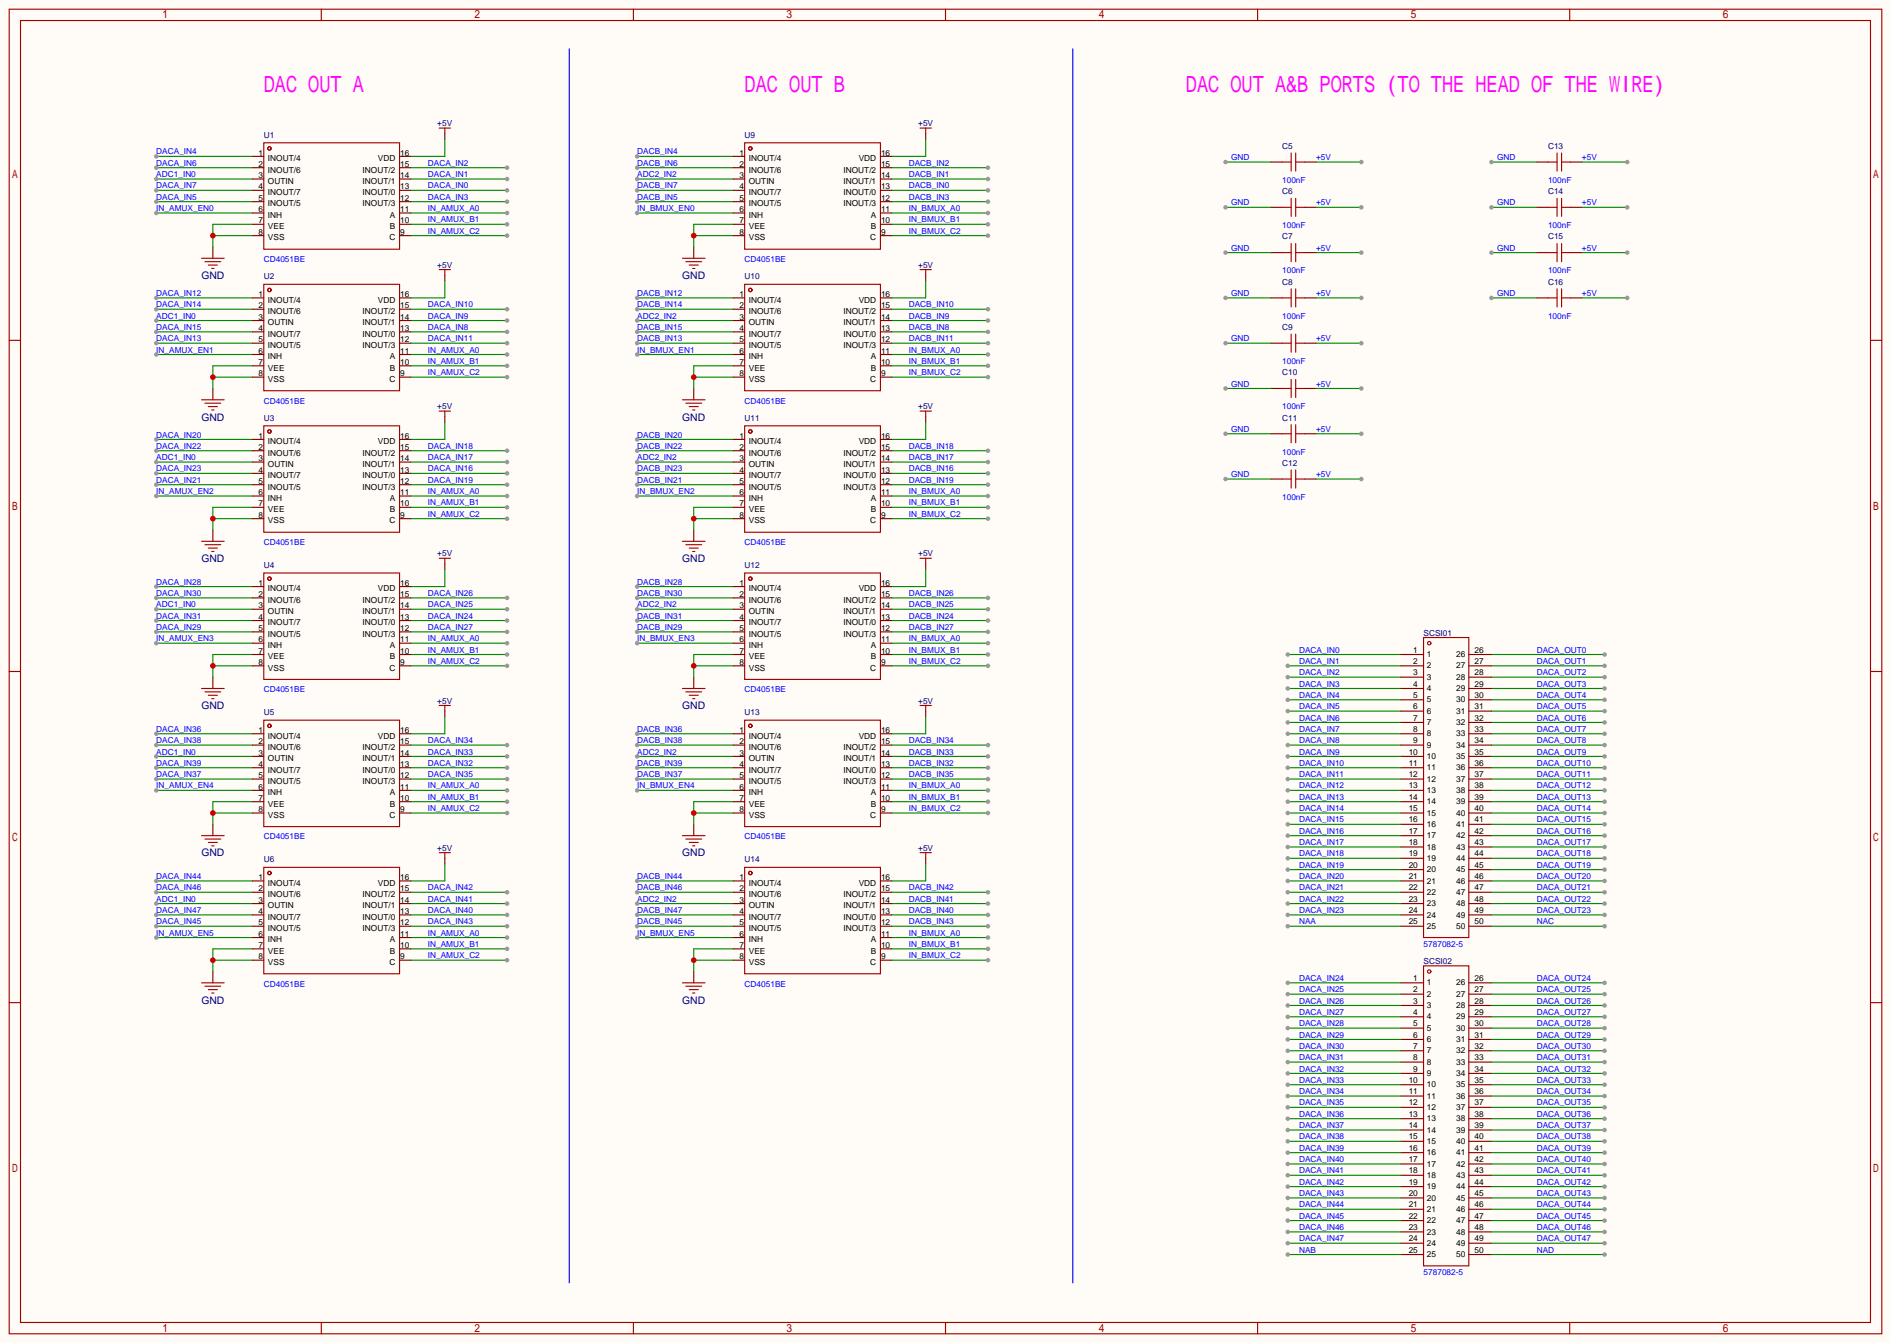
[picture p27: page 1]

DAC OUT A&B PORTS (TO THE HEAD OF THE WIRE)

11 INOUT/3 12 INOUT/0 13 INOUT/1 14 INOUT/2 15 VDD 16

### GND

### GND

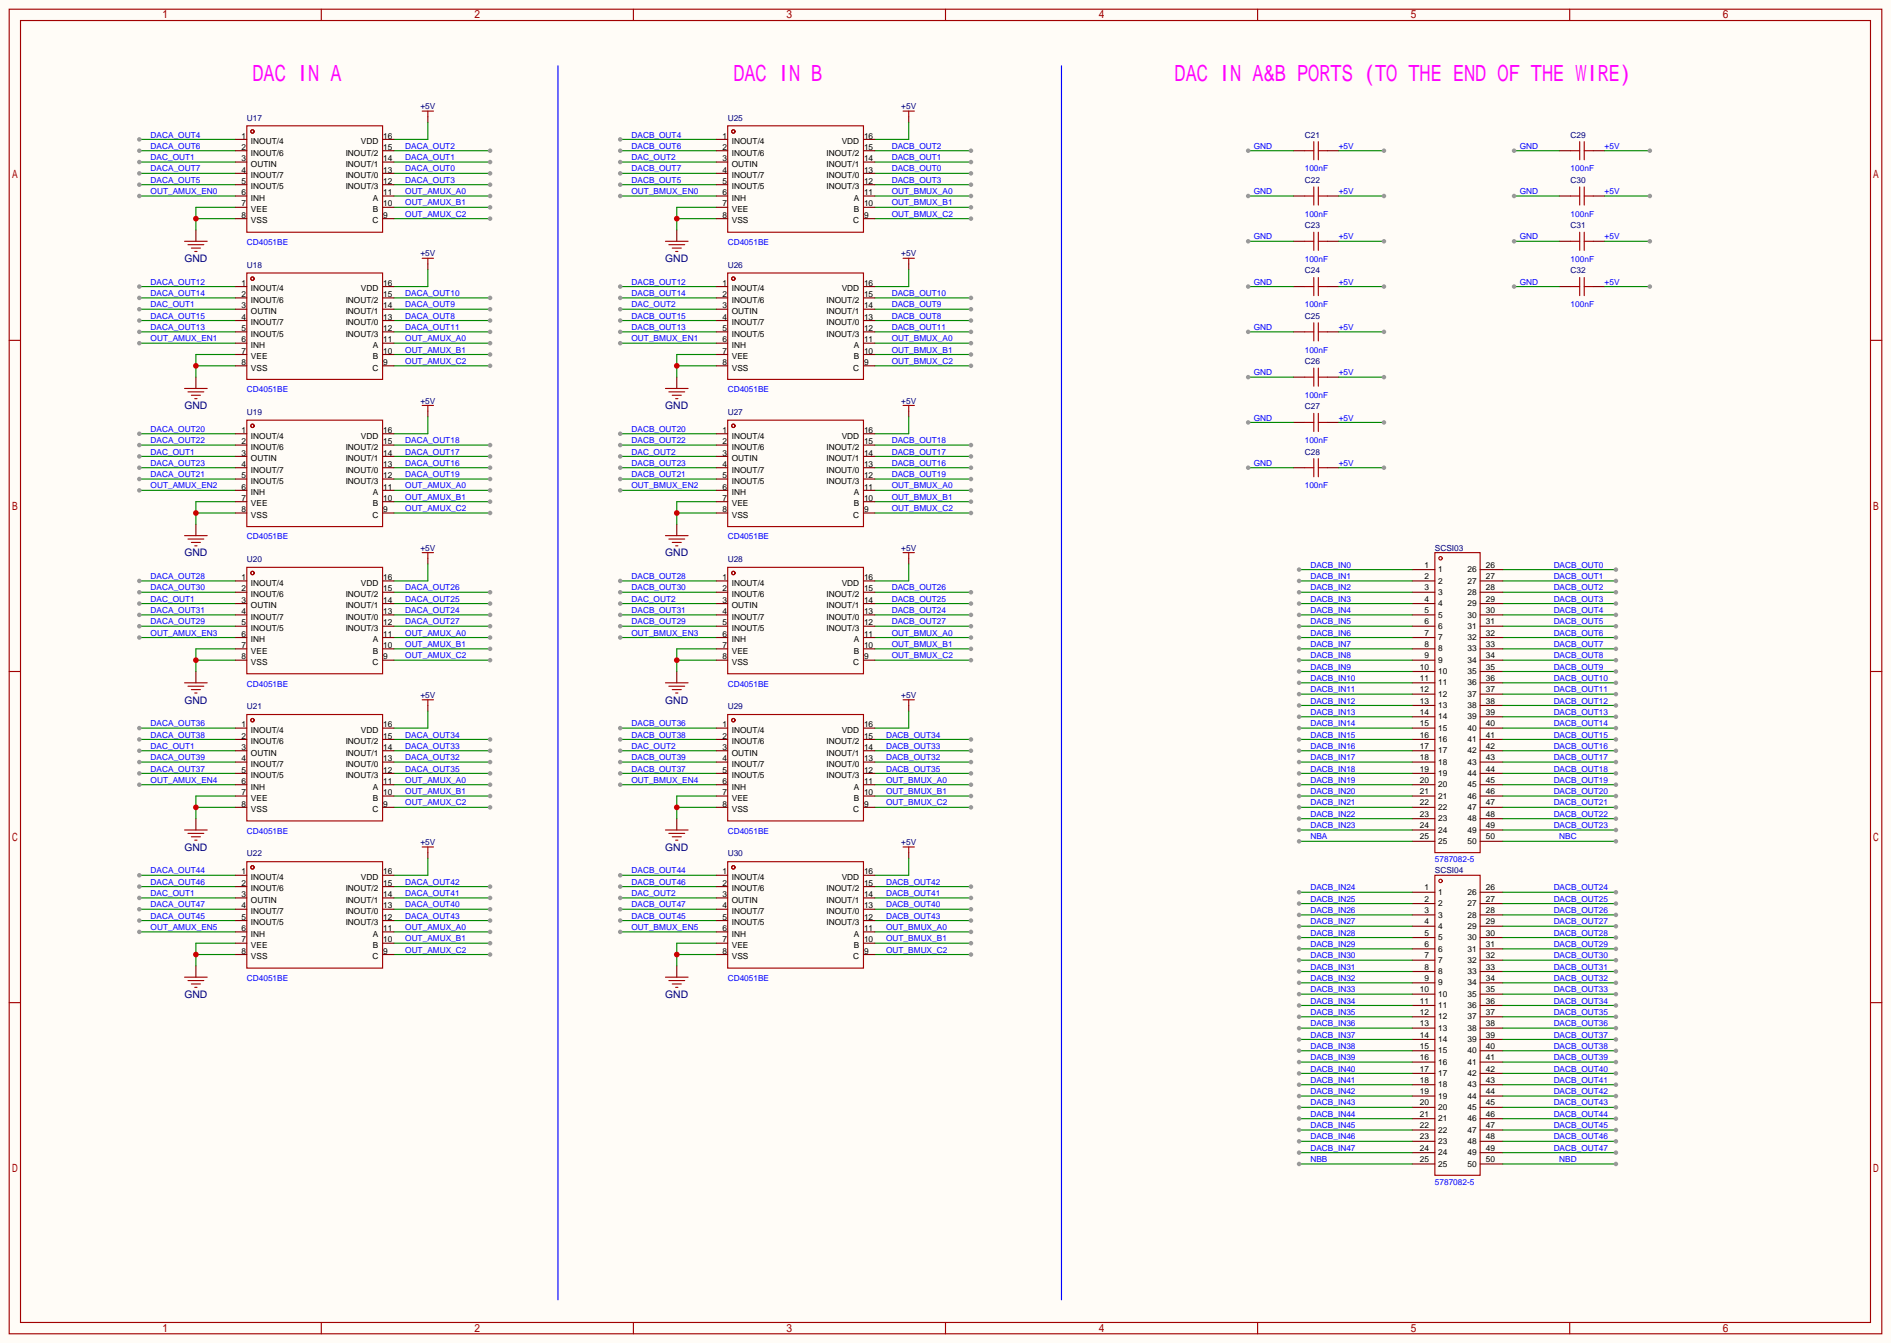
[picture p28: page 2]

DAC IN A&B PORTS (TO THE END OF THE WIRE)

11 INOUT/3 12 INOUT/0 13 INOUT/1 14 INOUT/2 15 VDD 16

### GND

### GND

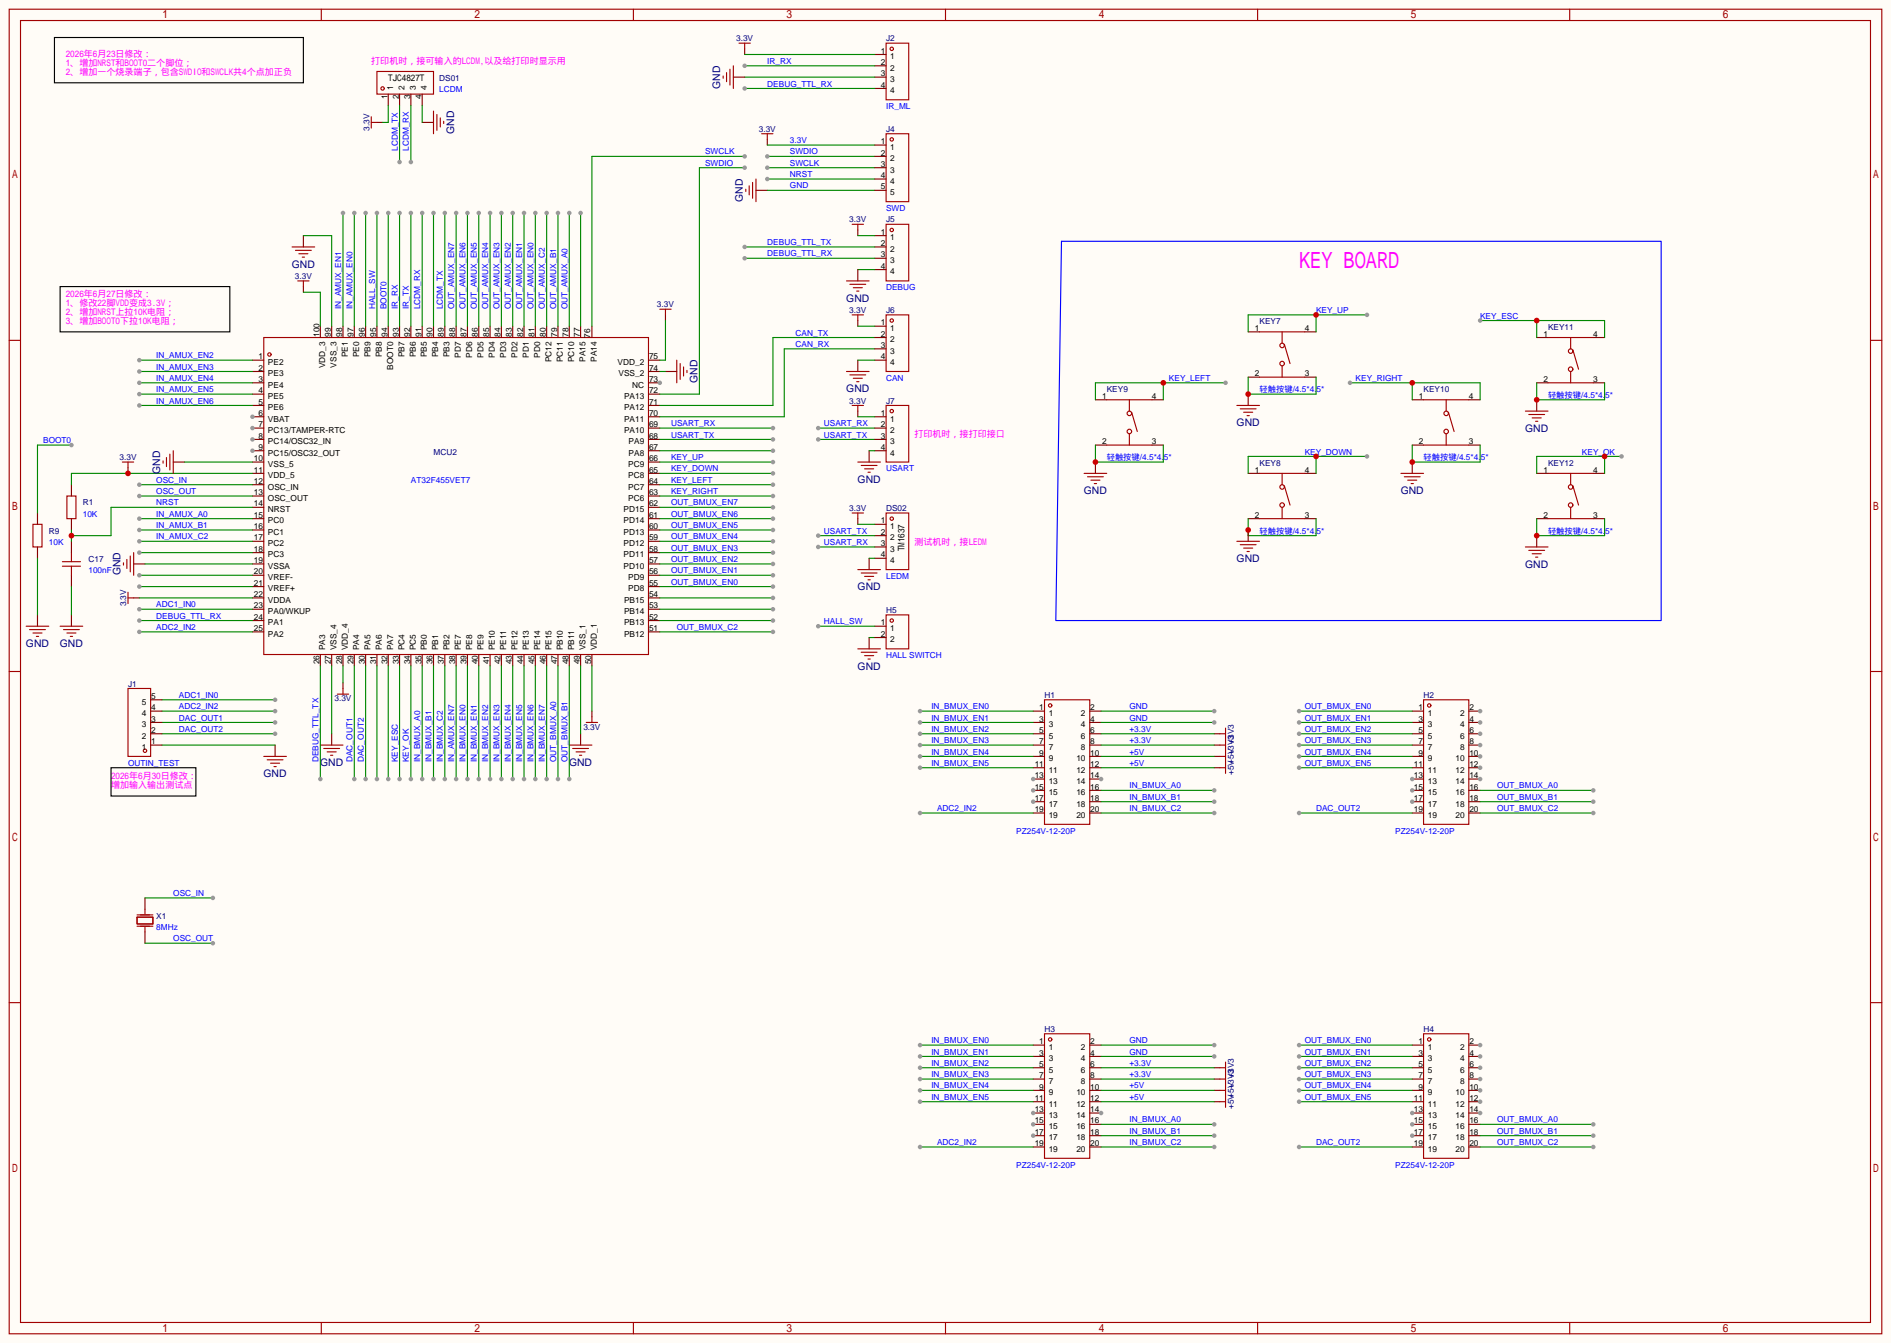
[picture p29: page 3]

### LED3 10K

# 供电端输出

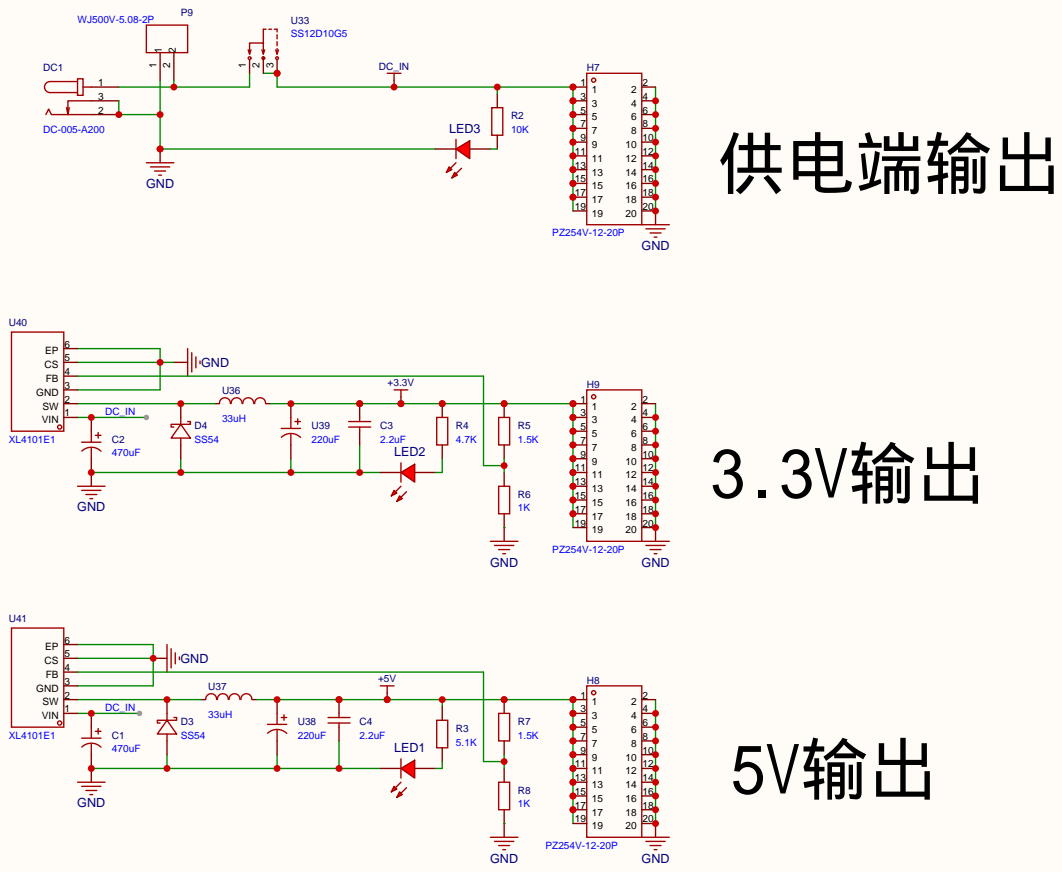
[picture p30: page 4]
