andrewlau2080/IO_BOARD/IO_BOARD/docs/SCH_FIXTURE_2026-06-30.pdf

### GND

### GND


DAC OUT A&B PORTS (TO THE HEAD OF THE WIRE)

11 INOUT/3 12 INOUT/0 13 INOUT/1 14 INOUT/2 15 VDD 16

### GND

### GND


DAC IN A&B PORTS (TO THE END OF THE WIRE)

11 INOUT/3 12 INOUT/0 13 INOUT/1 14 INOUT/2 15 VDD 16

### GND

### GND

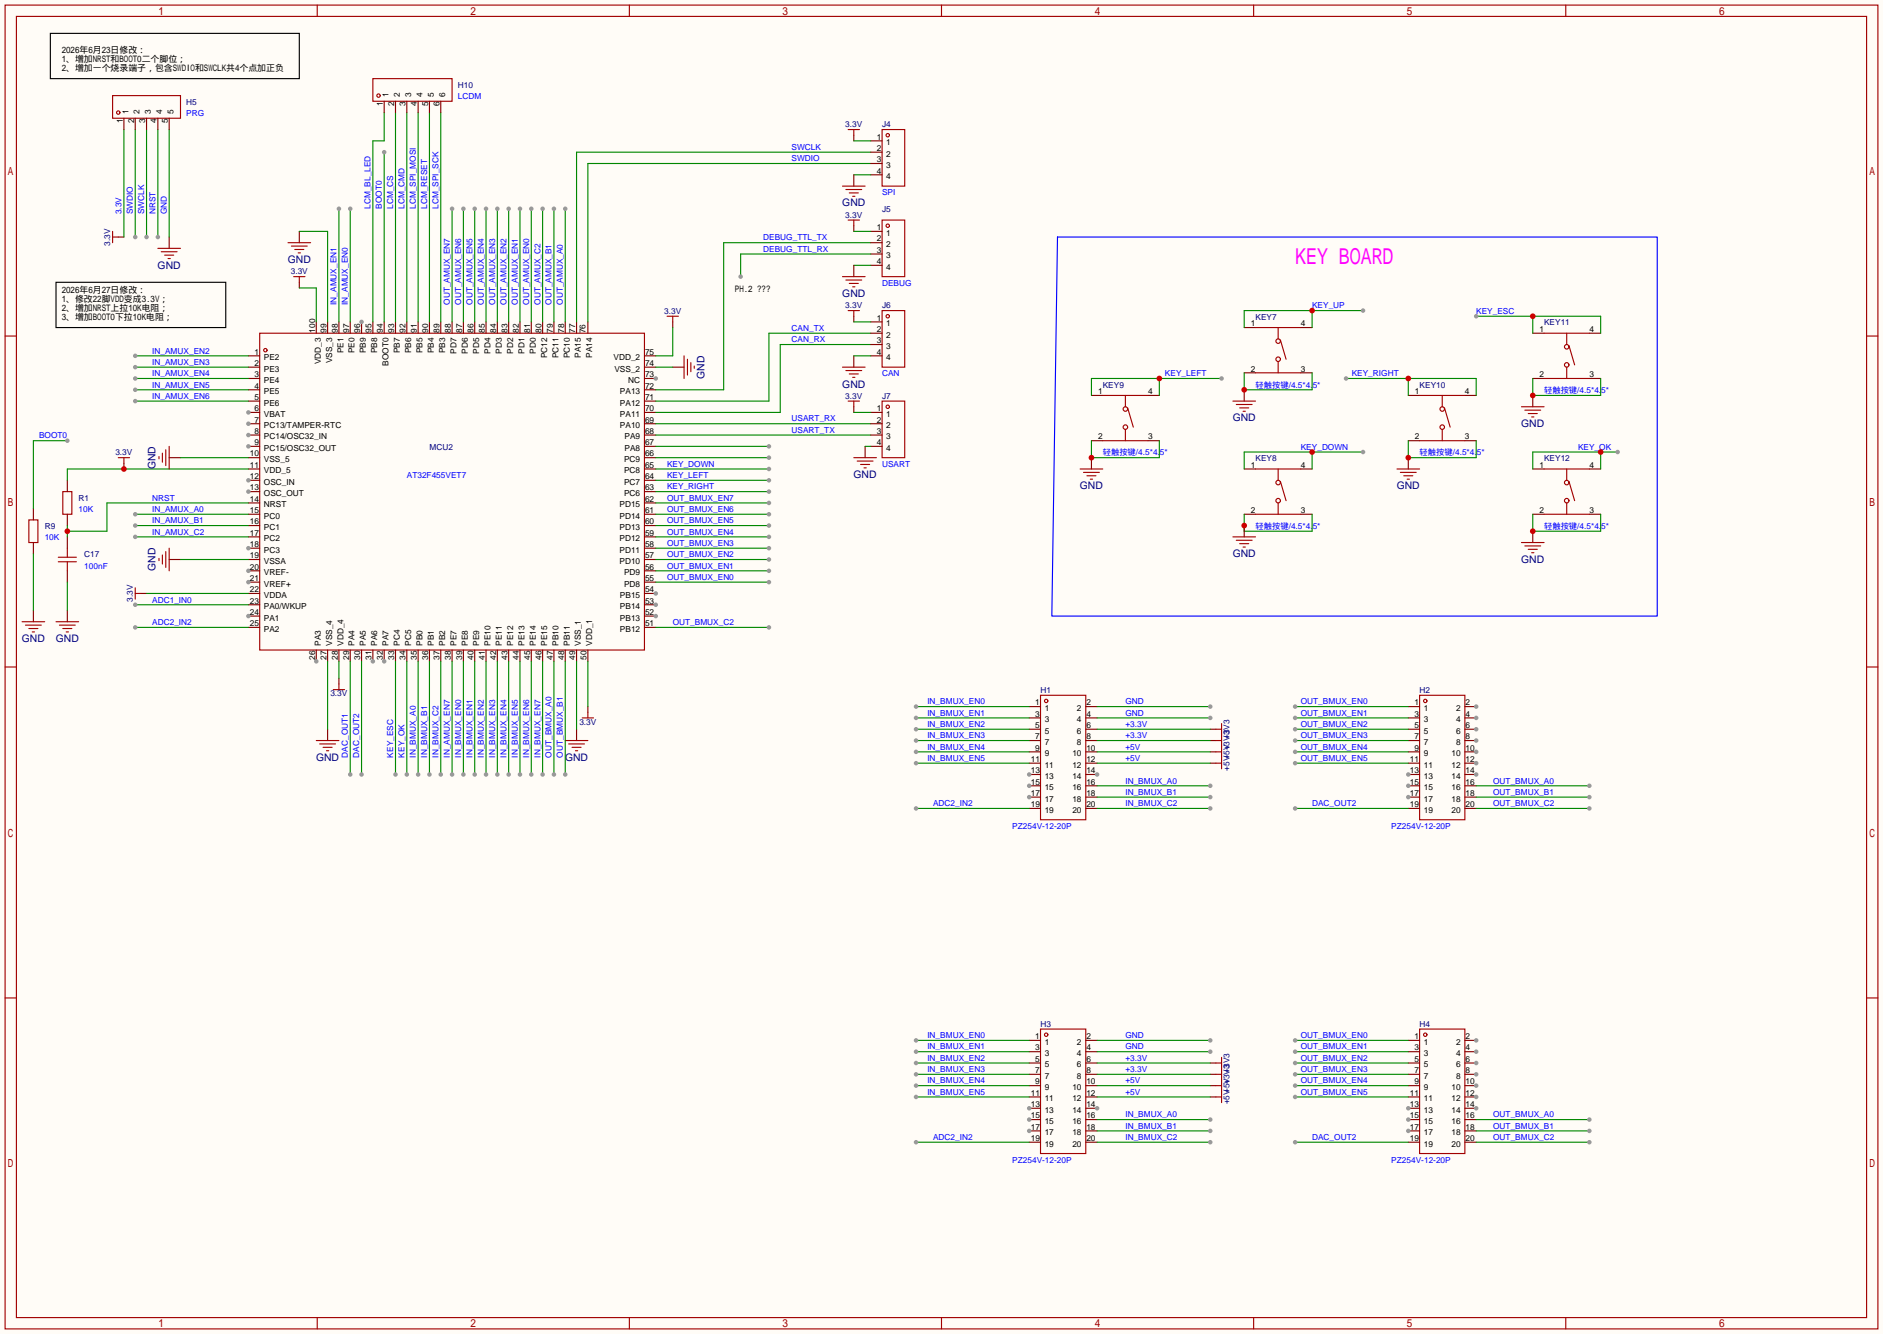
[picture p31: page 3]

3、增加BOOT0下拉10K电阻； ³.3V SWDIO SWCLK NRST GND

### GND

### LED3 10K
