andrewlau2080/IO_BOARD/IO_BOARD/SCH_FIXTURE_2025-07-18.pdf

DAC OUT A | DAC OUT B

# FDB7802-F0DB300K6KC ¹²³⁴⁶⁷⁸⁹

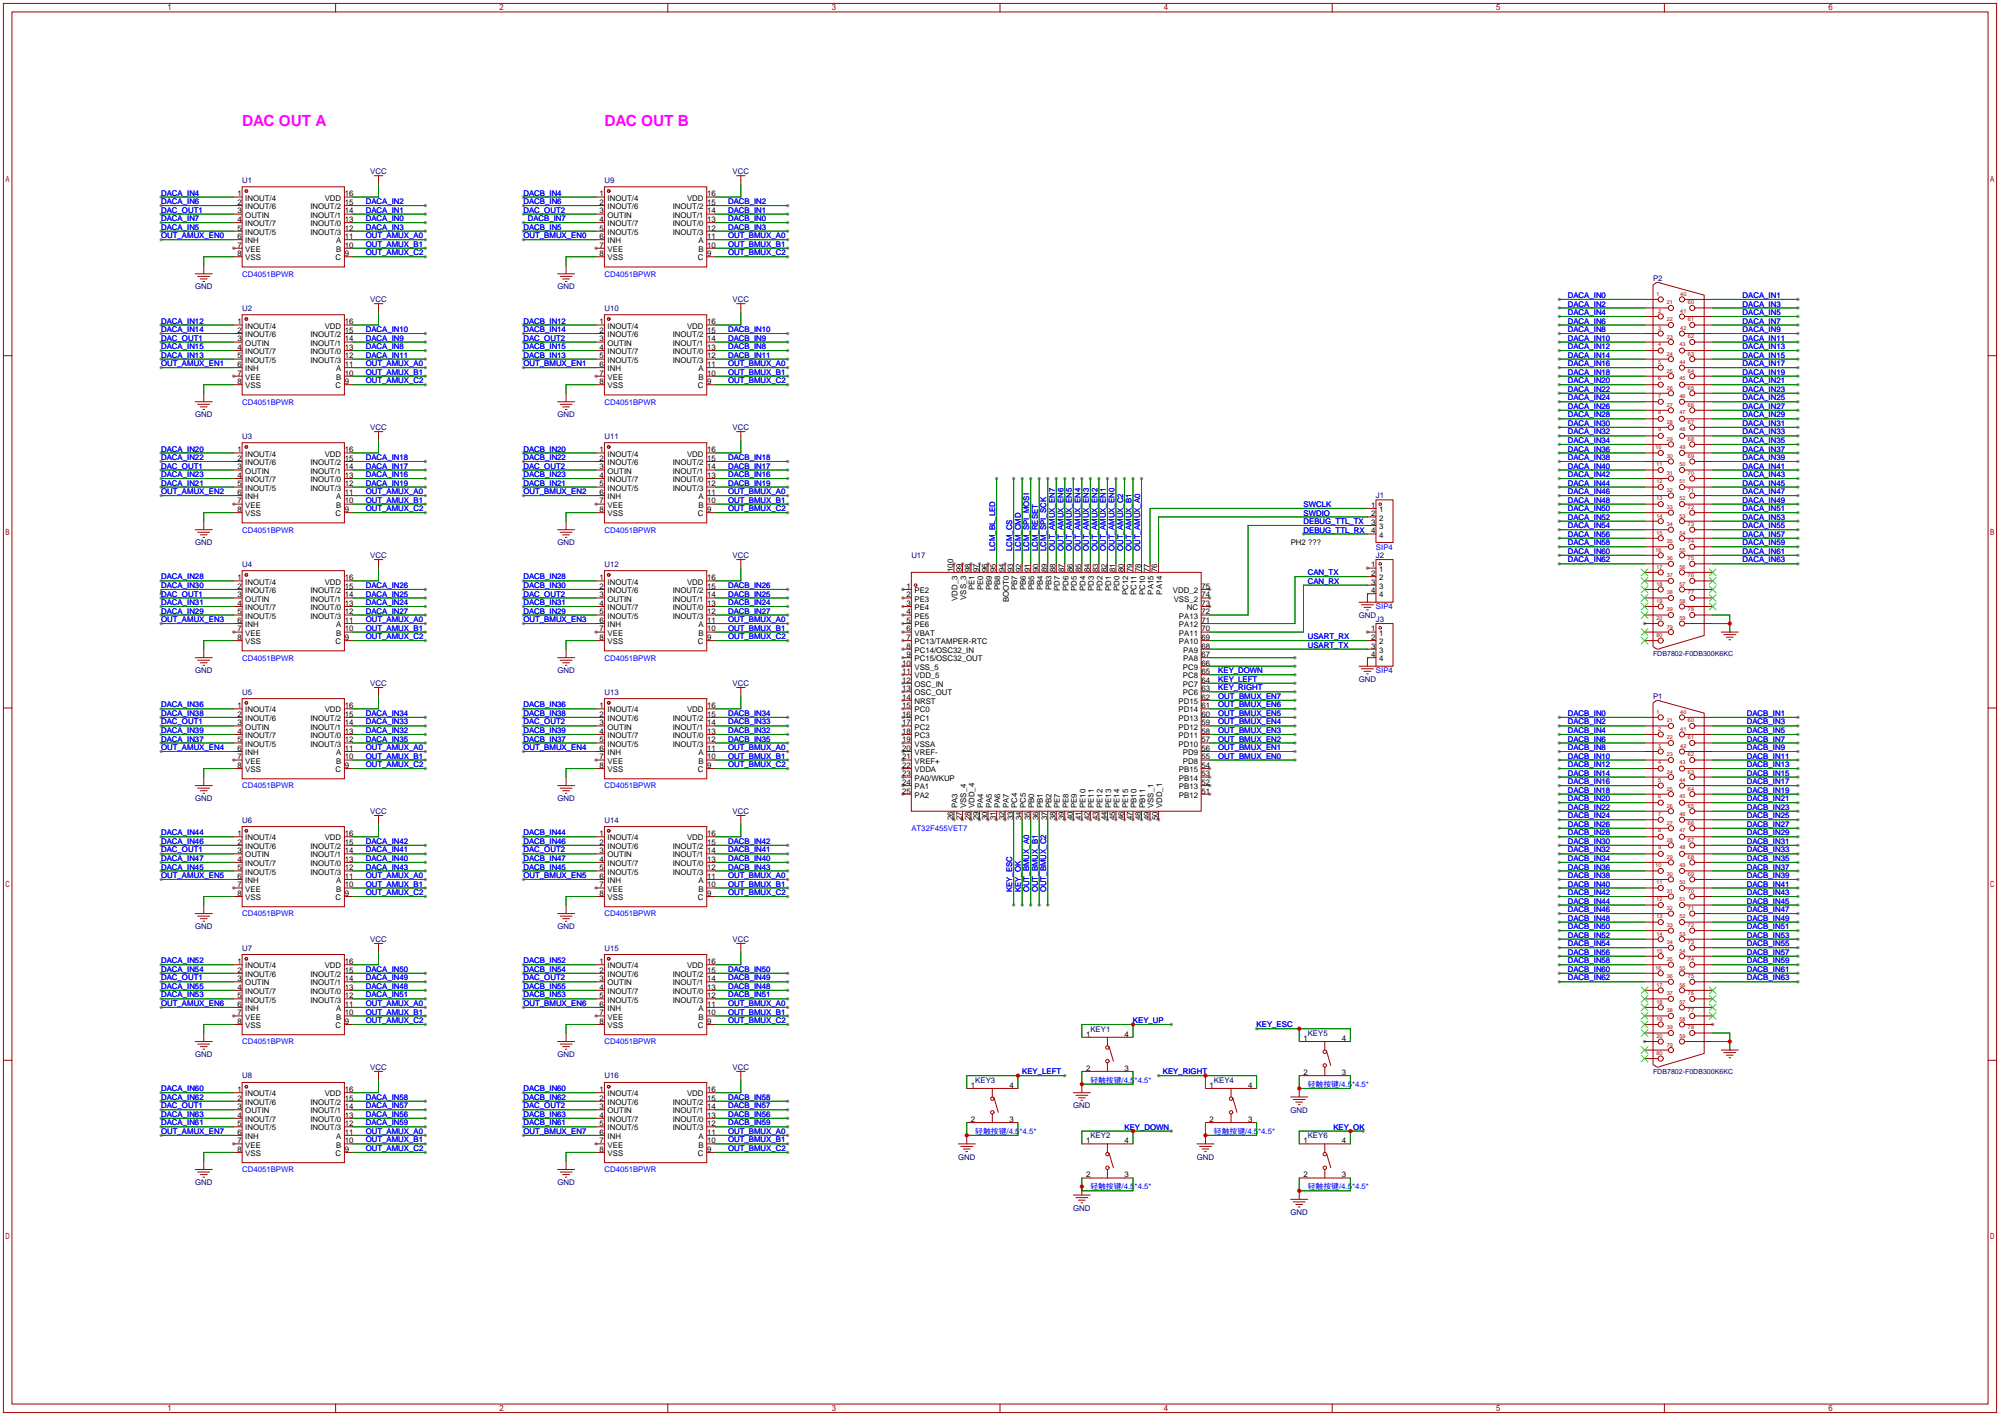
[picture p32: page 1]

11 INOUT/3 12 INOUT/0 13 INOUT/1 14 INOUT/2 15 VDD 16
