andrewlau2080/IO_BOARD/IO_BOARD/inc/first_gen_display.h

#ifndef FIRST_GEN_DISPLAY_H
#define FIRST_GEN_DISPLAY_H

#include <stdint.h>

#define FIRST_GEN_DISPLAY_DIGITS 6U
#define FIRST_GEN_DISPLAY_AUTO_RESULT_PAGE_ROWS 5U
/* 94 active first-generation points occupy three 32-bit endpoint bitmaps. */
#define FIRST_GEN_DISPLAY_AUTO_FAULT_WORDS 3U
#define FIRST_GEN_PRINT_DISPLAY_START    1U
#define FIRST_GEN_PRINT_DISPLAY_COMPLETE 2U
#define FIRST_GEN_PRINT_DISPLAY_ERROR    3U
/* Intermediate and remote-printer-fault pages are separate from NETWORK
 * ERROR so the operator can tell a reachable but faulty printer from a lost
 * WiFi/TCP link. */
#define FIRST_GEN_PRINT_DISPLAY_PRINTING      4U
#define FIRST_GEN_PRINT_DISPLAY_PRINTER_ERROR 5U

#define FIRST_GEN_KEY_NONE       0xFFU
#define FIRST_GEN_KEY_SET        0xF3U
#define FIRST_GEN_KEY_CLEAR      0xF4U
#define FIRST_GEN_KEY_PLUS       0xF5U
#define FIRST_GEN_KEY_MINUS      0xF0U

#define FIRST_GEN_DISPLAY_COLOR_BLACK       0U
#define FIRST_GEN_DISPLAY_COLOR_BLUE        31U
#define FIRST_GEN_DISPLAY_COLOR_RED         63488U
#define FIRST_GEN_DISPLAY_COLOR_GREEN       2016U
/* Exact dark-green background used by the automatic all-connection PASS
 * summary.  WiFi setup uses this same value for a verified link. */
#define FIRST_GEN_DISPLAY_COLOR_AUTO_PASS_GREEN 992U
#define FIRST_GEN_DISPLAY_COLOR_WHITE       65535U
#define FIRST_GEN_DISPLAY_COLOR_ROW_BG      61374U
#define FIRST_GEN_DISPLAY_COLOR_PALE_BLUE   50719U
#define FIRST_GEN_DISPLAY_COLOR_PALE_CYAN   49151U
#define FIRST_GEN_DISPLAY_COLOR_PALE_PINK   61503U
#define FIRST_GEN_DISPLAY_COLOR_DARK_PINK   46521U

extern volatile uint32_t g_first_gen_lcdm_touch_count;
extern volatile uint32_t g_first_gen_lcdm_key_press_count;
extern volatile uint32_t g_first_gen_lcdm_key_release_count;
extern volatile uint8_t g_first_gen_lcdm_last_event_type;
extern volatile uint8_t g_first_gen_lcdm_last_touch_event;
extern volatile uint8_t g_first_gen_lcdm_last_key;
extern volatile uint16_t g_first_gen_lcdm_last_x;
extern volatile uint16_t g_first_gen_lcdm_last_y;

void first_gen_display_init(void);
void first_gen_display_clear(void);
uint8_t first_gen_display_is_lcdm(void);
uint8_t first_gen_display_key_read_raw(void);
/* End a full-screen maintenance overlay and force the normal K1-K4-only
 * tester page to rebuild on its next draw. */
void first_gen_display_leave_maintenance(void);
/* PB8/HALL_SW is low-active.  The LCDM header keeps this small indicator
 * visible across normal, result, and print workflow pages. */
void first_gen_display_set_hall_input(uint8_t active);
/* The normal LCDM header shows the AP association in WIFI above HALL IN.
 * TCP print-host availability is independent; the display layer caches this
 * flag and repaints only the small indicator cell. */
void first_gen_display_set_wifi_connected(uint8_t connected);
/* Draw the full-width PDF print workflow body: START PRINTING, PRINTING,
 * COMPLETE, PRINTER FAULT, or NETWORK ERROR requiring K3 recovery.
 * The fixed title and K1-K4 band remain part of the same single LCDM page. */
void first_gen_display_show_print_progress(uint8_t state);
void first_gen_display_effect_step(void);
void first_gen_display_write_raw6(const uint8_t segments[FIRST_GEN_DISPLAY_DIGITS]);
void first_gen_display_write_text6(const char text[FIRST_GEN_DISPLAY_DIGITS]);
void first_gen_display_write_learn_summary(uint16_t out_count, uint16_t in_count, uint32_t total);
void first_gen_display_show_page(const char *top_right,
                                 const char *status_text,
                                 const char *main_text,
                                 const char *result_text,
                                 const char *sub_text,
                                 uint16_t status_color,
                                 uint16_t result_bg,
                                 uint16_t result_fg);
void first_gen_display_show_auto_table_page(uint8_t page, uint16_t active_point);
void first_gen_display_show_auto_table_ng(uint8_t page, uint16_t point);
void first_gen_display_show_auto_table_ng_pair(uint8_t page, uint16_t out_point, uint16_t in_point);
/* Load all self-test NG marks into the display cache without sending per-pair
 * raster commands.  The caller then renders the completed result page once. */
void first_gen_display_set_self_test_matrix(const uint32_t *matrix,
                                            uint16_t point_count,
                                            uint8_t words_per_row);
void first_gen_display_set_k1_page_hint(uint8_t enabled);
void first_gen_display_set_auto_test_blink(uint8_t enabled);
void first_gen_display_auto_test_blink_step(void);
void first_gen_display_show_learn_table_page(uint8_t page,
                                             uint16_t active_point,
                                             uint16_t scan_point,
                                             uint16_t pair_count,
                                             uint32_t point_count,
                                             uint8_t done);
void first_gen_display_clear_learn_table_groups(void);
void first_gen_display_set_learn_table_group_connection(uint16_t out_point,
                                                        uint16_t in_point,
                                                        uint16_t group_index);
void first_gen_display_apply_learn_table_groups(const uint16_t out_groups[],
                                                const uint16_t in_groups[],
                                                uint16_t active_point);
void first_gen_display_clear_auto_test_lines(void);
/* Clear cached AUTO rows while retaining the current LCDM page/key strip.
 * Used when a newly scanned edge merges two electrical circuits. */
void first_gen_display_reset_auto_test_result_lines(void);
/* Cache one ordered AUTO result row.  The scan layer may add a visual-only
 * open-endpoint locator row; actual I/O counts are supplied separately. */
void first_gen_display_add_auto_test_result_line(uint16_t row_index, const char *line);
/* Result rows may retain an open learned endpoint solely to show where the
 * fault is.  Keep the footer status based on the actual measured I/O count,
 * not on those visual-only placeholder labels. */
void first_gen_display_set_auto_test_result_actual_counts(uint16_t input_count,
                                                          uint16_t output_count);
uint8_t first_gen_display_auto_test_page_count(void);
void first_gen_display_show_auto_test_result_page(uint8_t page, uint8_t done);
/* Final AUTO summary pages use a compressed RESULT/DETAILS caption below the
 * main title. PASS retains its 2/5 result panel and 3/5 three-line TOTAL
 * panel. NG has no separate "NG" word: its full-width red body shows Ixxx
 * above and Oxxx below. NG blink updates only that body, never K1-K4. */
void first_gen_display_show_auto_test_pass_summary(const char *total_text);
void first_gen_display_show_auto_test_ng_summary(const char *fault_text);
void first_gen_display_update_auto_test_ng_detail(const char *fault_text);
/* The live AUTO monitor keeps the ordinary result records in RAM.  When an
 * open/short is found after PASS, tag every associated I/O endpoint so K1
 * result pages can flash the complete affected connection group. */
void first_gen_display_set_auto_test_result_fault(uint16_t out_point,
                                                  uint16_t in_point,
                                                  uint8_t problem_type);
void first_gen_display_set_auto_test_result_fault_group(const uint32_t out_bits[],
                                                        const uint32_t in_bits[],
                                                        uint8_t word_count,
                                                        uint8_t problem_type);
void first_gen_display_clear_auto_test_result_fault(void);
void first_gen_display_set_auto_test_result_fault_blink(uint8_t visible);
/* Update one already-cached AUTO row immediately and return its displayed
 * page.  Used while the matrix is still being scanned. */
uint8_t first_gen_display_show_auto_test_result_row(uint16_t row_index, uint8_t done);
/* Compatibility entry point for older callers. */
void first_gen_display_show_auto_test_line(uint16_t out_point, const char *line, uint8_t done);

#endif
