andrewlau2080/IO_BOARD/IO_BOARD/src/at32f45x_clock.c

/**
  **************************************************************************
  * @file     at32f45x_clock.c
  * @brief    system clock config program
  **************************************************************************
  *
  * Copyright (c) 2025, Artery Technology, All rights reserved.
  *
  * The software Board Support Package (BSP) that is made available to
  * download from Artery official website is the copyrighted work of Artery.
  * Artery authorizes customers to use, copy, and distribute the BSP
  * software and its related documentation for the purpose of design and
  * development in conjunction with Artery microcontrollers. Use of the
  * software is governed by this copyright notice and the following disclaimer.
  *
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
  **************************************************************************
  */

/* includes ------------------------------------------------------------------*/
#include "at32f45x_clock.h"

/** @addtogroup AT32F455_periph_template
  * @{
  */

/** @addtogroup 455_System_clock_configuration System_clock_configuration
  * @{
  */

/**
  * @brief  system clock config program
  * @note   the system clock is configured as follow:
  *         - system clock        = (hext * pll_ns)/(pll_ms * pll_fp)
  *         - system clock source = pll (hext)
  *         - hext                = 8000000
  *         - sclk                = 192000000
  *         - ahbdiv              = 1
  *         - ahbclk              = 192000000
  *         - apb2div             = 1
  *         - apb2clk             = 192000000
  *         - apb1div             = 1
  *         - apb1clk             = 192000000
  *         - pll_ns              = 96
  *         - pll_ms              = 1
  *         - pll_fp              = 4
  * @param  none
  * @retval none
  */
void system_clock_config(void)
{
  /* reset crm */
  crm_reset();

  /* set the flash clock divider */
  flash_psr_set(FLASH_WAIT_CYCLE_5);

    /* enable pwc periph clock */
  crm_periph_clock_enable(CRM_PWC_PERIPH_CLOCK, TRUE);
 
  /* config ldo voltage */
  pwc_ldo_output_voltage_set(PWC_LDO_OUTPUT_1V3);

  crm_clock_source_enable(CRM_CLOCK_SOURCE_HEXT, TRUE);

  /* wait till hext is ready */
  while(crm_hext_stable_wait() == ERROR)
  {
  }

  /* config pll clock resource */
  crm_pll_config(CRM_PLL_SOURCE_HEXT, 96, 1, CRM_PLL_FP_4);

  /* config pllu divider */
  crm_pllu_div_set(CRM_PLL_FU_16);

  /* pllu enable  */
  crm_pllu_output_set(TRUE);

  /* enable pll */
  crm_clock_source_enable(CRM_CLOCK_SOURCE_PLL, TRUE);

  /* wait till pll is ready */
  while(crm_flag_get(CRM_PLL_STABLE_FLAG) != SET)
  {
  }

  /* config ahbclk */
  crm_ahb_div_set(CRM_AHB_DIV_1);

  /* config apb3clk, the maximum frequency of APB3 clock is 90 MHz */
  crm_apb3_div_set(CRM_APB3_DIV_4);

  /* config apb2clk, the maximum frequency of APB2 clock is 192 MHz */
  crm_apb2_div_set(CRM_APB2_DIV_1);

  /* config apb1clk, the maximum frequency of APB1 clock is 192 MHz */
  crm_apb1_div_set(CRM_APB1_DIV_1);

  /* enable auto step mode */
  crm_auto_step_mode_enable(TRUE);

  /* select pll as system clock source */
  crm_sysclk_switch(CRM_SCLK_PLL);

  /* wait till pll is used as system clock source */
  while(crm_sysclk_switch_status_get() != CRM_SCLK_PLL)
  {
  }

  /* disable auto step mode */
  crm_auto_step_mode_enable(FALSE);

  /* update system_core_clock global variable */
  system_core_clock_update();
}

/**
  * @}
  */ 

/**
  * @}
  */ 
