andrewlau2080/IO_BOARD/.vendor/AT32F45x_Firmware_Library_V2.0.1/project/at_start_f455/examples/adc/current_vref_value_check/src/main.c

/**
  **************************************************************************
  * @file     main.c
  * @brief    main program
  **************************************************************************
  *
  * Copyright (c) 2025, Artery Technology, All rights reserved.
  *
  * The software Board Support Package (BSP) that is made available to
  * download from Artery official website is the copyrighted work of Artery.
  * Artery authorizes customers to use, copy, and distribute the BSP
  * software and its related documentation for the purpose of design and
  * development in conjunction with Artery microcontrollers. Use of the
  * software is governed by this copyright notice and the following disclaimer.
  *
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
  **************************************************************************
  */

#include "at32f45x_board.h"
#include "at32f45x_clock.h"

/** @addtogroup AT32F455_periph_examples
  * @{
  */

/** @addtogroup 455_ADC_current_vref_value_check ADC_current_vref_value_check
  * @{
  */

__IO uint16_t adc1_ordinary_value = 0;
__IO uint32_t adc1_overflow_flag = 0;
__IO uint32_t adc1_conversion_fail_flag = 0;
__IO uint32_t error_times_index = 0;

/**
  * @brief  dma configuration.
  * @param  none
  * @retval none
  */
static void dma_config(void)
{
  dma_init_type dma_init_struct;
  crm_periph_clock_enable(CRM_DMA1_PERIPH_CLOCK, TRUE);
  nvic_irq_enable(DMA1_Channel1_IRQn, 0, 0);

  dma_reset(DMA1_CHANNEL1);
  dma_default_para_init(&dma_init_struct);
  dma_init_struct.buffer_size = 1;
  dma_init_struct.direction = DMA_DIR_PERIPHERAL_TO_MEMORY;
  dma_init_struct.memory_base_addr = (uint32_t)&adc1_ordinary_value;
  dma_init_struct.memory_data_width = DMA_MEMORY_DATA_WIDTH_HALFWORD;
  dma_init_struct.memory_inc_enable = FALSE;
  dma_init_struct.peripheral_base_addr = (uint32_t)&(ADC1->odt);
  dma_init_struct.peripheral_data_width = DMA_PERIPHERAL_DATA_WIDTH_HALFWORD;
  dma_init_struct.peripheral_inc_enable = FALSE;
  dma_init_struct.priority = DMA_PRIORITY_HIGH;
  dma_init_struct.loop_mode_enable = TRUE;
  dma_init(DMA1_CHANNEL1, &dma_init_struct);

  dmamux_enable(DMA1, TRUE);
  dmamux_init(DMA1MUX_CHANNEL1, DMAMUX_DMAREQ_ID_ADC1);

  /* disable dma transfer complete interrupt */
  dma_interrupt_enable(DMA1_CHANNEL1, DMA_FDT_INT, FALSE);
}

/**
  * @brief  adc configuration.
  * @param  none
  * @retval none
  */
static void adc_config(void)
{
  adc_common_config_type adc_common_struct;
  adc_base_config_type adc_base_struct;
  crm_periph_clock_enable(CRM_ADC1_PERIPH_CLOCK, TRUE);
  adc_reset();
  nvic_irq_enable(ADC1_2_IRQn, 0, 0);

  adc_common_default_para_init(&adc_common_struct);

  /* config combine mode */
  adc_common_struct.combine_mode = ADC_INDEPENDENT_MODE;

  /* config division,adcclk is division by hclk */
  adc_common_struct.div = ADC_HCLK_DIV_6;

  /* config common dma mode,it's not useful in independent mode */
  adc_common_struct.common_dma_mode = ADC_COMMON_DMAMODE_DISABLE;

  /* config common dma request repeat */
  adc_common_struct.common_dma_request_repeat_state = FALSE;

  /* config adjacent adc sampling interval,it's useful for ordinary shifting mode */
  adc_common_struct.sampling_interval = ADC_SAMPLING_INTERVAL_5CYCLES;

  /* config inner temperature sensor and vintrv */
  adc_common_struct.tempervintrv_state = TRUE;

  adc_common_struct.vbat_state = FALSE;
  adc_common_config(&adc_common_struct);

  adc_base_default_para_init(&adc_base_struct);

  adc_base_struct.sequence_mode = FALSE;
  adc_base_struct.repeat_mode = FALSE;
  adc_base_struct.data_align = ADC_RIGHT_ALIGNMENT;
  adc_base_struct.ordinary_channel_length = 1;
  adc_base_config(ADC1, &adc_base_struct);
  adc_resolution_set(ADC1, ADC_RESOLUTION_12B);

  /* config ordinary channel */
  adc_ordinary_channel_set(ADC1, ADC_CHANNEL_17, 1, ADC_SAMPLETIME_247_5);

  /* config ordinary trigger source and trigger edge */
  adc_ordinary_conversion_trigger_set(ADC1, ADC_ORDINARY_TRIG_TMR1CH1, ADC_ORDINARY_TRIG_EDGE_NONE);

  /* config dma mode,it's not useful when common dma mode is use */
  adc_dma_mode_enable(ADC1, TRUE);

  /* config dma request repeat,it's not useful when common dma mode is use */
  adc_dma_request_repeat_enable(ADC1, TRUE);

  /* enable adc overflow interrupt */
  adc_interrupt_enable(ADC1, ADC_OCCO_INT, TRUE);

  /* enable adc trigger convert fail interrupt */
  adc_interrupt_enable(ADC1, ADC_TCF_INT, TRUE);

  /* enable adc trigger conversion fail auto conversion abort */
  adc_convert_fail_auto_abort_enable(ADC1, TRUE);

  /* adc enable */
  adc_enable(ADC1, TRUE);
  while(adc_flag_get(ADC1, ADC_RDY_FLAG) == RESET);

  /* adc calibration */
  adc_calibration_init(ADC1);
  while(adc_calibration_init_status_get(ADC1));
  adc_calibration_start(ADC1);
  while(adc_calibration_status_get(ADC1));
}

/**
  * @brief  this function handles adc handler.
  * @param  none
  * @retval none
  */
void ADC1_2_IRQHandler(void)
{
  if(adc_interrupt_flag_get(ADC1, ADC_TCF_FLAG) != RESET)
  {
    adc_flag_clear(ADC1, ADC_TCF_FLAG);
    adc1_conversion_fail_flag++;

    /* to avoid data wrong,it is recommended to add the following recovery code */
    adc_enable(ADC1, FALSE);
    dma_channel_enable(DMA1_CHANNEL1, FALSE);
    dma_flag_clear(DMA1_FDT1_FLAG);
    dma_data_number_set(DMA1_CHANNEL1, 1);
    dma_channel_enable(DMA1_CHANNEL1, TRUE);
    adc_enable(ADC1, TRUE);
  }
	
	if(adc_interrupt_flag_get(ADC1, ADC_OCCO_FLAG) != RESET)
  {
    adc_flag_clear(ADC1, ADC_OCCO_FLAG);
    adc1_overflow_flag++;

    /* to avoid data wrong,it is recommended to add the following recovery code */
    adc_enable(ADC1, FALSE);
    dma_channel_enable(DMA1_CHANNEL1, FALSE);
    dma_flag_clear(DMA1_FDT1_FLAG);
    dma_data_number_set(DMA1_CHANNEL1, 1);
    dma_channel_enable(DMA1_CHANNEL1, TRUE);
    adc_enable(ADC1, TRUE);
  }
}

/**
  * @brief  main function.
  * @param  none
  * @retval none
  */
int main(void)
{
  nvic_priority_group_config(NVIC_PRIORITY_GROUP_4);

  /* config the system clock */
  system_clock_config();

  /* init at start board */
  at32_board_init();
  at32_led_off(LED2);
  at32_led_off(LED3);
  at32_led_off(LED4);
  uart_print_init(115200);
  dma_config();
  adc_config();

  /* enable DMA after ADC activation */
  dma_channel_enable(DMA1_CHANNEL1, TRUE);

  printf("adc1_vref_check \r\n");
  while(1)
  {
    at32_led_toggle(LED2);
    delay_sec(1);

    /* adc1 software trigger start conversion */
    adc_ordinary_software_trigger_enable(ADC1, TRUE);

    /* wait conversion end */
    while(dma_flag_get(DMA1_FDT1_FLAG) == RESET);
    
    dma_flag_clear(DMA1_FDT1_FLAG);
    printf("vref_value = %f V\r\n", ((double)1.2 * 4095) / adc1_ordinary_value);
    if(error_times_index != (adc1_overflow_flag + adc1_conversion_fail_flag))
    {
      /* printf flag when error occur */
      error_times_index = adc1_overflow_flag + adc1_conversion_fail_flag;
      at32_led_on(LED3);
      at32_led_on(LED4);
      printf("error occur\r\n");
      printf("error_times_index = %d\r\n",error_times_index);
      printf("adc1_overflow_flag = %d\r\n",adc1_overflow_flag);
      printf("adc1_conversion_fail_flag = %d\r\n",adc1_conversion_fail_flag);
    }
  }
}

/**
  * @}
  */

/**
  * @}
  */
