andrewlau2080/IO_BOARD/.vendor/AT32F45x_Firmware_Library_V2.0.1/project/at_start_f455/examples/i2s/spii2s_switch_halfduplex_polling/src/main.c

/**
  **************************************************************************
  * @file     main.c
  * @brief    main program
  **************************************************************************
  *
  * Copyright (c) 2025, Artery Technology, All rights reserved.
  *
  * The software Board Support Package (BSP) that is made available to
  * download from Artery official website is the copyrighted work of Artery.
  * Artery authorizes customers to use, copy, and distribute the BSP
  * software and its related documentation for the purpose of design and
  * development in conjunction with Artery microcontrollers. Use of the
  * software is governed by this copyright notice and the following disclaimer.
  *
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
  **************************************************************************
  */

#include "at32f45x_board.h"
#include "at32f45x_clock.h"

/** @addtogroup AT32F455_periph_examples
  * @{
  */

/** @addtogroup 455_I2S_spii2s_switch_halfduplex_polling I2S_spii2s_switch_halfduplex_polling
  * @{
  */

#define SPI_MASTER_CS_HIGH   gpio_bits_set(GPIOA, GPIO_PINS_4)
#define SPI_MASTER_CS_LOW    gpio_bits_reset(GPIOA, GPIO_PINS_4)

uint16_t i2s1_buffer_tx[32] = {0x0102, 0x0304, 0x0506, 0x0708, 0x090A, 0x0B0C,
                               0x0D0E, 0x0F10, 0x1112, 0x1314, 0x1516, 0x1718,
                               0x191A, 0x1B1C, 0x1D1E, 0x1F20, 0x2122, 0x2324,
                               0x2526, 0x2728, 0x292A, 0x2B2C, 0x2D2E, 0x2F30,
                               0x3132, 0x3334, 0x3536, 0x3738, 0x393A, 0x3B3C,
                               0x3D3E, 0x3F40
                              };
uint16_t spi1_buffer_tx[32] = {0x5152, 0x5354, 0x5556, 0x5758, 0x595A, 0x5B5C,
                               0x5D5E, 0x5F60, 0x6162, 0x6364, 0x6566, 0x6768,
                               0x696A, 0x6B6C, 0x6D6E, 0x6F70, 0x7172, 0x7374,
                               0x7576, 0x7778, 0x797A, 0x7B7C, 0x7D7E, 0x7F80,
                               0x8182, 0x8384, 0x8586, 0x8788, 0x898A, 0x8B8C,
                               0x8D8E, 0x8F90
                              };
uint16_t i2s2_buffer_rx[32];
uint16_t spi2_buffer_rx[32];
__IO uint32_t tx_index = 0, rx_index = 0;
volatile error_status transfer_status1 = ERROR, transfer_status2 = ERROR, transfer_status3 = ERROR;

/**
  * @brief  buffer_compare function.
  * @param  none
  * @retval the result of compare
  */
error_status buffer_compare(uint16_t* pbuffer1, uint16_t* pbuffer2, uint16_t buffer_length)
{
  while(buffer_length--)
  {
    if(*pbuffer1 != *pbuffer2)
    {
      return ERROR;
    }

    pbuffer1++;
    pbuffer2++;
  }
  return SUCCESS;
}
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
