andrewlau2080/IO_BOARD/(commit log)

2026-06-03 Add IO_BOARD firmware project and IR polling status
    [STC15W_EEPROM.obj, TM1637.DWG, at32f455.cfg, at32f_fixture.xlsx, at32f_fixture250724.xlsx, atlink-cmsis-dap.cfg, main.obj, printer_poll_tx_envelope.csv]
2026-06-03 Trigger tester IR response from printer polling
2026-06-03 Document Raspberry Pi RS485 scan control path
2026-06-19 Add first-gen self-learn scan display flow
2026-06-19 Document first-gen self-learn and IR print next step
2026-07-02 Add first-gen print flow and hardware redesign docs
    [io_board.c, ir_remote.c, ir_remote.h, lcdm_tjc.c, lcdm_tjc.h, line_comm_transport.c, line_comm_transport.h, main.c]
2026-07-05 Document TJC LCDM PB3 PB5 wiring
2026-07-05 Align IO map with 2026-07-05 schematic
2026-07-05 Update 2026-07-05 schematic PDF
2026-07-07 docs: update fixture IO and WiFi MAS design
    [io_board.c]
2026-07-12 Backup isolated LCDM driver reference
2026-07-15 Fix LCDM touch isolation
    [first_gen_display.c, lcdm_motor_ui.c]
2026-07-15 Remove LCDM coordinate swap fallback
    [first_gen_display.c, lcdm_motor_ui.c]
2026-07-15 Record LCDM touch follow-up issues
    [first_gen_display.c, lcdm_motor_ui.c]
2026-07-22 Improve LCDM tester UI flow
    [界面说明.xlsx, 界面说明260722.xlsx]
2026-07-25 Improve auto test scan record display
    改善自动测试扫描记录内容显示部分
2026-07-28 fix(lcdm): 修复指令传送丢失并更新宋体字库
    根因：LCDM 在前一条 fill/xstr 尚未完成时接收后续绘制指令，导致黑格、白格和缺号。改为 bkcmd=3 成功回执串行传送，取消大网格 ref_stop/ref_star 堆积，并将学习颜色延后到完整矩阵完成后绘制。
    同步加入 260728song.tft 宋体字库、实际 TJC font ID 对照和固件字体映射。
    [first_gen_display.c, first_gen_display.h, lcdm_tjc.c, lcdm_tjc.h]
2026-07-28 feat(lcdm): 测试结果排序完成
2026-07-28 feat(lcdm): 增加 PASS,NG 界面（未完善）
2026-07-29 fix(lcdm): 修改PASS/NG显示逻辑
2026-07-30 fix(lcdm): 改善NG下复现PASS和添加打印二个界面
2026-08-02 feat(lcdm): 完成WIFI设置界面
    加入 LCDM WiFi/机身设置页、K3 长按入口、ESP-AT 连接状态机、MAC 持久化及配置区与学习区隔离。
2026-08-02 因WIFI改192M频率影响扫描，解决WIFI设置和扫描，剩打印部分
2026-08-04 打印侧完成WIFI设置
2026-08-06 feat(print): 测试机与打印侧WIFI打印衔接（PRINTING状态机+打印模拟）
    - tester侧：PRINTING/PRINTER FAULT/NETWORK ERROR 三态事件与LCDM页面分开
    - 打印侧：PRINTING状态、5秒打印模拟后回DONE、打印中锁定设置/按键/触摸
    - 主机侧：PRINTING帧去重状态、NETWORK ERROR状态文本、send_printing接口
    - 协议文档同步 ACK/PRINTING/DONE/ERROR 帧与验收步骤
    - PRINT_TERMINAL_SIMULATE_PRINT=1 供无实体打印机联调，接入RS232后替换
    [first_gen_display.c, first_gen_display.h, print_host_wifi.c, print_host_wifi.h, print_terminal.c, print_terminal.h]
2026-08-06 docs: 记录双DAP角色映射（807=打印侧, 407=测试机侧）
2026-08-06 feat(wifi): ESP-AT自动踢活重连机制，断网/卡死无需人工干预
    - tester_wifi_print.c：新增 WIFI_ENGINE_ESP_KICK 状态，每次会话启动前
    发 +++ 退出透传序列踢活卡死 ESP；kick 窗口内的 +++ ERROR 被忽略，
    不误判为 AT/CWJAP 失败
    - print_host_wifi.c：打印侧同样在每次 start/重连前 +++ 踢活，
    host_waiting_command=NONE 期间屏蔽 +++ 响应，到期后进入 AT 序列
    - 断网/卡死：backoff 后重新踢活 + 全序列重连，两侧自动恢复，
    不再需要断电或人工 K3 处理
    - 已验证：tester (PC=0x080143ED) 与 print-host (PC=0x0800B645)
    双板烧录向量表一致
    [print_host_wifi.c]
2026-08-06 fix(wifi): 8MHz软件UART回显污染修复 - ATE0关回显+会话RX冲刷
    根因：测试机跑8MHz HICK（扫描时钟），115200软件UART每bit仅69周期。
    ESP-AT默认回显（ATE1）与AT32发送窗口（TX期间关中断）重叠，回显边沿
    丢失产生残行，吞掉后续响应；生产会话每次踢活(+++)也产生同样污染，
    导致AT永远无响应、无限重连（实测reconnect=2345次，rx_error=3284）。
    修复：
    1. 生产会话：踢活窗口结束/会话开始时冲刷RX残行，AT从干净行开始
    2. 生产序列：AT之后插入ATE0（关回显），此后所有交换无回显污染
    3. K2网络测试：首步改为ATE0，消除'需按2次以上才通过'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
2026-08-06 fix(wifi): 踢活+++缺CRLF导致命令模式合并成+++AT - 两阶段踢活修复
    根因（板上实锤）：踢活发 '+++' 无 CRLF，命令模式下 ESP-AT 把它
    缓存为未完成命令，随后 AT 到达时合并为 '+++AT' 一条命令 → 回
    ERROR → 引擎/主机无限重试。透传模式下 +++ 按字节+保护期退出所以
    之前测试没暴露；烧录重启后 ESP 退回命令模式即触发。
    修复：踢活保持期结束后先发 CRLF 终止挂起行（其 ERROR 在踢活窗
    口内被守卫消费），200ms 后再发 AT。两侧同一机制。打印侧验证：
    重烧后第一次会话即 ONLINE（reconnect=0）。
    [print_host_wifi.c]
2026-08-06 feat(tester): 192MHz时钟与打印侧一致+上电自动连接WIFI
    - main.c FIRST_GEN_4051_LOCAL: system_core_clock_update()(8MHz) → tester_wifi_clock_config()(192MHz)
    - 移除 wifi_start_deferred 延迟机制：init/K3/设置退出均立即 tester_wifi_print_start()
    （上电/使用期间断网自动重连，无需手动触发，与打印主机行为一致）
    - 时钟影响审计（改前完成）：扫描=delay_us/SysTick+GPIO读(ADC块#if0)、
    LCDM波特率由PCLK推导(打印侧192MHz已验证)、IR/line_comm用g_cycles_per_us、
    蜂鸣器=ms模式GPIO、面板时基=DWT、delay fac_us 全部随 system_core_clock 缩放；
    ESP软件UART 69→1666 cycles/bit 是修复核心
    [main.c]
2026-08-06 style(lcdm): 两侧通过态绿色统一为PASS深绿色(992)
    - first_gen_display.c: 11处通过后绿色(PASS闪烁/文字/填充、WIFI连接图标、
    PRINT COMPLETE、WAITING FOR PRINTING、状态栏PASS/PRINT、表格已通点)改为
    LCDM_DARK_GREEN(992)；学习矩阵调色板(1929/1936)与IN标签(2813)保留原色
    - lcdm_motor_ui.c: PASS态用LCDM_DARK_GREEN(新增定义)
    - print_terminal.c: PRINT_LCDM_GREEN 2016→992（该侧所有绿色均为成功态）
    - 设置页K2早已用SETTINGS_WIFI_PASS_GREEN(992)，无需改动
2026-08-06 feat(wifi): 上电快速连接(2s启动宽限) + WIFI标志移到左上角
    - 两侧新增 ESP 上电启动宽限(TESTER/HOST_WIFI_ESP_BOOT_GRACE_MS=2000)：
    上电后 ESP-AT 需~1.5-2s启动，宽限内不发起首次会话，使第一次
    kick+AT 直接成功（打印侧实测烧录重启后 6.3s ONLINE，不再浪费
    一次 kick/超时/退避循环）
    - 测试机 WIFI 标志从右上角(394,1)移到左上角(2,1)，HALL IN 独占右上角
    - 打印侧头部左上角新增 WIFI 标志（在线深绿/离线灰，风格同测试机）
    - 修复：打印主机宽限分支先跑 tester_wifi_print_service() 保持时间基准，
    否则宽限永不结束
    [first_gen_display.c, print_host_wifi.c, print_terminal.c]
2026-08-06 docs: WiFi打印链路状态与关键决策档案（2026-08-06）
    含：双板固件状态表、192MHz时钟决策与时钟影响审计、上电自动连接、
    两阶段踢活、ATE0+冲刷、2s启动宽限（含时间基准坑）、深绿色统一992、
    WIFI标志左上角、烧录验证方法、已知问题与验收闭环 —— 供后续会话/Codex接手
2026-08-06 style(lcdm): WIFI/HALL标志在32px头栏垂直居中
    - 测试机 WIFI(2,1)与HALL IN(394,17)盒子 13px 改 18px、y=7
    （(32-18)/2，16px Song字体不再被裁切）
    - 打印侧左上角 WIFI 标志同步 (2,7,80,18)
    - 已验证双板烧录后均自动重连 ONLINE（tester engine=14/print state=5）
2026-08-06 docs: 档案更新 - 垂直居中已完成、WIFI LINK按用户决定关闭并留恢复方案
2026-08-06 docs: 档案记录打印侧ESP掉电后沉默的诊断证据与处理顺序
2026-08-06 docs: ESP-AT重烧准备就绪清单（镜像/定制NVS/esptool/一键脚本）
2026-08-06 docs: 两侧连接程序寄存器级一致性验证（EXINT/NVIC/GPIO 实测相同）
2026-08-06 docs: 进设置页才能连上的机制核查 - 非设置页修复，是ESP上电偶发不启动+断电恢复
2026-08-06 feat(wifi): 新增ESP上电首字节延迟诊断计数器
    - g_tester_wifi_print_esp_first_edge_ms：上电到ESP第一个RX边沿的时间
    - 在EXINT9_5边沿ISR捕获（读wifi_time_ms，~1ms精度，不受DWT 32位回绕影响）
    - init清零；两侧固件均含该符号，pyocd可直接读取
    - 用途：区分'ESP上电极慢/不启动'与'会话时序问题'，故障时一读便知
2026-08-06 docs: 记录测试机ESP会话中途复位后乱码现象与恢复方案（待断电复核）
2026-08-11 feat(wifi): 按PD LINE的UDP信标自动发现打印控制器，HOST/PORT自动填充
    - 打印侧：ONLINE后每3s广播信标(link4 UDP 255.255.255.255:5002)，载荷
    {"type":"beacon","line_id","ip","port"}，复用打印结果发送通道，
    链路忙/失败下周期再试，不影响TCP服务
    - 测试机：READ_IP后总是进入UDP通配监听(5002)，匹配本机PD LINE的信标后
    自动取得打印控制器地址端口并TCP建连；不间断重试直到发现并连上
    - 设置页：PRINT HOST/PORT字段保留显示，发现成功后自动填充(只读展示)，
    不再要求手动填写；K2测试同样认发现目标
    - 配对前提：两侧PD LINE必须完全一致（实测当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
2026-08-11 feat(settings): 多打印控制器选择+资料不完善禁保存并提示
    - 发现列表：UDP信标按IP去重登记最多4台控制器（含非本PD LINE的），
    供设置页展示与选择
    - 设置页 K1：发现到控制器时循环选择（已选 x/y + IP:PORT + PD LINE OK/无匹配
    提示），无发现时保持原编辑快捷键
    - 保存校验（K4/触摸OK）：SSID/PASSWORD/PD LINE 缺失、未发现控制器、
    PD LINE 无匹配、多台未选择 —— 一律阻止保存并红色提示缺什么
    - K2 链路测试：手动 HOST/PORT 优先，未手动填时用信标发现目标
    - 引擎连接目标：选中项优先，否则首个 PD LINE 匹配项
2026-08-11 feat(wifi): 两侧WiFi稳定性修复+自动连接完善
    打印侧(0x800c181):
    - 信标UDP广播禁用(反复建拆实测每5秒打掉ESP WiFi, mode0/2均验证)
    - 开机EN复位(PA8拉低100ms→释放, 6秒出绿不等看门狗)
    - NETWORK ERROR抑制: 首次ONLINE(host_ever_online)前不报错
    - 主屏头部WIFI状态更新闭环(状态文本+在线标志变化即重绘)
    - ONLINE期间WIFI DISCONNECT只JOIN级重连, 不杀会话状态机
    - 重试行号调试宏 host_schedule_retry_at(__LINE__)
    测试机侧(0x8014f69):
    - 开机EN复位移至启动函数(显示初始化后, 避免LCDM黑屏)
    - DISCOVER_WAIT超时不再重开会话: 保持UDP监听常开,
    消除反复CIPSTART/CIPCLOSE建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
    [print_host_wifi.c, print_terminal.c, print_terminal_settings.c]
2026-08-12 feat(wifi): 测试机侧按打印侧方案修复ONLINE期间断线(5秒断)
    按打印侧已验证的WIFI稳定方案移植到测试机侧:
    - WIFI DISCONNECT/DISCONNECTED在ONLINE/AP_ONLINE期间只做JOIN级重连
    (重发CWJAP), 不再杀会话状态机——ESP因路由器/PHY合法掉线时,
    全会话重启造成"绿5秒又断反复重连"(与打印侧652f941同修复)
    - CLOSED: 重连序列(JOIN_AP..CONNECT_HOST)中忽略(ESP掉WiFi时伴随
    上报); ONLINE期间CLOSED只轻量重连TCP, 不杀WiFi会话
    - READ_IP: 目标已知(本会话信标发现过/手动service_host配置完整)时
    跳过DISCOVER直接SET_MUX重建TCP——JOIN级重连不致卡死在等信标
    (打印侧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
2026-08-12 feat(wifi): 打印侧信标改常开链路+测试机侧信标窗口超时兜底建TCP
    打印侧(print_host_wifi.c):
    - 恢复信标广播(常开链路方案): link4 UDP 只在 ONLINE 首次 CIPSTART,
    之后每 3s 只 CIPSEND 广播 line_id/IP/监听端口, 不再反复建拆
    (旧方案实测每5秒打掉ESP WiFi; 用户改端口5006验证自动更新)
    - SERVER case 恢复 beacon 周期 + link_open 标志; beacon TX 失败
    下周期重开链路, 不计入业务错误
    测试机侧(tester_wifi_print.c):
    - READ_IP 后无条件进 DISCOVER(5秒窗口收信标, 自动更新 HOST/PORT)
    - DISCOVER_WAIT 超时改为关 UDP 用现有配置直接建 TCP——先建连,
    HOST/PORT 更新由下次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
2026-08-12 feat(wifi): 按用户架构改查询-响应式HOST/PORT同步(连接WiFi与同步解耦)
    用户架构: 两侧先连同一AP(独立) → PD LINE手工配对(L04) → 测试机侧
    WiFi正常后主动查询同线打印侧获取HOST/PORT → 建TCP → 一打印侧挂多测试机。
    - 不再周期广播信标(旧方案实测每5秒打WiFi), 改为ONLINE后开link4
    UDP通配监听5002(常开纯接收), 收到测试机侧PD LINE查询才回复
    - 新增HOST_CMD_BEACON_TX(临时切广播链路回复HOST/PORT), 回复完
    自动关广播重开监听; host_handle_query()按line_id匹配, 非本线忽略
    - BEACON_START改监听参数(0.0.0.0:0→5002, mode2)
    测试机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
2026-08-12 docs: 查询-响应式HOST/PORT同步架构决策档案(2026-08-12)
2026-08-12 fix(wifi): 打印侧host_ever_online上电清零(此前RAM随机值会误报NETWORK ERROR)
    init 未清零 host_ever_online, 上电后 RAM 随机值非0时 is_error() 门失效,
    首次 ONLINE 前就可能显示 NETWORK ERROR。现 init 显式清零。
    已烧录打印侧(向量0x0800c551匹配/CFSR/HFSR=0, init后ever_online=0验证)
    [print_host_wifi.c]
2026-08-12 fix(wifi): 测试机侧生产流程对齐手动连接(零UDP)+CWJAP数字错误快速失败
    用户基点: 手动连接(K2)稳定, 生产流程"连几秒又退出"。
    1. READ_IP 后有配置目标(手动/发现)直接建 TCP, 不再进 DISCOVER——
    UDP 广播查询/监听实测打 WiFi(与打印侧信标同根因), 手动连接无
    UDP 所以稳定, 生产流程对齐该行为; UDP 查询仅保留给无配置场景
    2. 新增 +CWJAP:<err> 数字错误处理(打印侧已有, 测试机侧缺失):
    CWJAP 失败时立即重连, 不再干等 OK 直到 20s JOIN 超时
    (1=超时 2=密码错 3=找不到AP 4=连接失败)
    已烧录(向量0x08015419/CFSR=0)。端到端验证待 ESP 冷启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
2026-08-12 fix(wifi): 打印侧禁用UDP监听自动开——UDP链路打WiFi导致测试机深绿消失
    重新审视设计: 实测 UDP 链路(mode0/2)会触发 ESP 周期 WIFI DISCONNECT
    (652f941 A/B 验证), 打印侧曾因信标禁用(零UDP)而"自由顺畅连接"。
    e042f64 给打印侧加的常开 UDP 监听(5002)又把 UDP 操作带回来:
    打印侧 ONLINE→开UDP监听→打WiFi→打印侧掉线
    →测试机TCP断(CLOSED)→测试机深绿消失
    →打印侧重连→再开监听→再掉…… 循环
    这解释用户现场"转深绿又没了"(测试机连锁受害), 手动连接(K2)无UDP
    所以稳定。修复: 打印侧 ONLINE 后 host_beacon_deadline_ms=0(不自动开
    UDP 监听)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
    [print_host_wifi.c]
2026-08-13 docs: WiFi双向打印通讯学习档案(2026-08-13) — PASS程序勿动/ESP异常断电重启/旧引擎链路
2026-08-14 fix(wifi): 改WIFI连接，打印侧停在完成后无法转变到HOST同步状态待查
    - 两侧恢复今天最新 HEAD 3309dc4 并烧录验证(测试侧407/打印侧807)
    - 新增 tester_host_wifi 打印控制器独立固件模块(8-13创建,待接入构建)
    - 待查: 打印侧停在完成后无法转变到 HOST 同步状态
